KTH-SML/svea_parts/README.md

# svea_parts
https://github.com/KTH-SML/SVEA-PX4-Autopilot-MCU-Peripheral
