KTH-SML/svea_parts/SVEA_Main_Platform.pdf

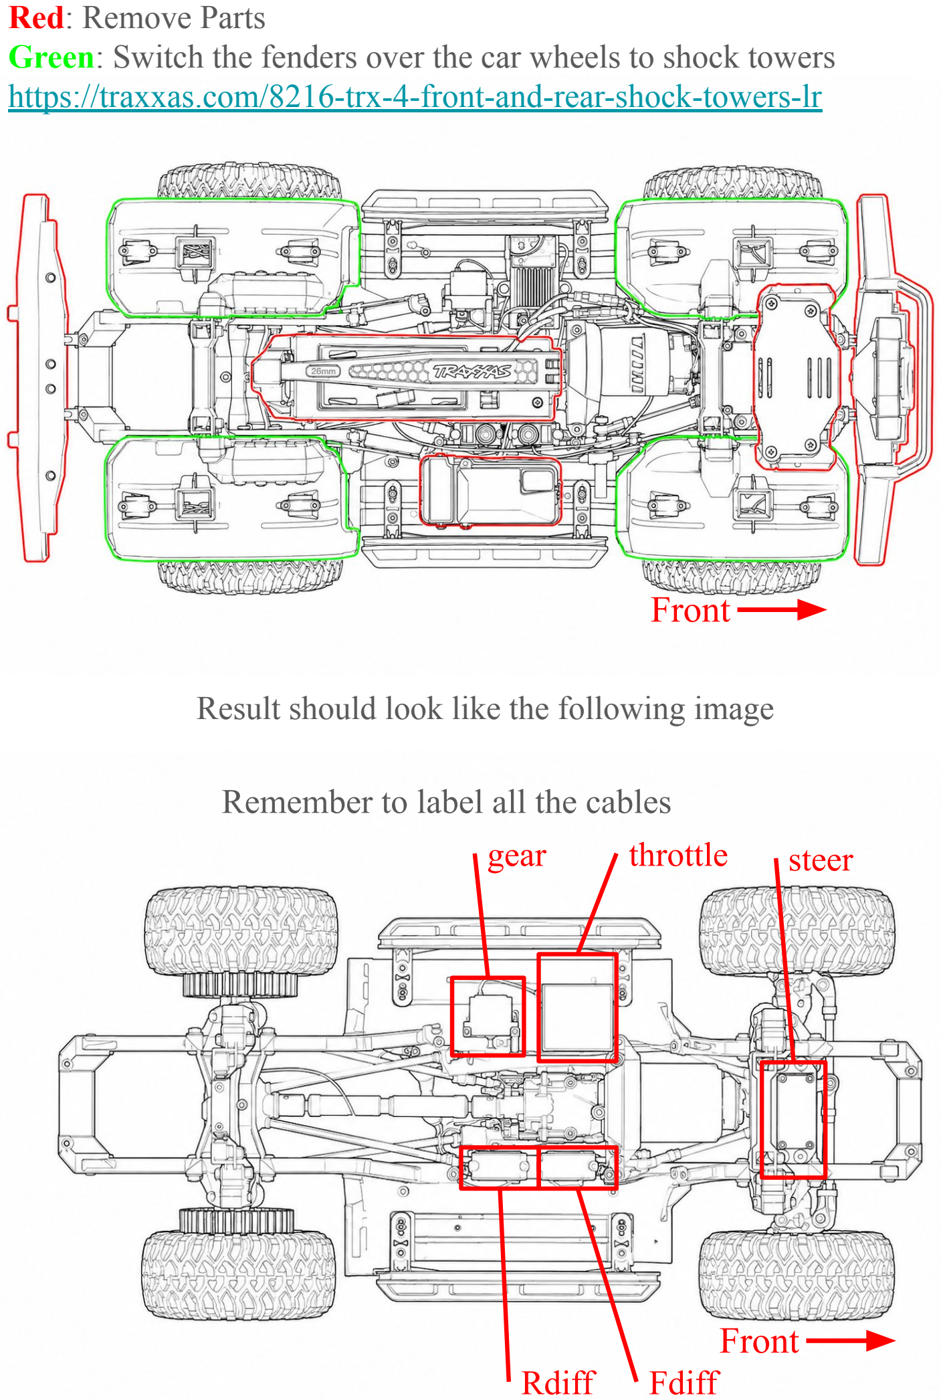
[picture p1: page 1]

Red: Remove Parts
Green: Switch the fenders over the car wheels to shock towers https://traxxas.com/8216-trx-4-front-and-rear-shock-towers-lr

Result should look like the following image

Rdiff | Fdiff
gear | throttle | steer

Remember to label all the cables

Front

Front

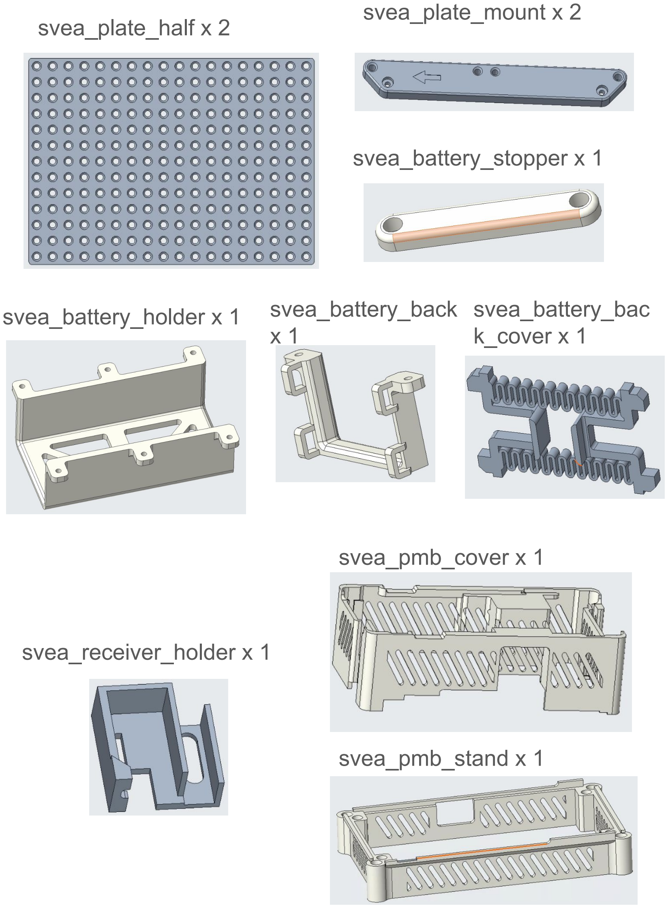
[picture p2: page 2]

svea_plate_half x 2

svea_battery_holder x 1 svea_battery_back x 1 svea_battery_bac
k_cover x 1

svea_receiver_holder x 1

svea_pmb_stand x 1

svea_pmb_cover x 1

svea_plate_mount x 2

svea_battery_stopper x 1

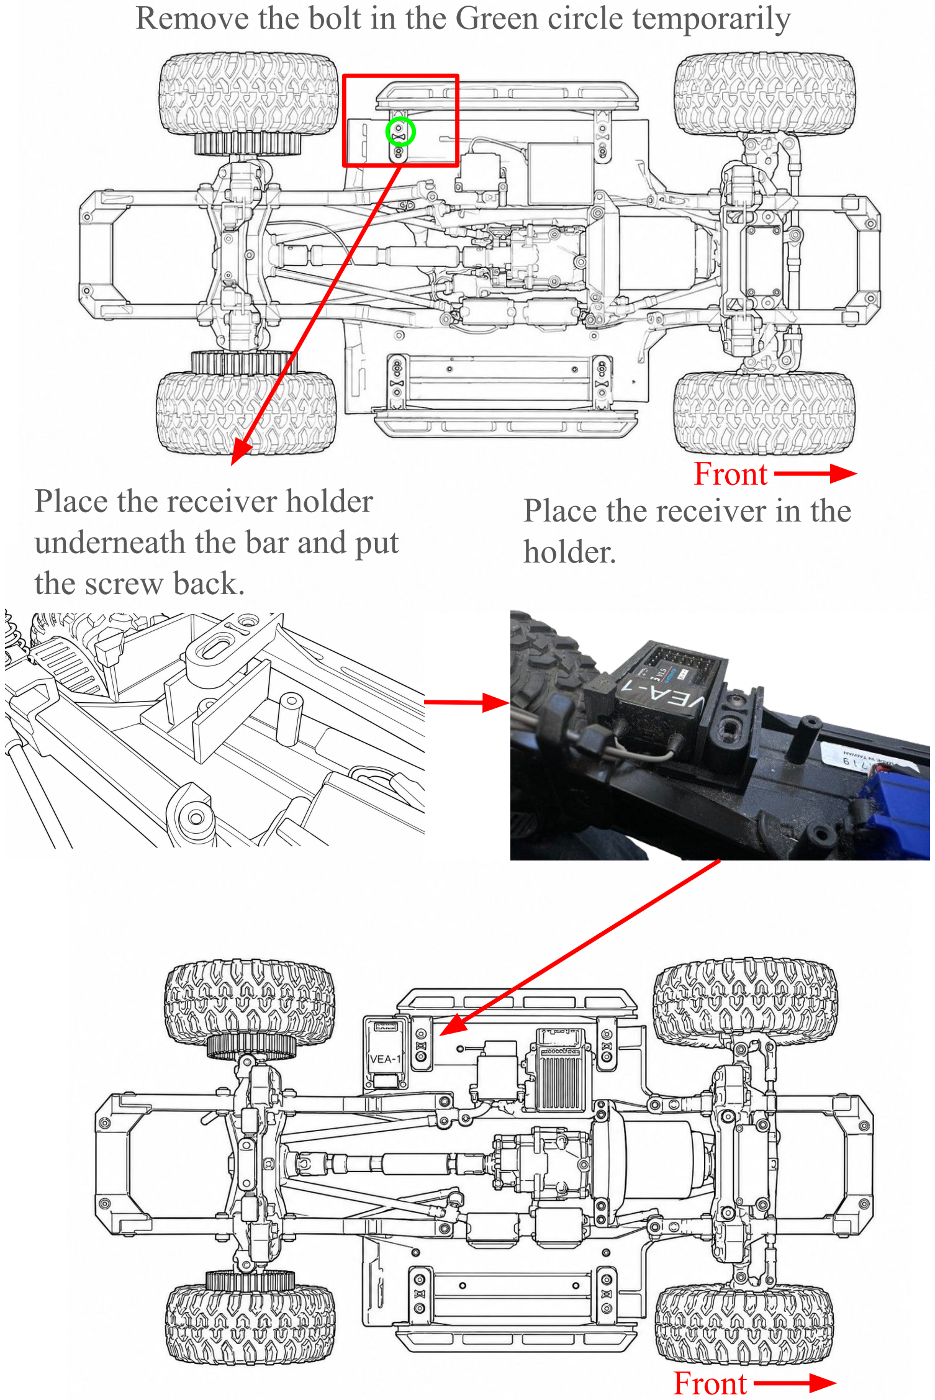
[picture p3: page 3]

Remove the bolt in the Green circle temporarily

Place the receiver holder
underneath the bar and put the screw back.

Place the receiver in the
holder.

Front

Front

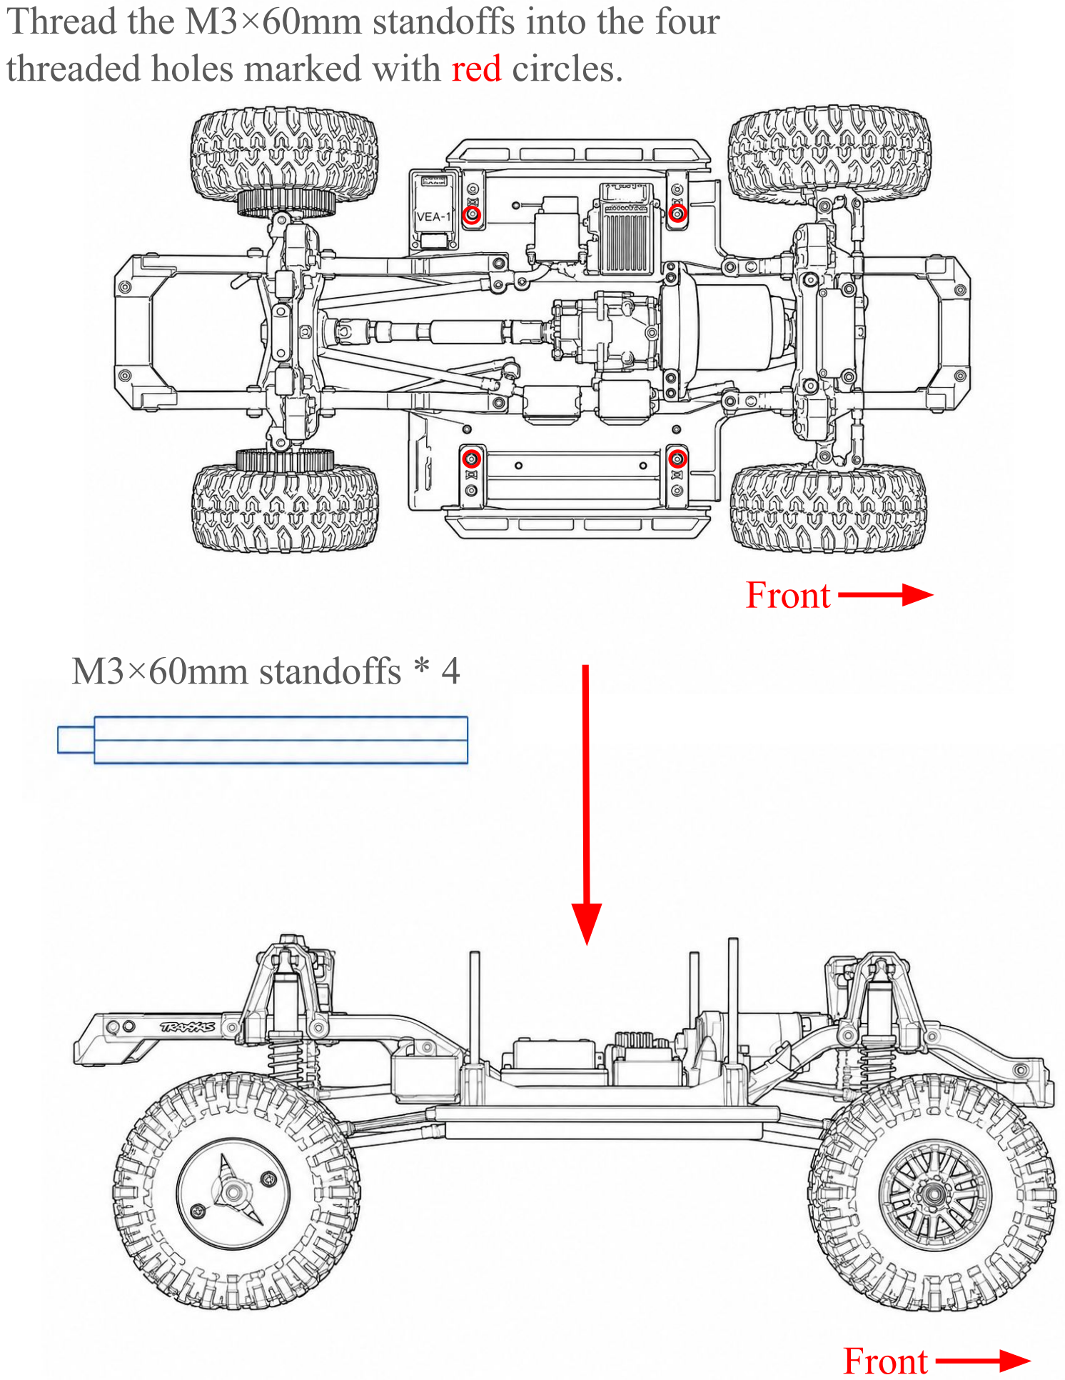
[picture p4: page 4]

Thread the M3×60mm standoffs into the four threaded holes marked with red circles.

M3×60mm standoffs * 4

Front

Front

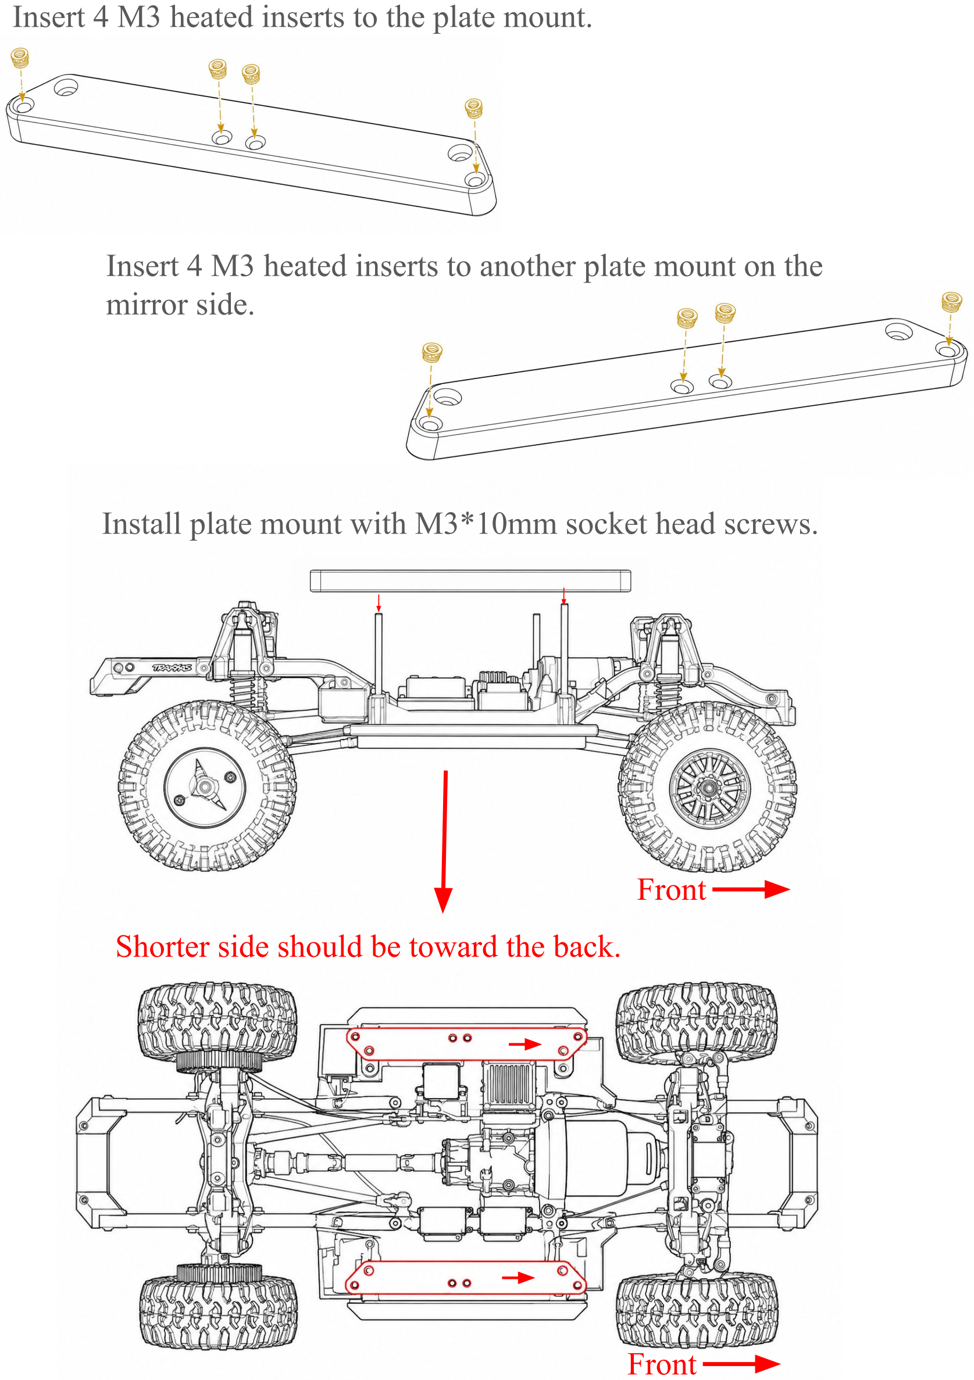
[picture p5: page 5]

Insert 4 M3 heated inserts to the plate mount.

Insert 4 M3 heated inserts to another plate mount on the mirror side.

Install plate mount with M3*10mm socket head screws.

| Front

Shorter side should be toward the back.

Front

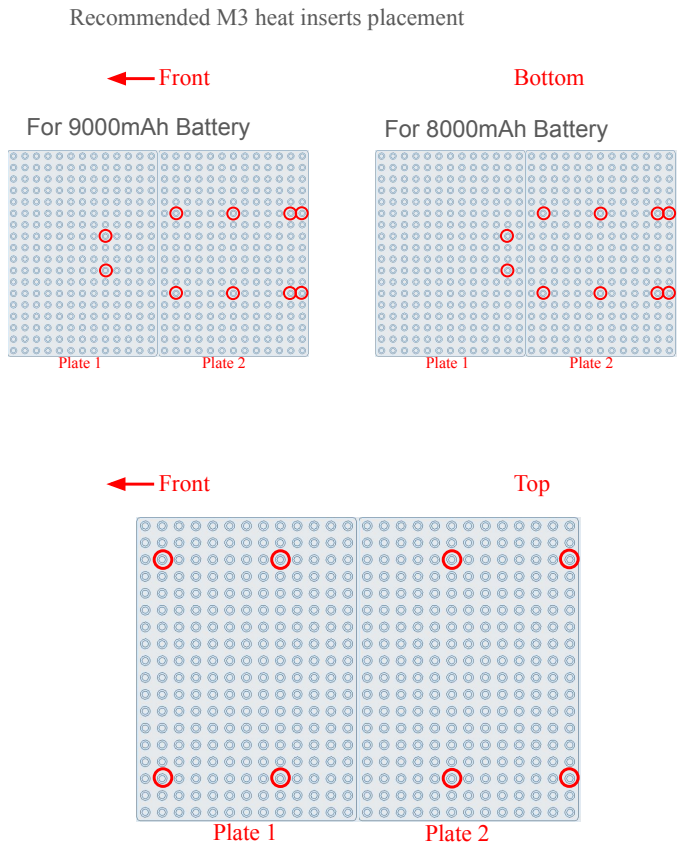
[picture p6: page 6]
Front; Bottom; Top; Plate 1; Plate 2; For 9000mAh Battery; For 8000mAh Battery

Recommended M3 heat inserts placement

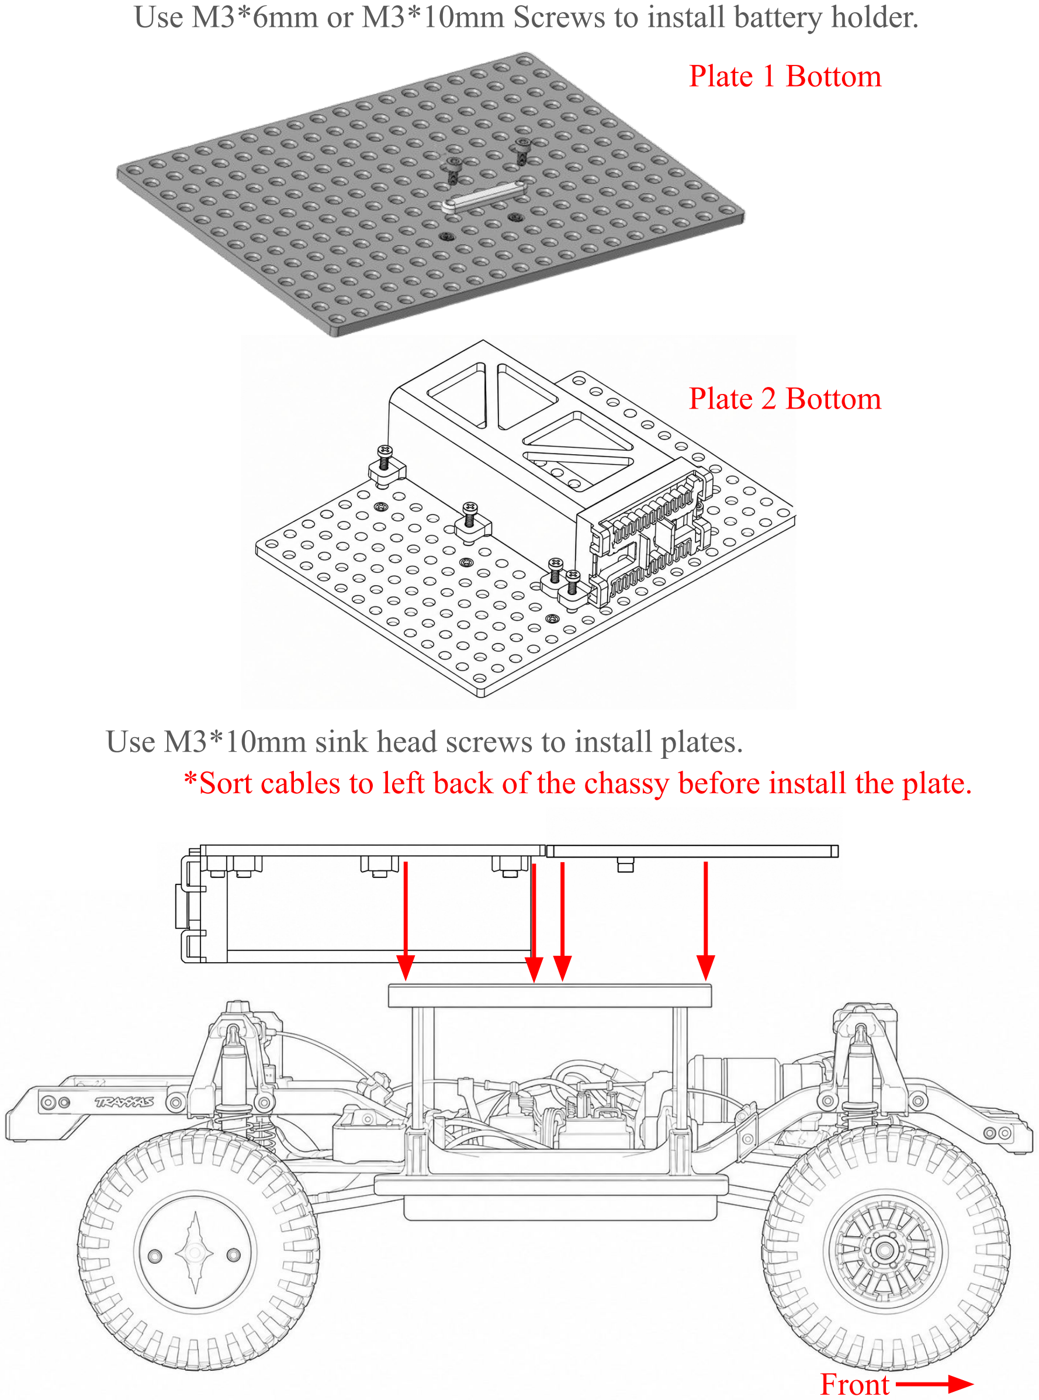
[picture p7: page 7]

Use M3*6mm or M3*10mm Screws to install battery holder.

Plate 2 Bottom

Plate 1 Bottom

Use M3*10mm sink head screws to install plates. *Sort cables to left back of the chassy before install the plate.

Front

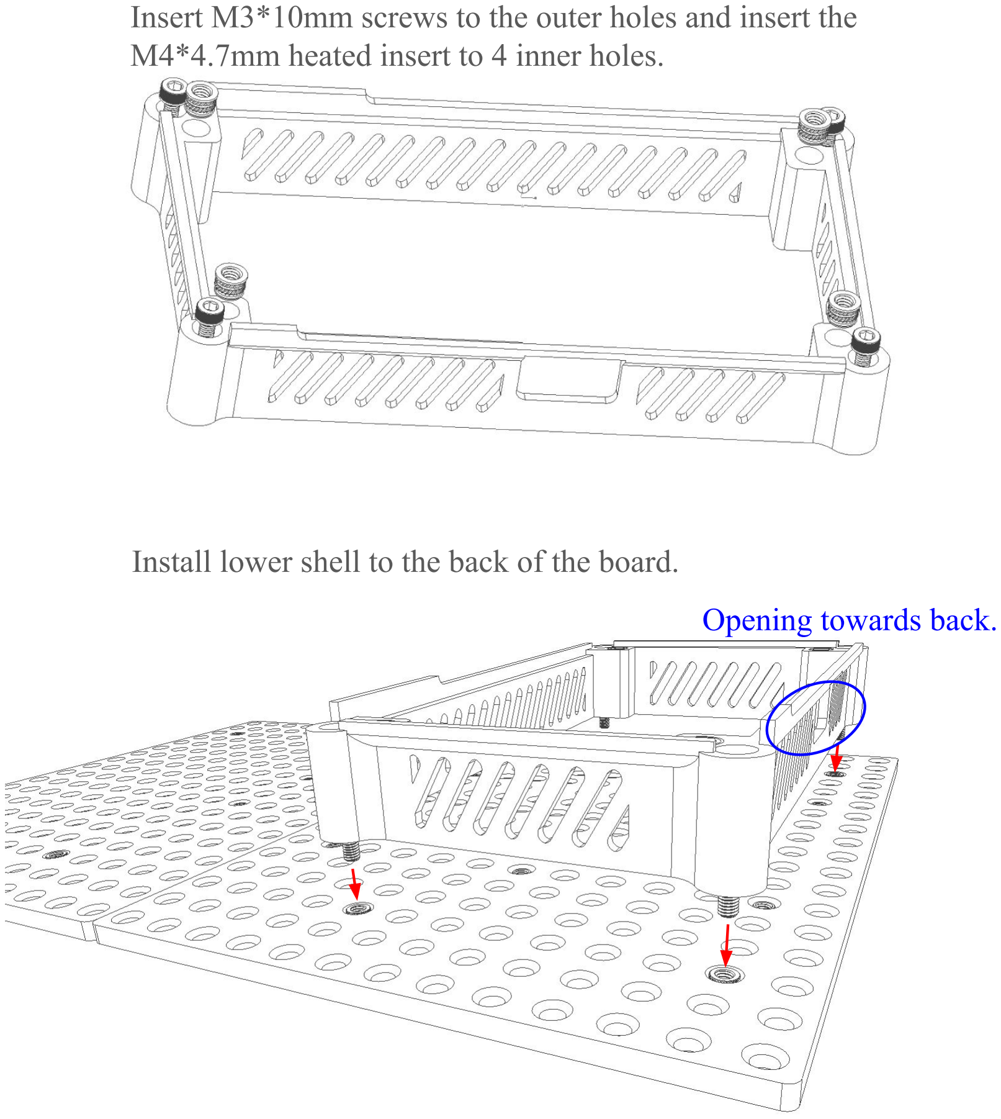
[picture p8: page 8]

Insert M3*10mm screws to the outer holes and insert the M4*4.7mm heated insert to 4 inner holes.

Install lower shell to the back of the board.

Opening towards back.

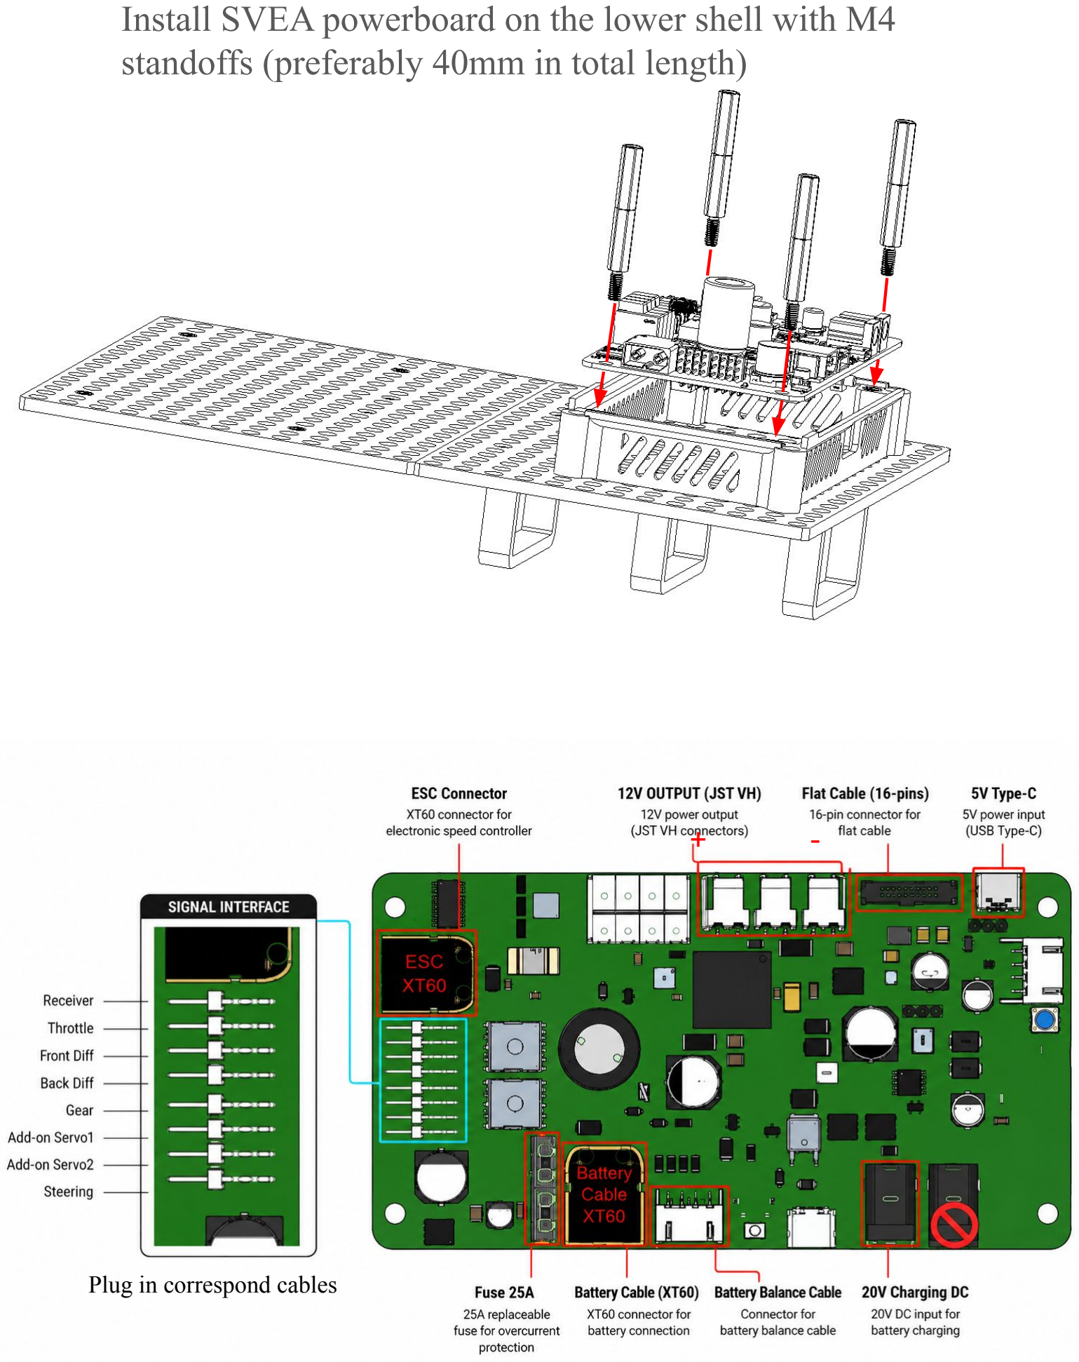
[picture p9: page 9]

Install SVEA powerboard on the lower shell with M4 standoffs (preferably 40mm in total length)

Plug in correspond cables

+ | -

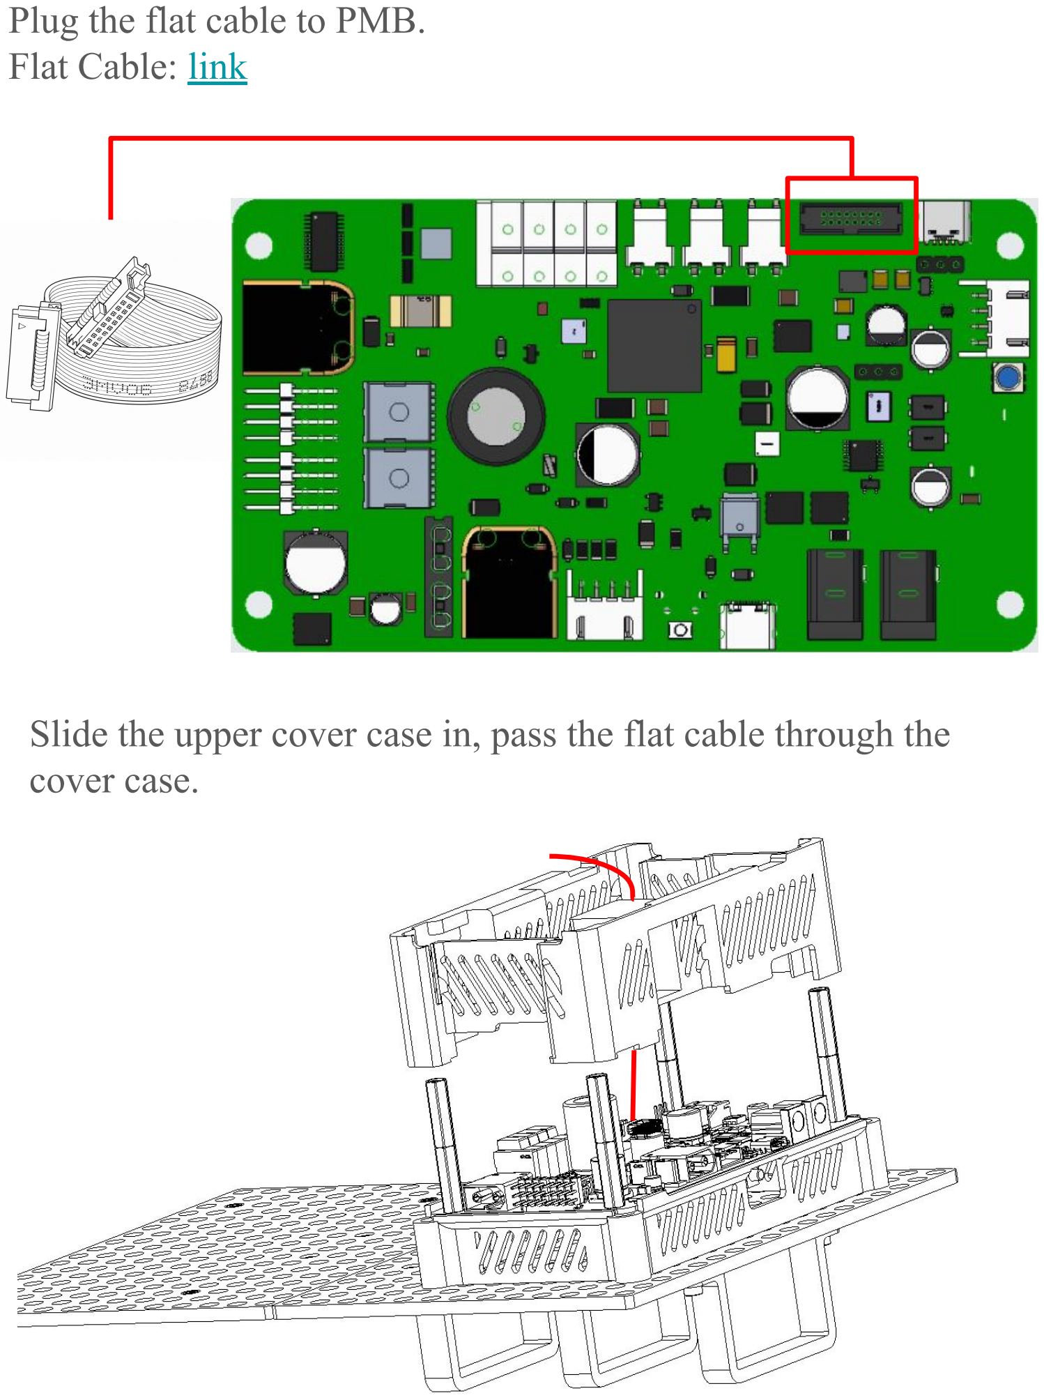
[picture p10: page 10]

Slide the upper cover case in, pass the flat cable through the cover case.

Plug the flat cable to PMB. Flat Cable: link (https://www.mikroe.com/flat-cable-with-16-pin-female-connectors-20-cm)

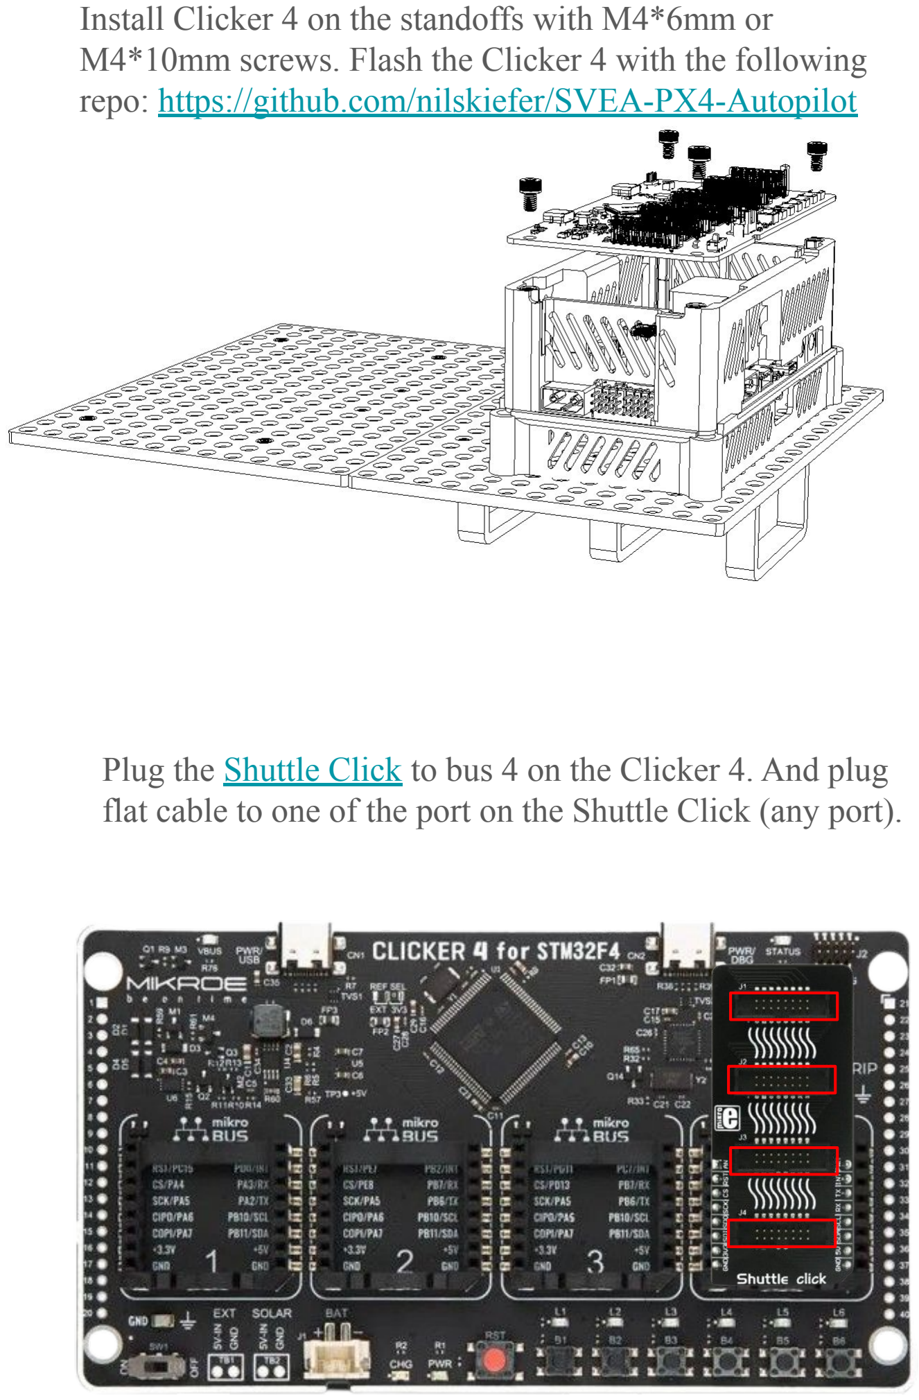
[picture p11: page 11]

Install Clicker 4 on the standoffs with M4*6mm or M4*10mm screws. Flash the Clicker 4 with the following repo: https://github.com/nilskiefer/SVEA-PX4-Autopilot

Plug the Shuttle Click (https://www.mikroe.com/shuttle-click) to bus 4 on the Clicker 4. And plug flat cable to one of the port on the Shuttle Click (any port).

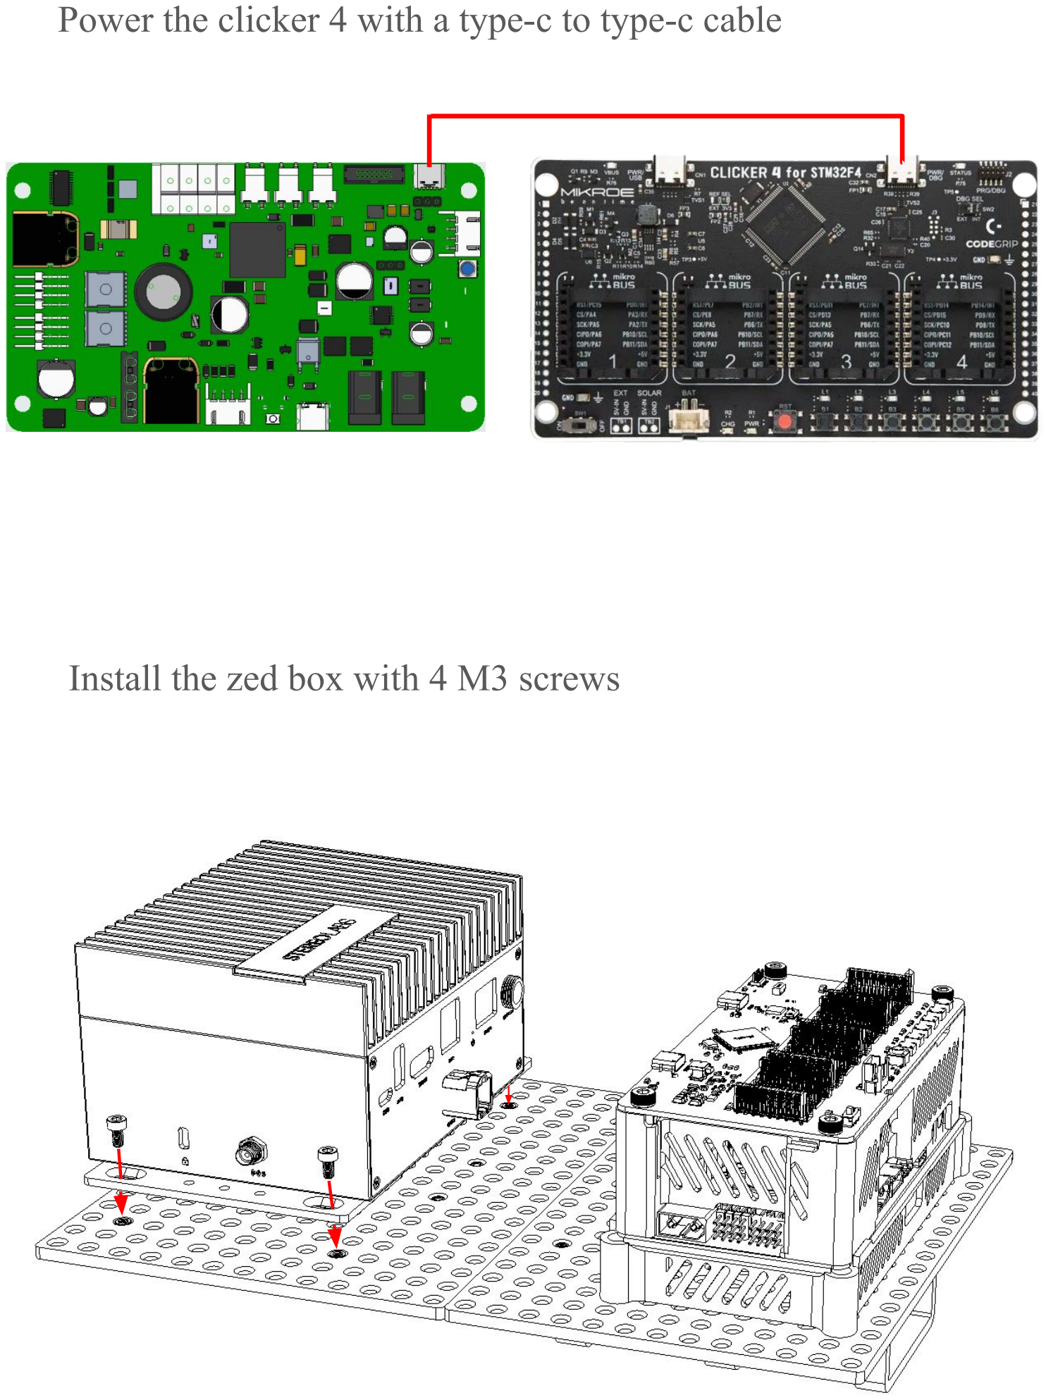
[picture p12: page 12]

Install the zed box with 4 M3 screws

Power the clicker 4 with a type-c to type-c cable

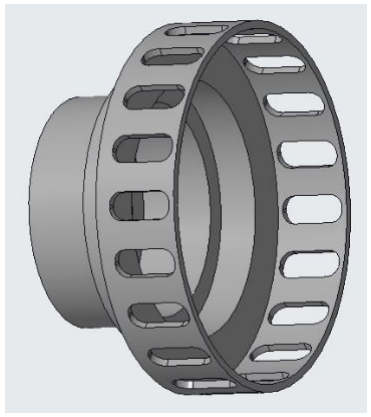
[picture p13: figure]
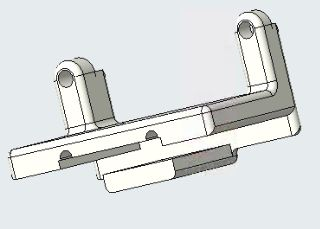
[picture p14: figure]

svea_esp32_mount x 1

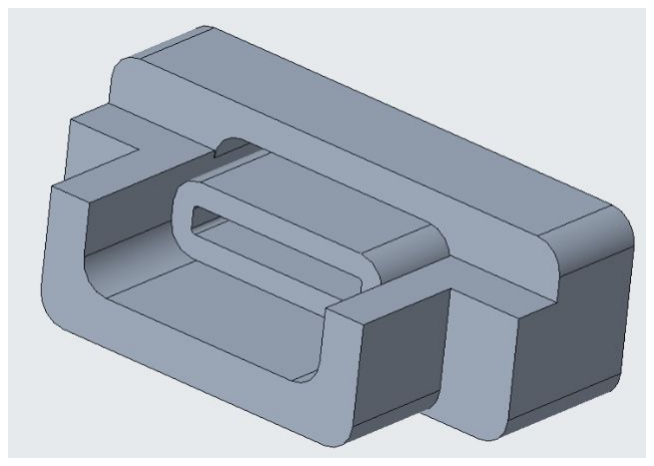
[picture p15: figure]

svea_esp32_type_c_plug x 1

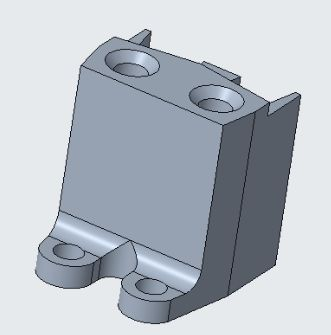
[picture p16: figure]

svea_duel_encoders_mount
x 2

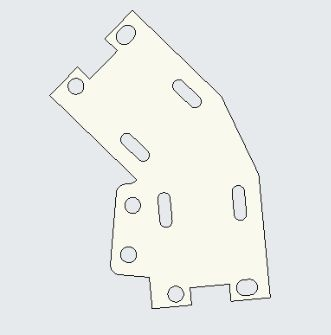
[picture p17: figure]

svea_duel_encoders_plate
x 2

svea_wheel_encoder x 2

## Encoder

Install h2010 IR sensor to the Insert the m3 heat insert to

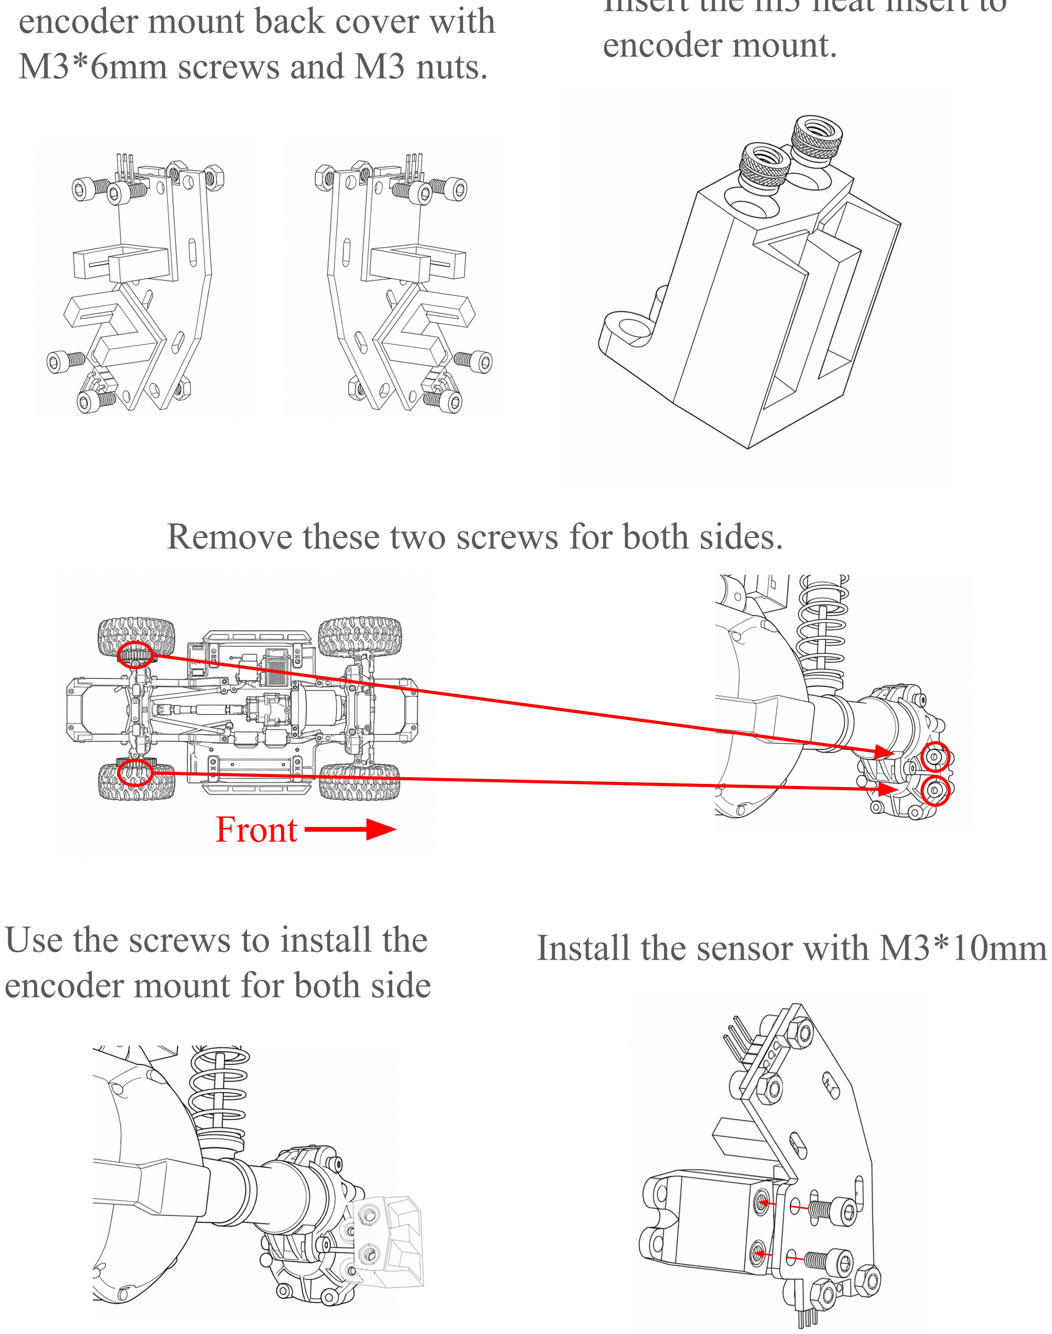
[picture p18: figure]
encoder mount back cover with M3*6mm screws and M3 nuts.; encoder mount.; Remove these two screws for both sides.; Use the screws to install the encoder mount for both side; Install the sensor with M3*10mm; Front

## Encoder Disk

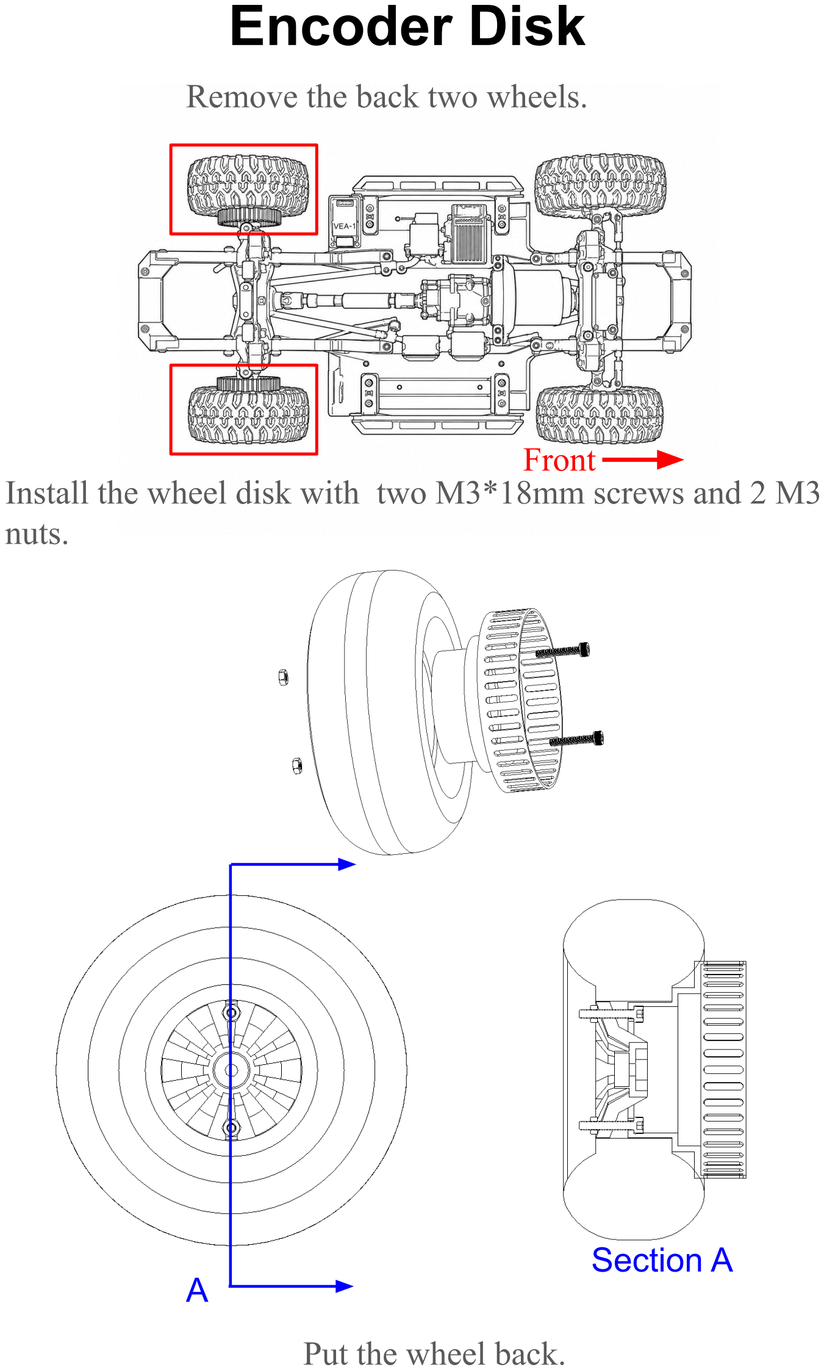
[picture p19: page 15]

Remove the back two wheels.

Install the wheel disk with two M3*18mm screws and 2 M3 nuts.

Put the wheel back.

A

Section A

Front

## Encoder Chip ESP32

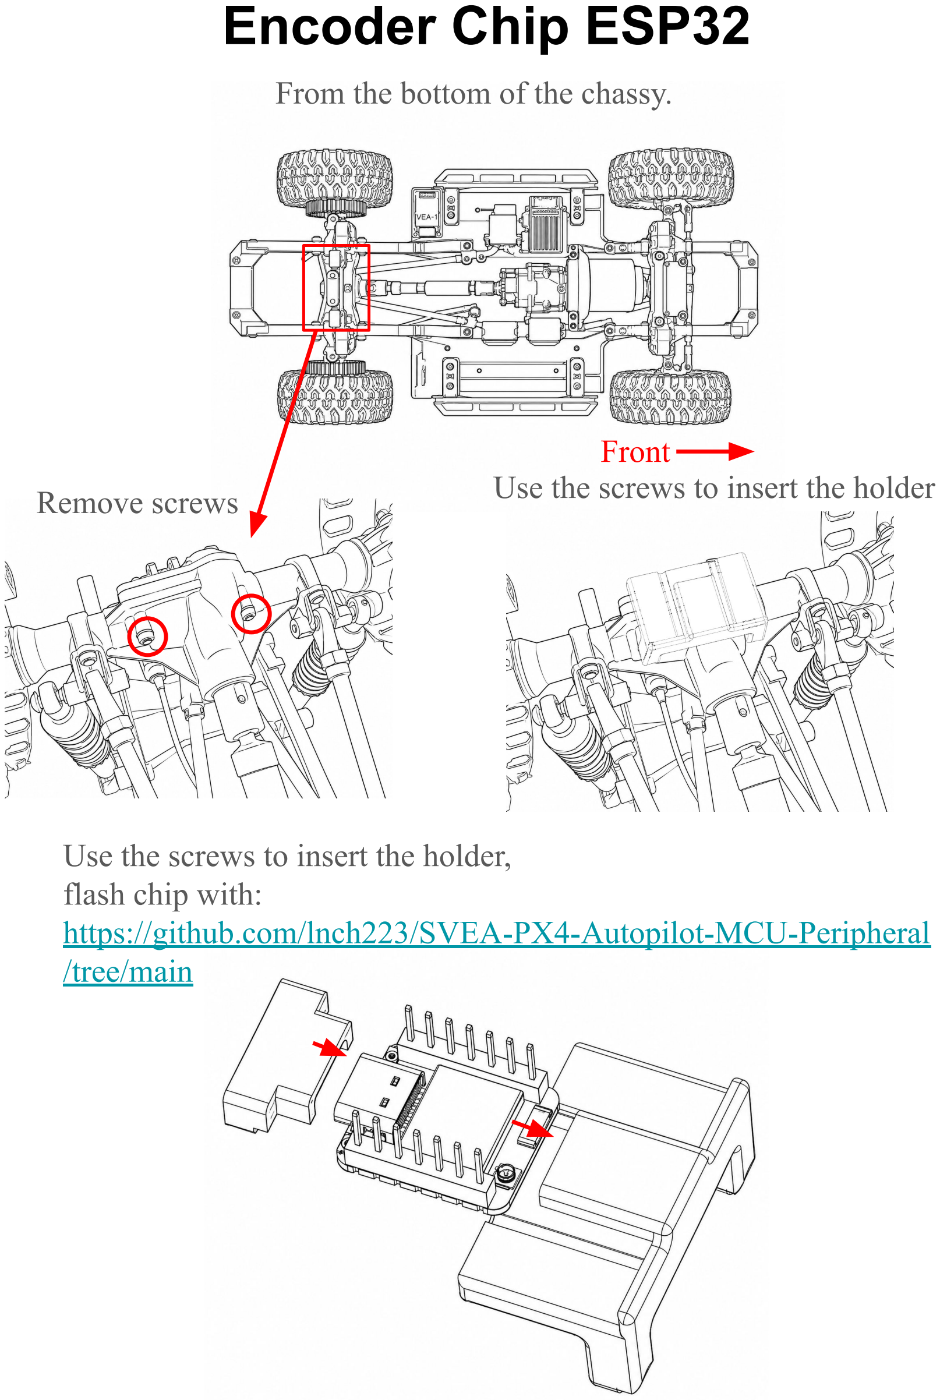
[picture p20: page 16]

From the bottom of the chassy.

Remove screws | Use the screws to insert the holder

Use the screws to insert the holder,
flash chip with:
https://github.com/lnch223/SVEA-PX4-Autopilot-MCU-Peripheral/tree/main (https://github.com/lnch223/SVEA-PX4-Autopilot-MCU-Peripheral/tree/main)

Front

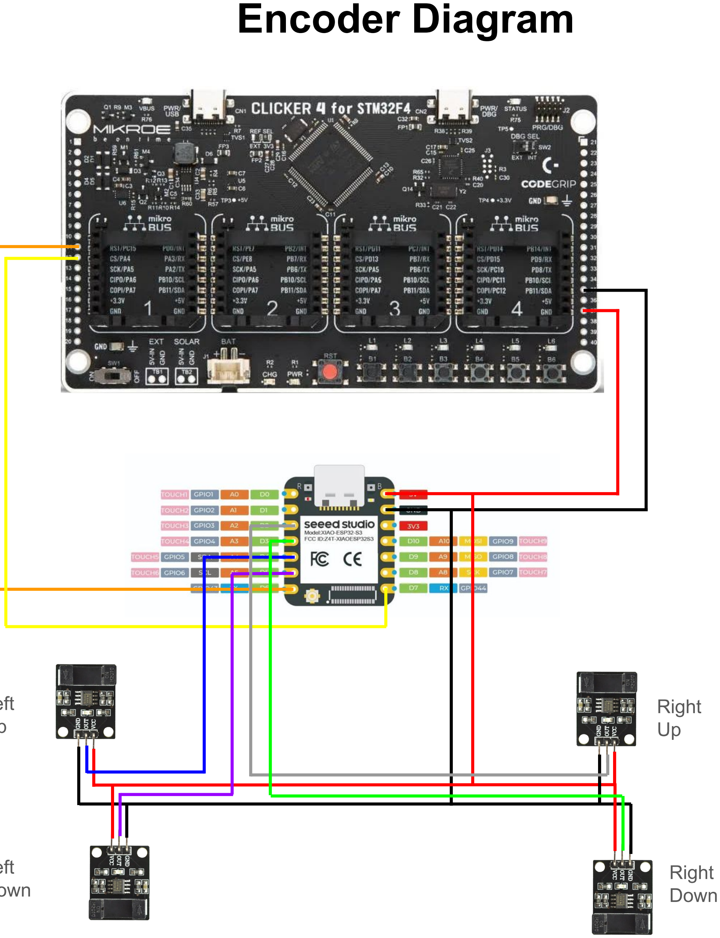
[picture p21: figure]
Down; Right Up; Right Down; Encoder Diagram

Left
Up

Left
