KTH-SML/svea_parts/SVEA_Accessories.pdf

## Lidar

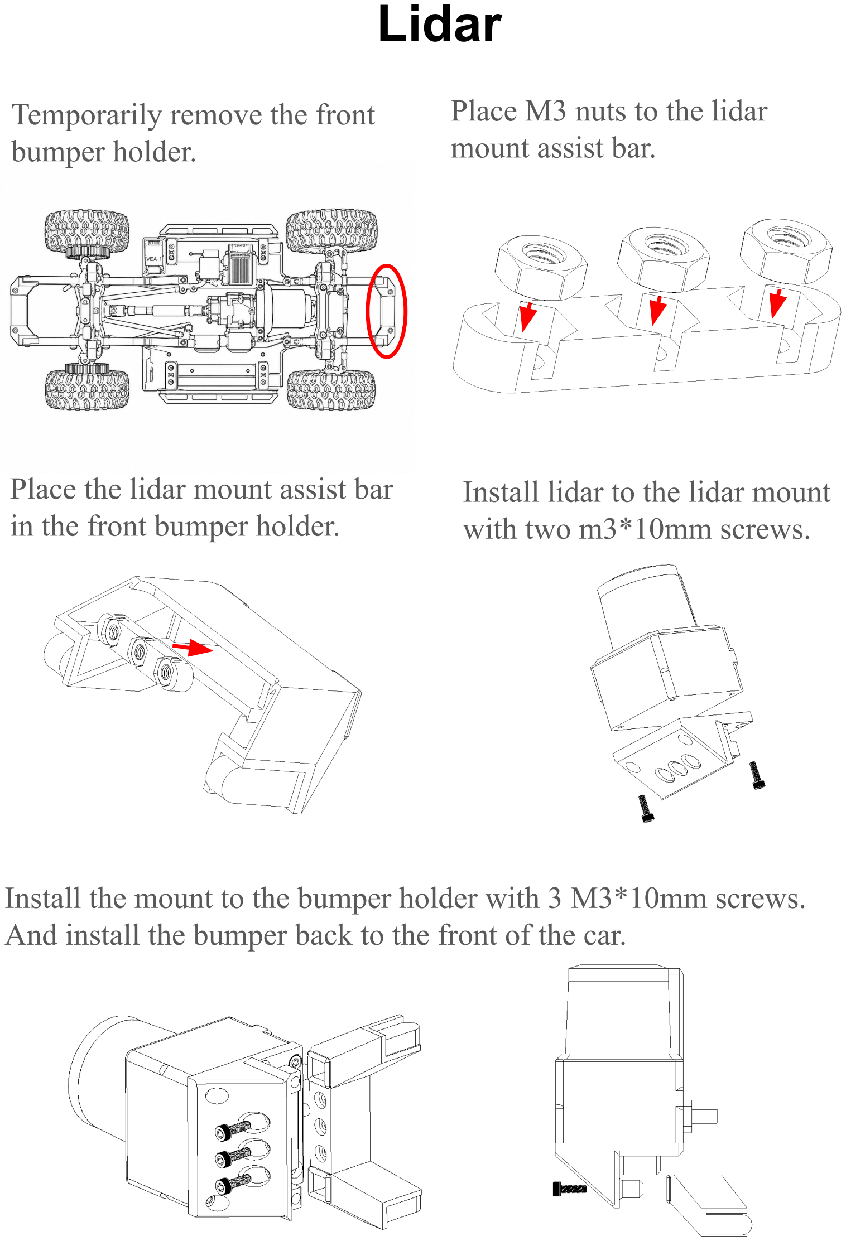
[picture p22: page 1]

Place M3 nuts to the lidar mount assist bar.

Temporarily remove the front bumper holder.

Place the lidar mount assist bar in the front bumper holder.

Install lidar to the lidar mount with two m3*10mm screws.

Install the mount to the bumper holder with 3 M3*10mm screws. And install the bumper back to the front of the car.

Install camera on a 5 by 5 small platform with M3x10mm screws.

## Camera Mount

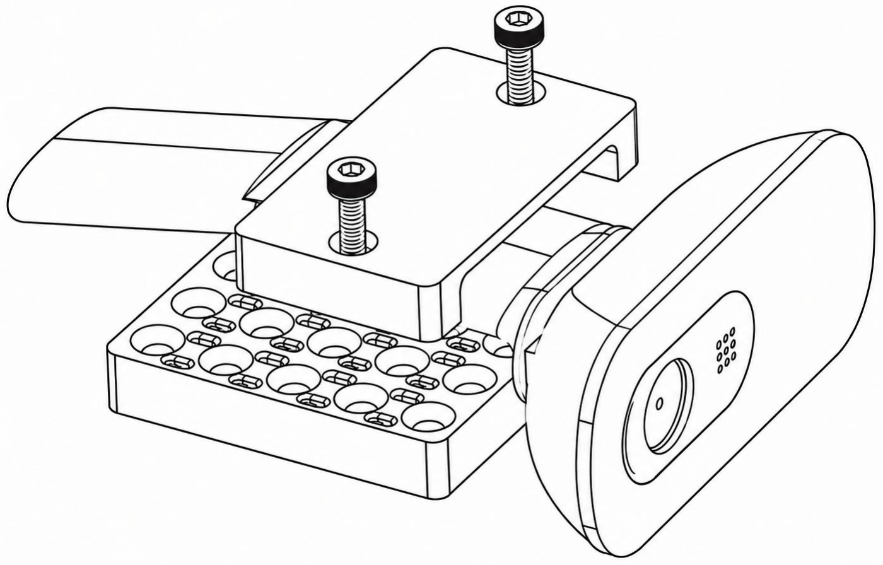
[picture p23: figure]

Budget version: Replace lidar

Normal version: On top of lidar hat

## Tail Mount

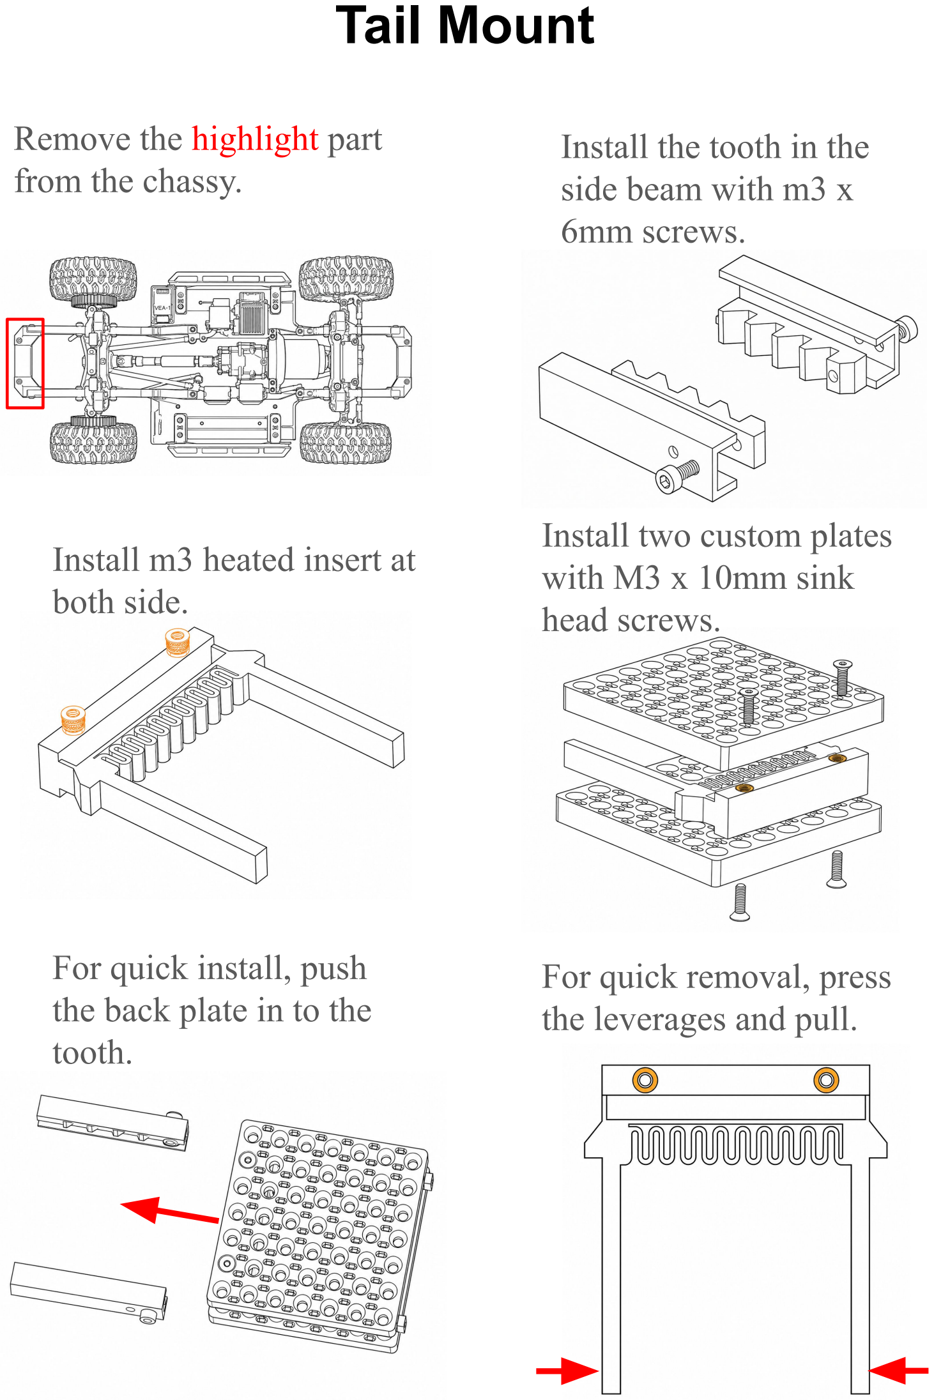
[picture p24: page 3]

Install the tooth in the
side beam with m3 x
6mm screws.

Remove the highlight part
from the chassy.

Install m3 heated insert at both side.

Install two custom plates
with M3 x 10mm sink
head screws.

For quick install, push
the back plate in to the
tooth.

For quick removal, press
the leverages and pull.
