KTH-SML/svea_parts/SVEA_Charging.pdf

Install printed arm and servo arm together with M2.5 * 6mm screw and M2.5 nut

## Charging Arm

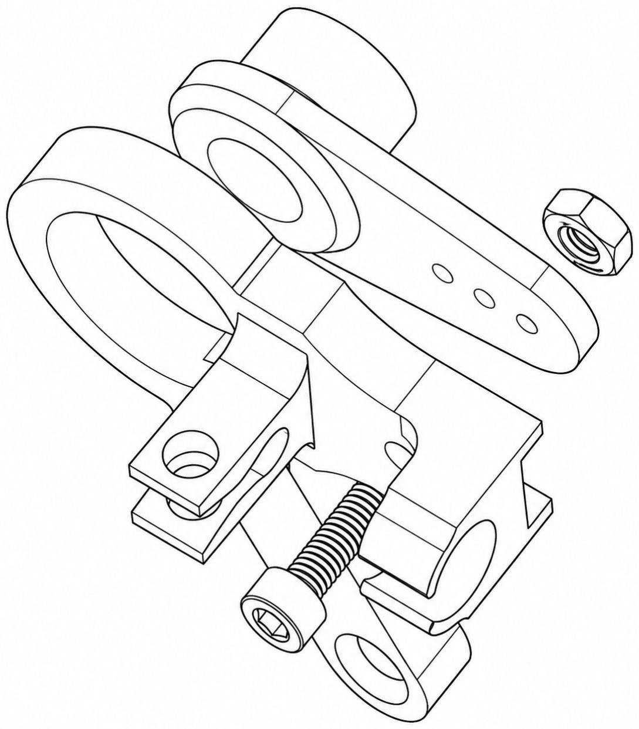
[picture p25: figure]

Hold the magnetic charging cable with M3 * 6mm screw and M3 nut

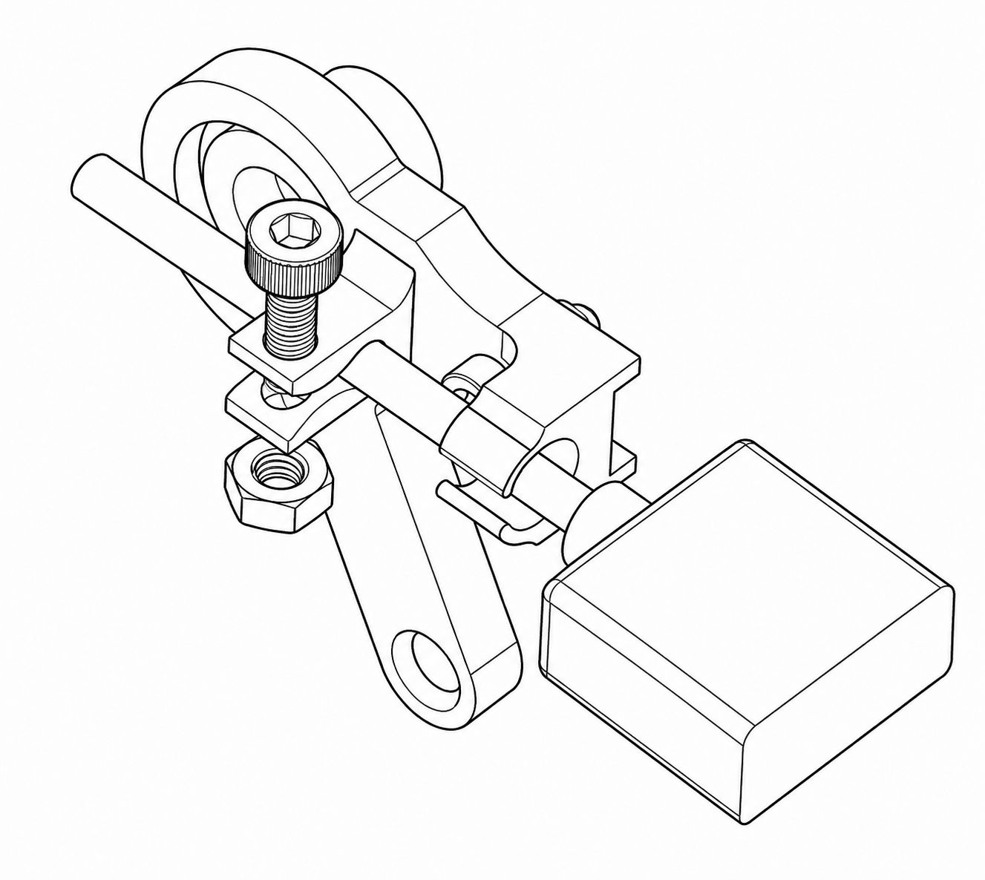
[picture p26: figure]

## Charging Box - heated inserts

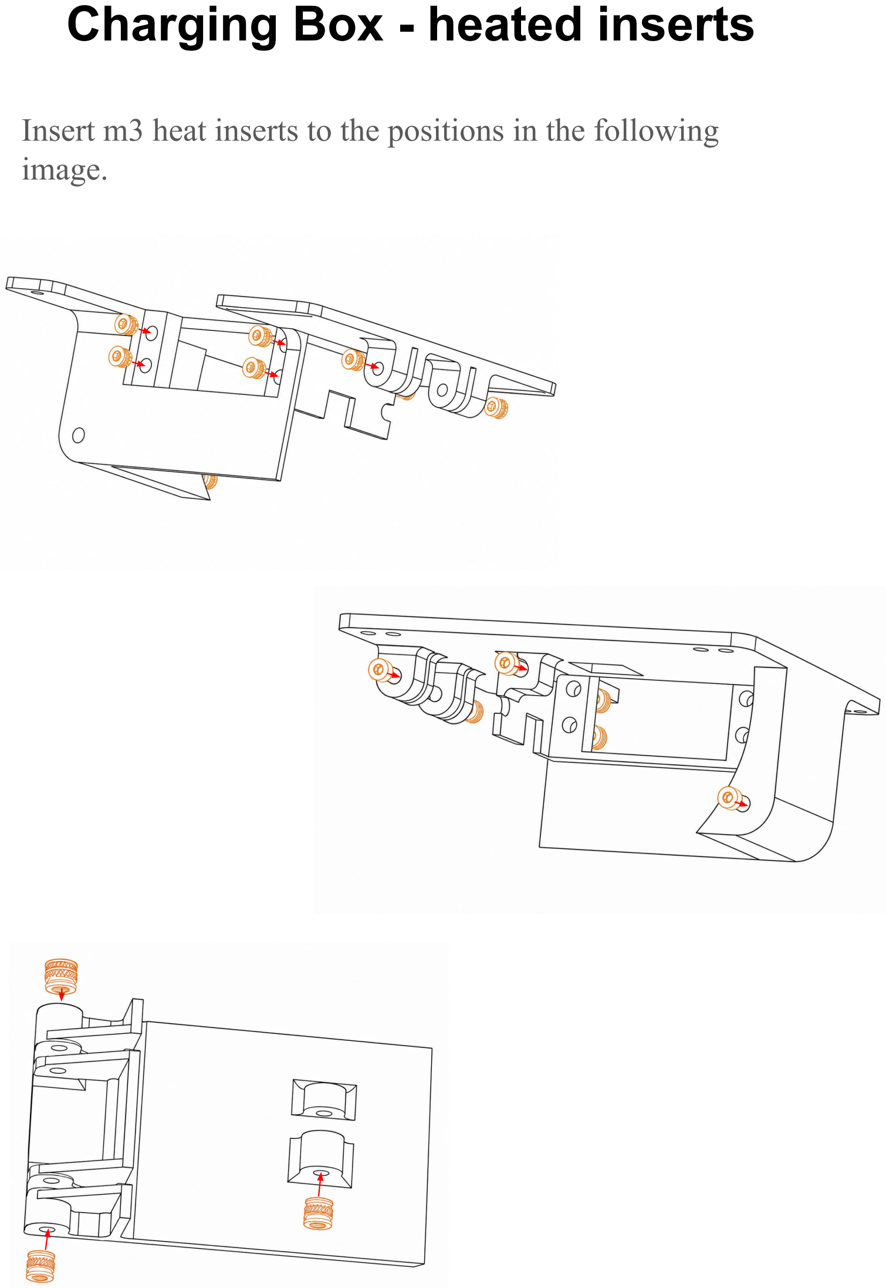
[picture p27: page 2]

Insert m3 heat inserts to the positions in the following image.

## Charging Box - Assembly

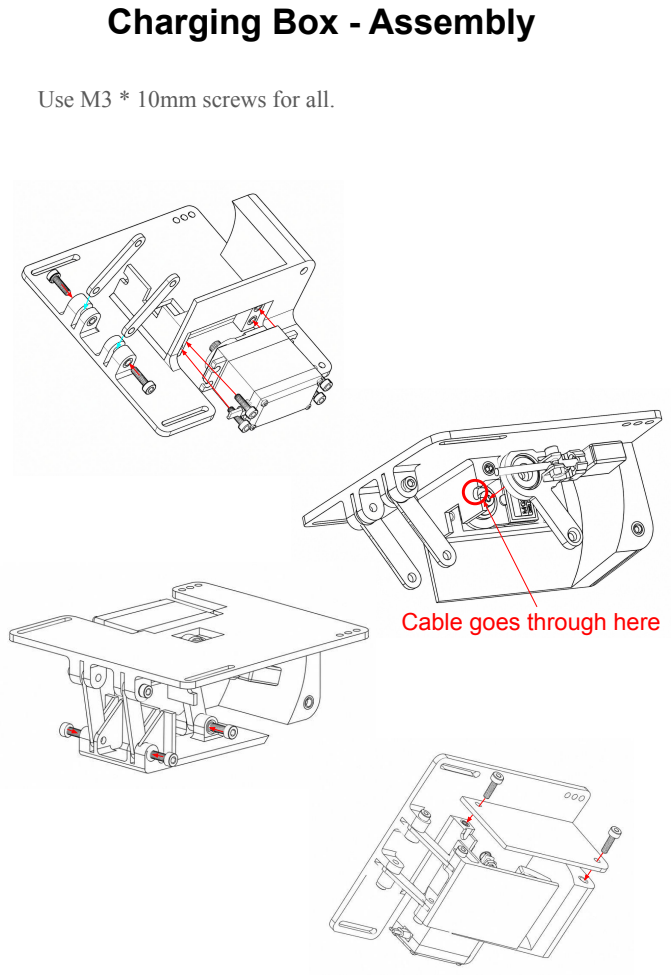
[picture p28: page 3]

Use M3 * 10mm screws for all.

Cable goes through here
