KTH-SML/svea_parts/stl/encoder/SVEA_single_encoder.pdf

## Encoder

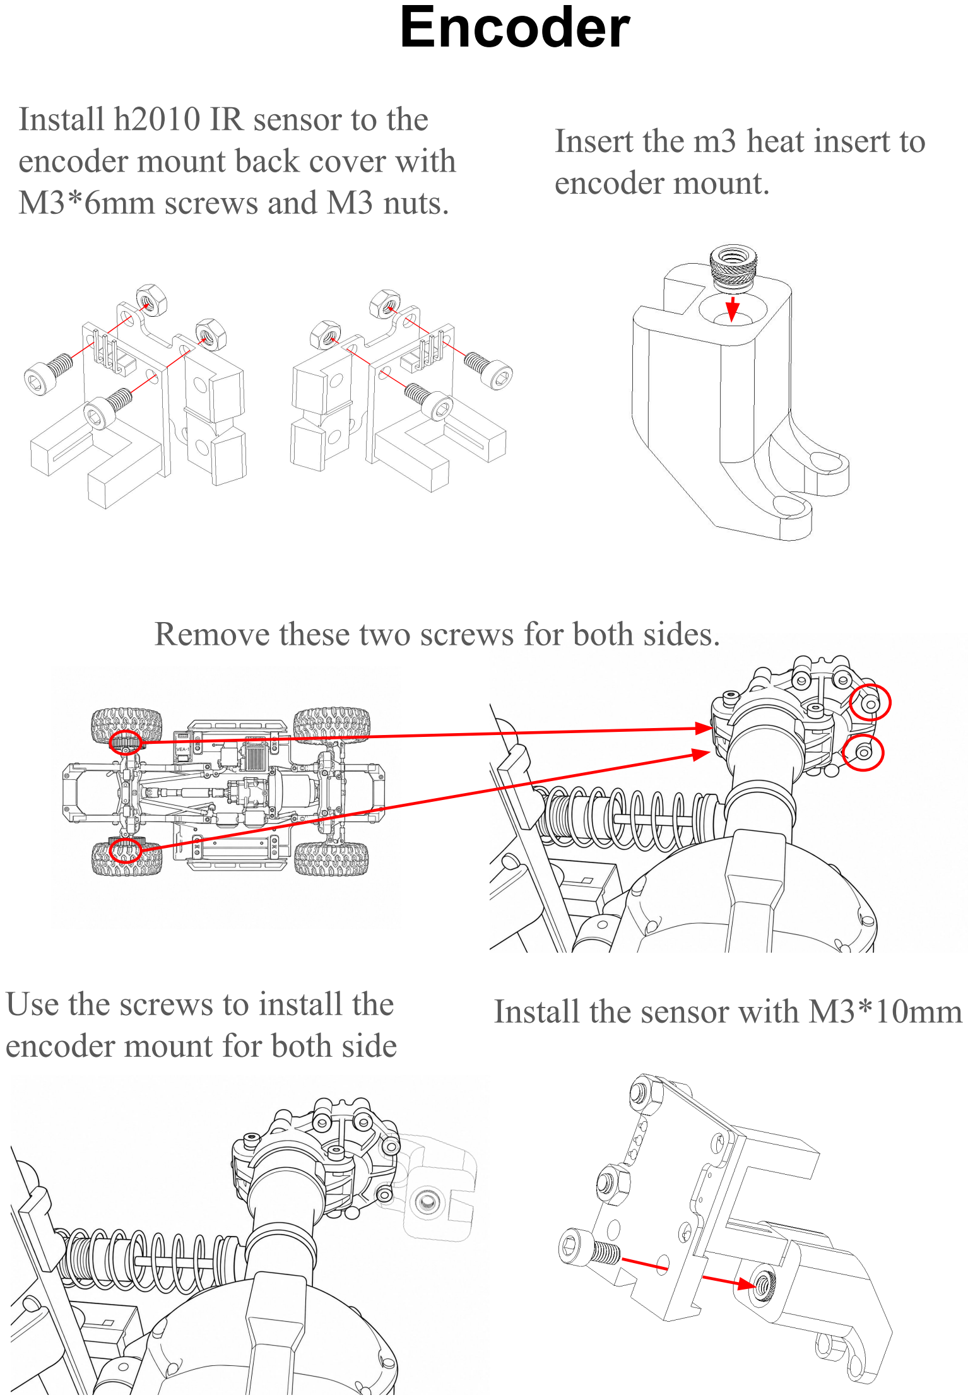
[picture p29: page 1]

Install h2010 IR sensor to the encoder mount back cover with M3*6mm screws and M3 nuts.

Insert the m3 heat insert to encoder mount.

Remove these two screws for both sides.

Use the screws to install the encoder mount for both side

Install the sensor with M3*10mm
