KTH-SML/svea_parts/stp/svea_tail_asm.stp

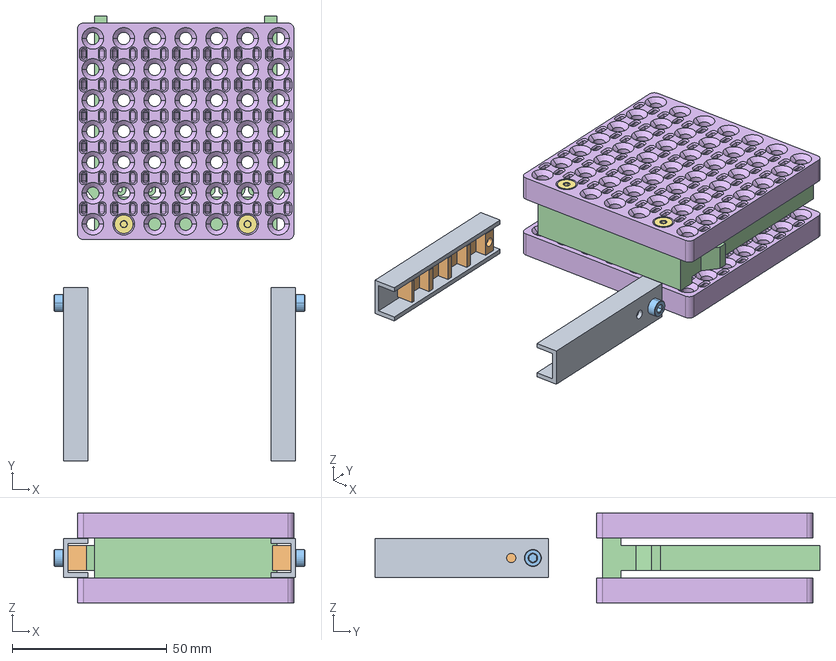
[picture p32: CAD file, 2026-08-24]
stp/svea_tail_asm.stp
81.0 x 143.8 x 29.0 mm
CHASSY_BACK
BACK_SIDE x 2
M3_6 x 2
BACK_MECH_THICK_SPRING
M3_INSERT x 2
7X7 x 2
M3X10_SINK x 4
