KTH-SML/svea_parts/stp/svea_single_encoder_asm.stp

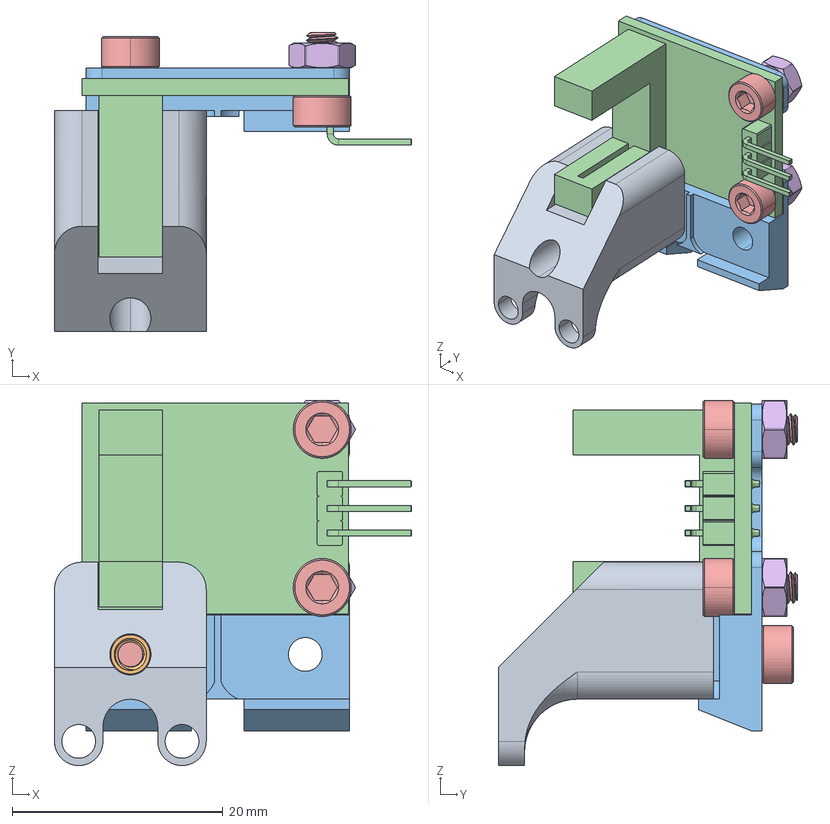
[picture p33: CAD file, 2026-05-22]
stp/svea_single_encoder_asm.stp
33.9 x 28.4 x 34.6 mm
ENCODER_MOUNT
M3_INSERT
ENCODER_MOUNT_BACK_COVER
ENCODER_SENSOR
M3_6 x 3
M3_NUT x 2
