KTH-SML/svea_parts/stl/accessories/camera_holder/svea_camera_holder.stl

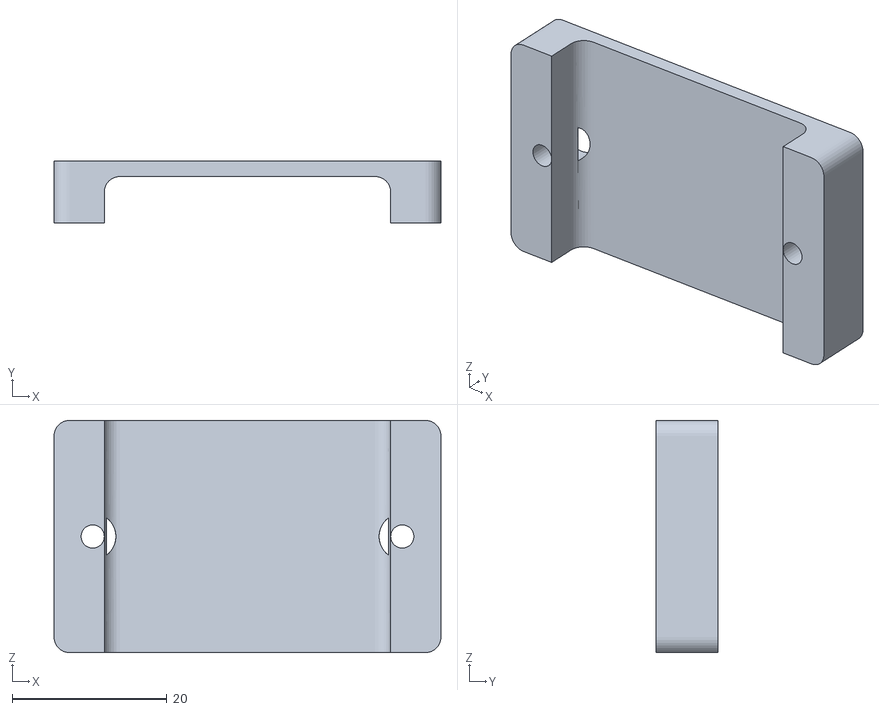
[picture p34: CAD file, 2026-08-24]
stl/accessories/camera_holder/svea_camera_holder.stl
50.0 x 8.00 x 30.0
