KTH-SML/svea_parts/stl/accessories/tail/svea_back_side.stl

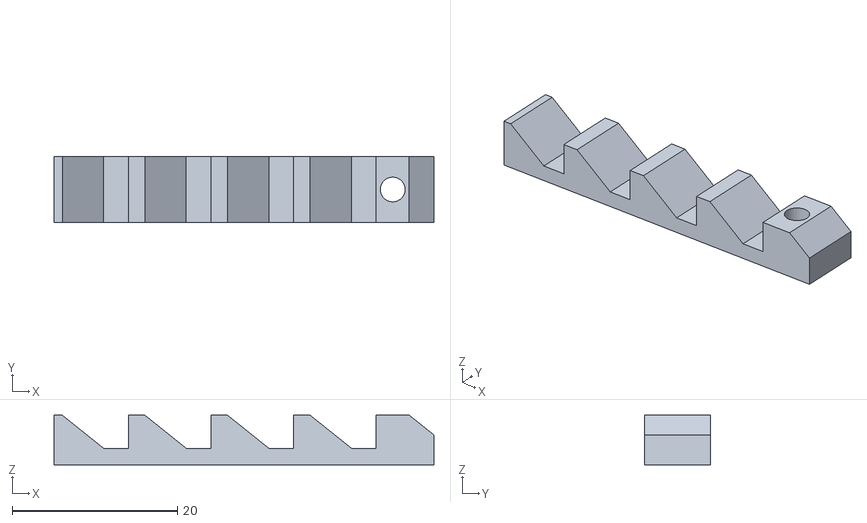
[picture p36: CAD file, 2026-08-24]
stl/accessories/tail/svea_back_side.stl
46.0 x 8.00 x 6.00
