KTH-SML/svea_parts/stl/battery_holder/8000/svea_battery_back_cover_8000.stl

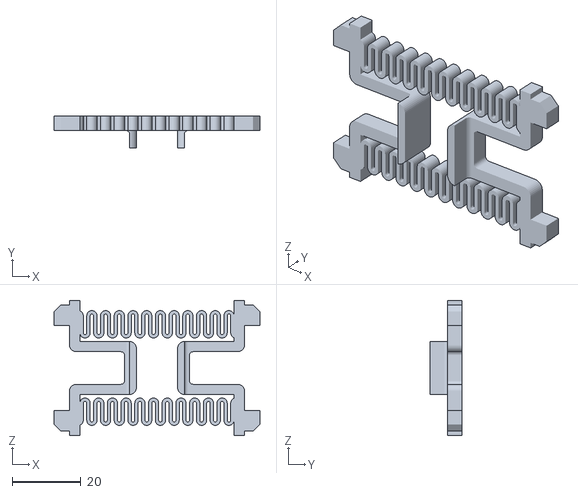
[picture p37: CAD file, 2026-08-24]
stl/battery_holder/8000/svea_battery_back_cover_8000.stl
60.1 x 9.20 x 39.5
