KTH-SML/svea_parts/stl/battery_holder/9000/svea_battery_back_cover_9000.stl

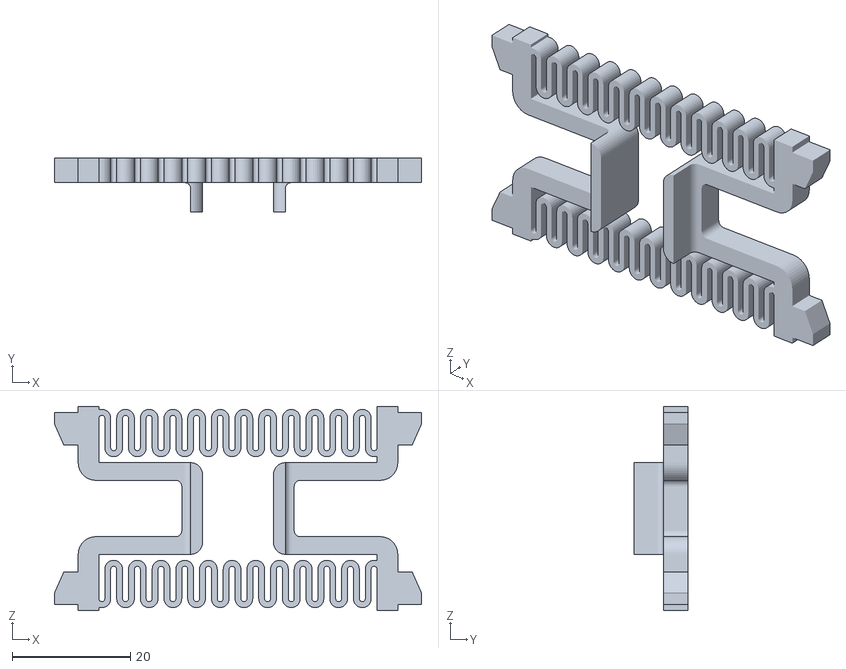
[picture p38: CAD file, 2026-08-24]
stl/battery_holder/9000/svea_battery_back_cover_9000.stl
62.0 x 9.20 x 34.5
