KTH-SML/svea_parts/stl/encoder/duel_encoders/svea_wheel_encoder_20_for_duel.stl

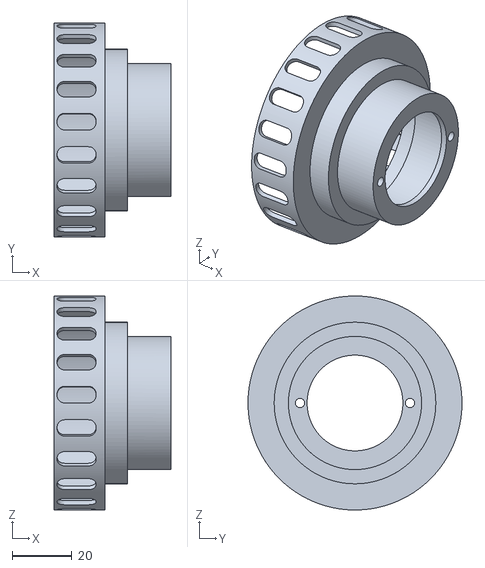
[picture p39: CAD file, 2026-08-24]
stl/encoder/duel_encoders/svea_wheel_encoder_20_for_duel.stl
39.0 x 71.5 x 71.5
