KTH-SML/svea_parts/stl/encoder/single_encoder/svea_single_encoder_plate.stl

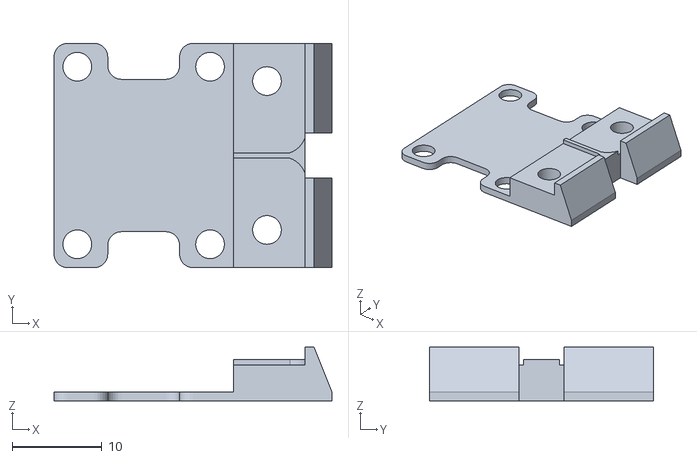
[picture p40: CAD file, 2026-05-22]
stl/encoder/single_encoder/svea_single_encoder_plate.stl
31.0 x 25.0 x 6.00
