KTH-SML/svea_parts/stl/encoder/svea_esp32_type_c_plug_use_tpu.stl

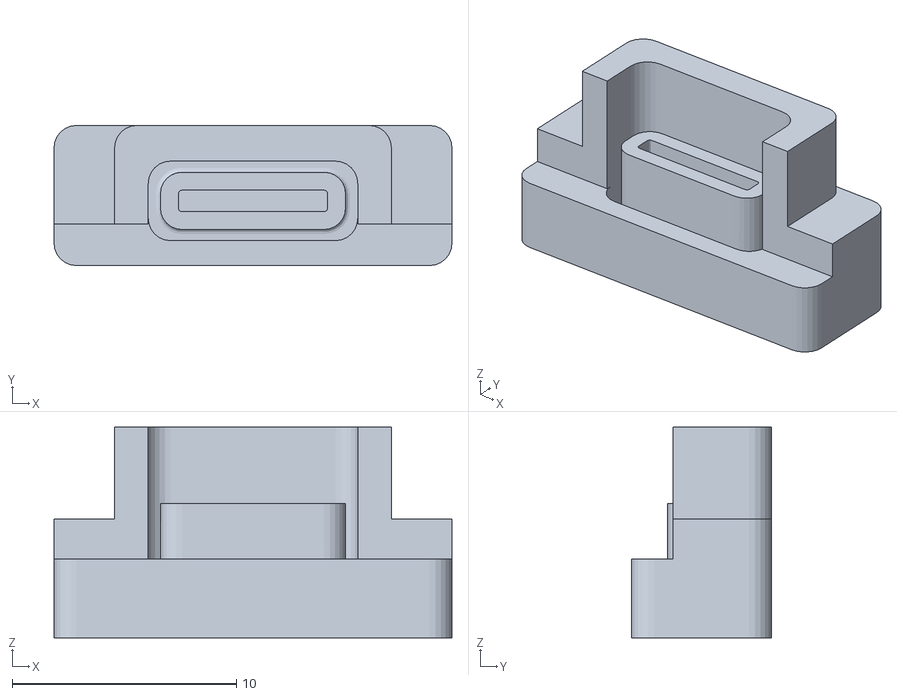
[picture p41: CAD file, 2026-08-24]
stl/encoder/svea_esp32_type_c_plug_use_tpu.stl
17.7 x 6.25 x 9.40
