KTH-SML/svea_parts/stl/svea_pmb_stand.stl

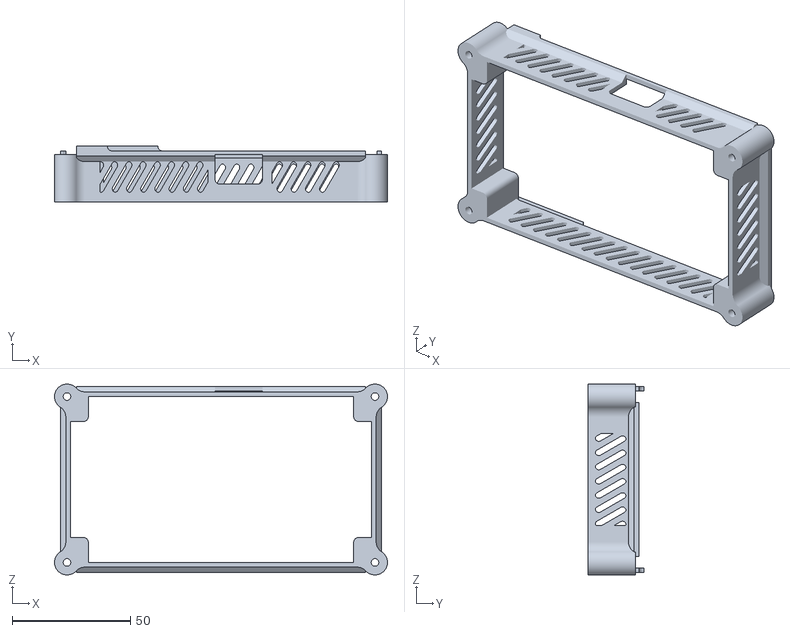
[picture p42: CAD file, 2026-08-24]
stl/svea_pmb_stand.stl
140.6 x 23.5 x 80.6
