KTH-SML/svea_parts/svea2.0/Sulthan Cam Pole Lidarr Adapter v6.iges

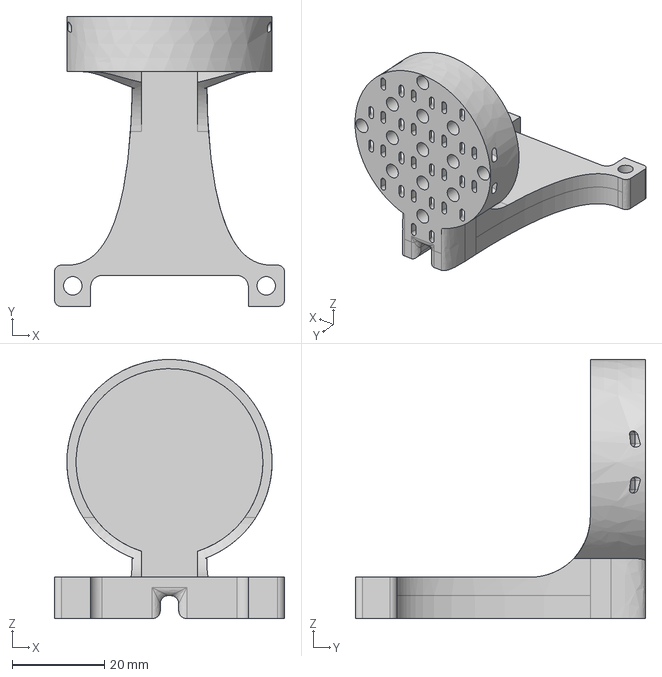
[picture p43: CAD file, 2026-05-13]
svea2.0/Sulthan Cam Pole Lidarr Adapter v6.iges
50.0 x 63.0 x 56.3 mm
