KTH-SML/svea_parts/svea_charging_parts/2d_LaserCutter/LaserCutterdxf/platformRampLong.dxf

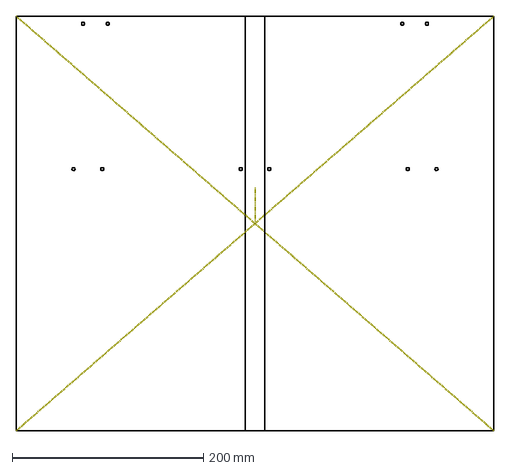
[picture p44: CAD file, 2026-08-13]
svea_charging_parts/2d_LaserCutter/LaserCutterdxf/platformRampLong.dxf
500.0 x 434.0 mm
