KTH-SML/svea_parts/svea_charging_parts/aruco_marker_holder/arucoMarker.stl

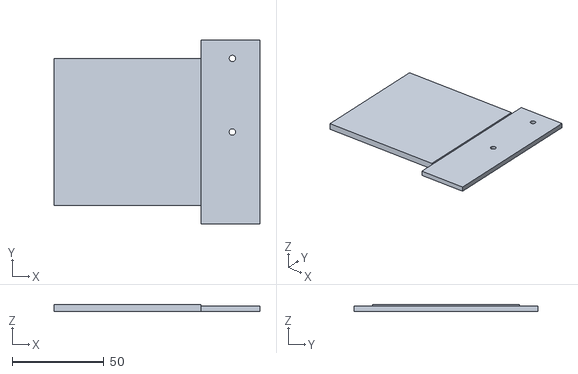
[picture p45: CAD file, 2026-08-13]
svea_charging_parts/aruco_marker_holder/arucoMarker.stl
112.0 x 100.0 x 4.00
