KTH-SML/svea_parts/svea_charging_parts/camera_holder/cameraStand.stl

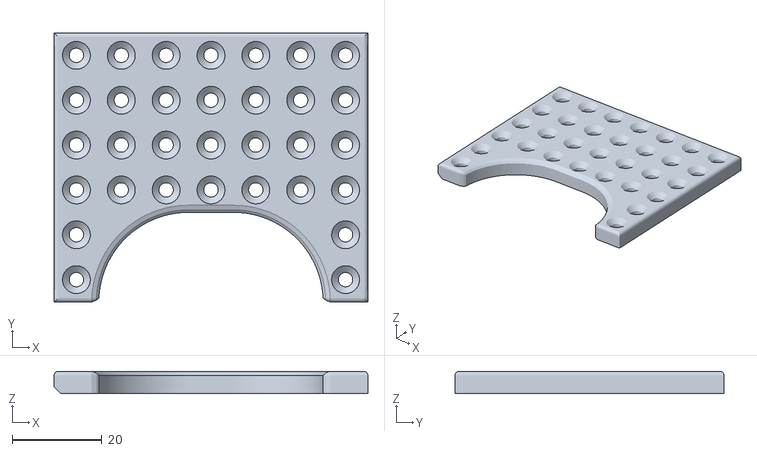
[picture p46: CAD file, 2026-08-13]
svea_charging_parts/camera_holder/cameraStand.stl
70.0 x 60.0 x 5.00
