KTH-SML/svea_parts/svea_charging_parts/charging_arm/cover_real.stl

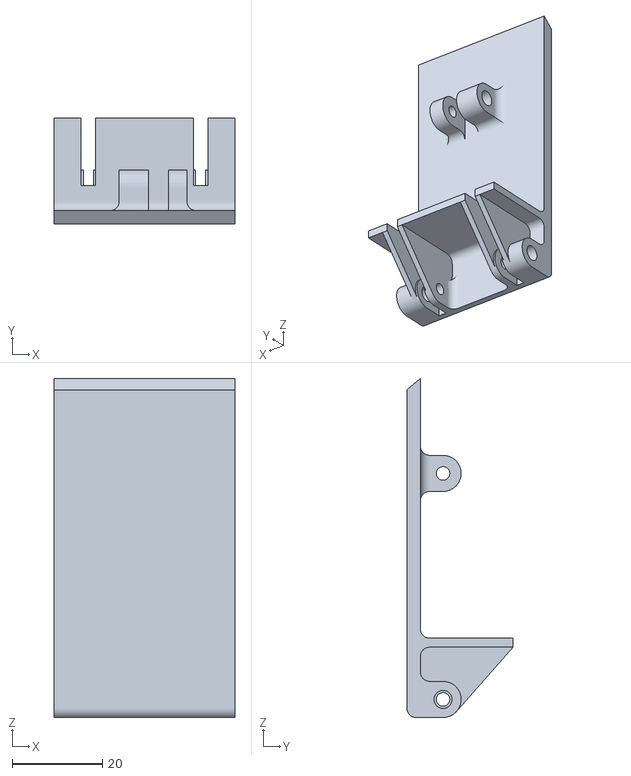
[picture p47: CAD file, 2026-08-16]
svea_charging_parts/charging_arm/cover_real.stl
40.0 x 23.5 x 75.0
