KTH-SML/svea_parts/svea_charging_parts/charging_box/cableholder.stl

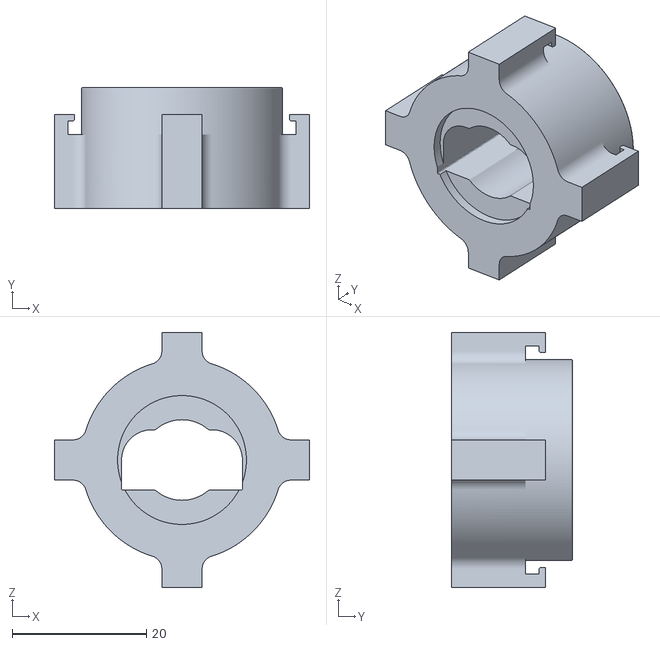
[picture p48: CAD file, 2026-08-13]
svea_charging_parts/charging_box/cableholder.stl
38.0 x 18.0 x 38.0
