KTH-SML/svea_parts/svea_charging_parts/supports_platform/ramp_stand_triangle_Long.stl

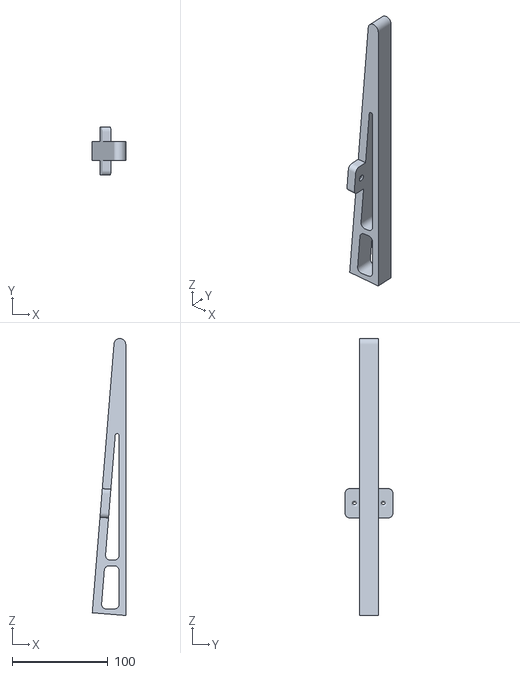
[picture p49: CAD file, 2026-08-13]
svea_charging_parts/supports_platform/ramp_stand_triangle_Long.stl
35.0 x 50.0 x 289.0
