KTH-SML/svea_parts/stl/accessories/camera_holder/svea_plate_5x5.stl

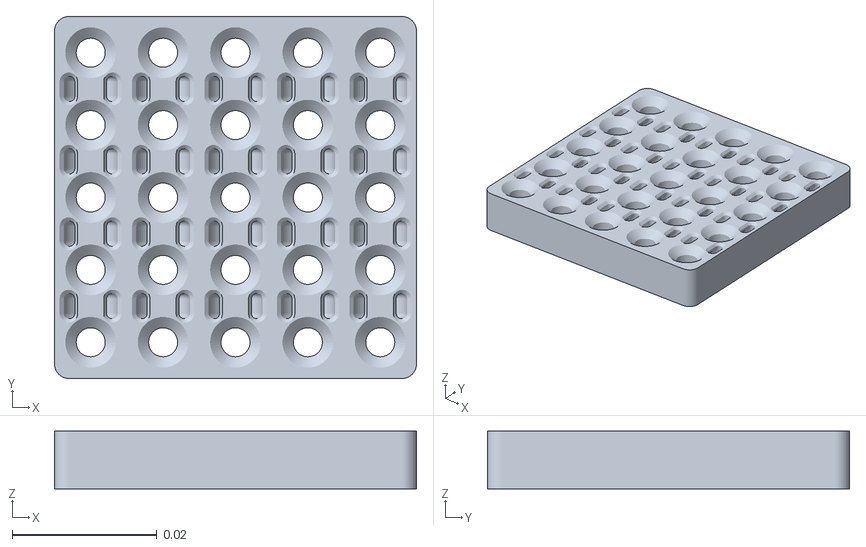
[picture p50: CAD file, 2026-08-24]
stl/accessories/camera_holder/svea_plate_5x5.stl
0.05 x 0.05 x 0.008
