KTH-SML/svea_parts/stl/accessories/tail/svea_back_mech.stl

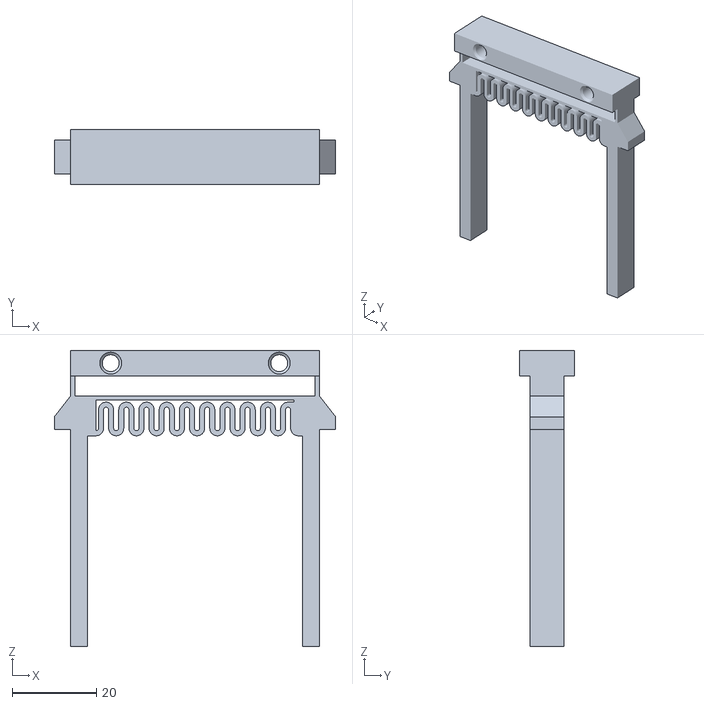
[picture p51: CAD file, 2026-08-24]
stl/accessories/tail/svea_back_mech.stl
66.8 x 13.0 x 70.2
