KTH-SML/svea_parts/stl/battery_holder/8000/svea_battery_back_8000.stl

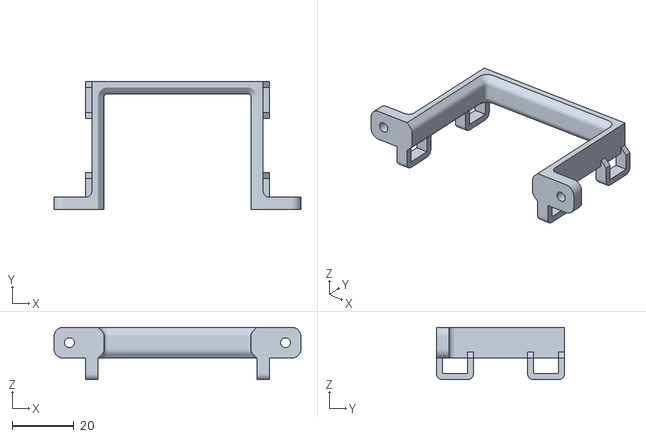
[picture p52: CAD file, 2026-08-24]
stl/battery_holder/8000/svea_battery_back_8000.stl
80.0 x 41.5 x 17.0
