KTH-SML/svea_parts/stl/battery_holder/9000/svea_battery_back_9000.stl

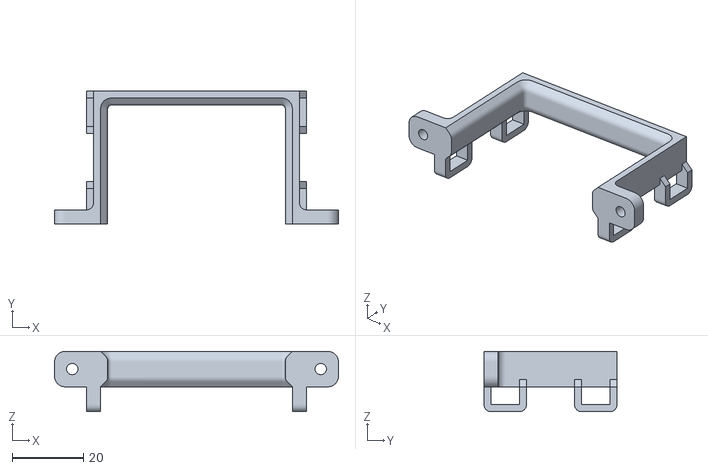
[picture p53: CAD file, 2026-08-24]
stl/battery_holder/9000/svea_battery_back_9000.stl
80.0 x 37.5 x 17.0
