KTH-SML/svea_parts/stl/encoder/duel_encoders/svea_duel_encoders_mount.stl

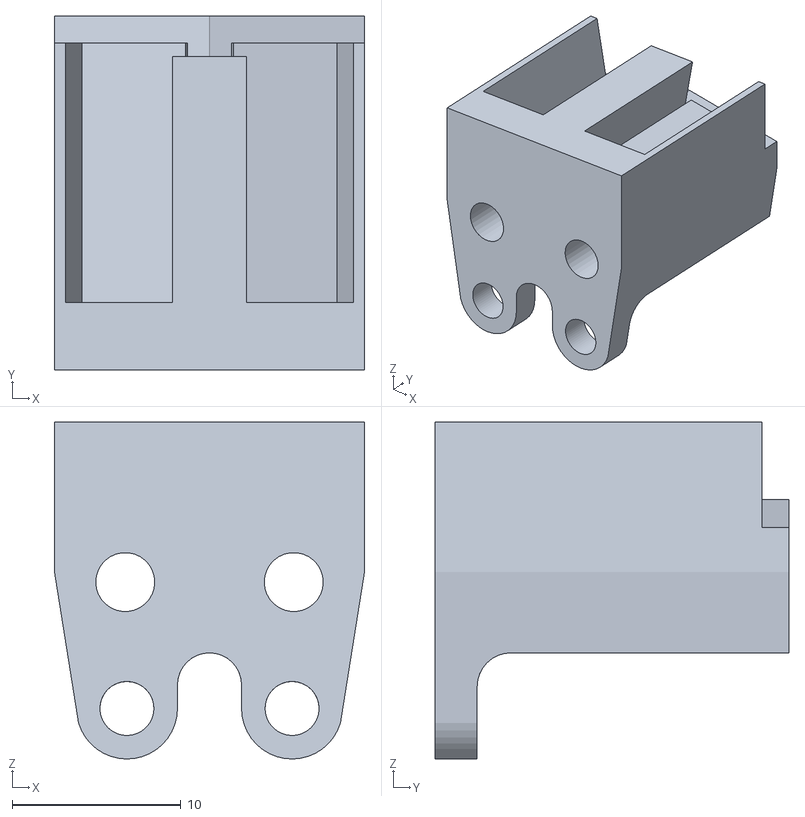
[picture p54: CAD file, 2026-08-24]
stl/encoder/duel_encoders/svea_duel_encoders_mount.stl
18.4 x 21.0 x 20.0
