KTH-SML/svea_parts/stl/encoder/single_encoder/svea_wheel_encoder_40_for_single_encoder.stl

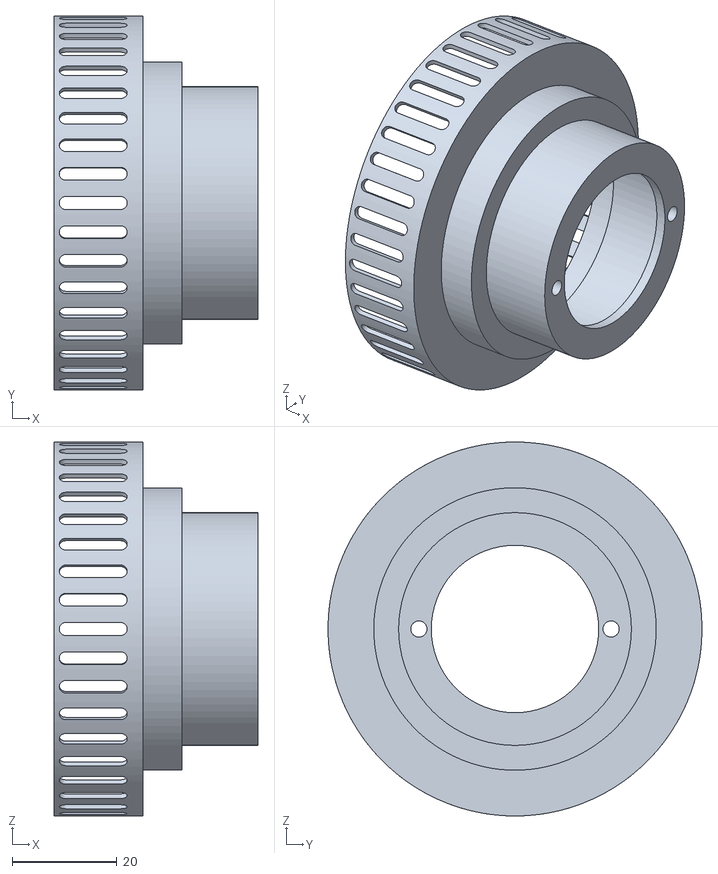
[picture p55: CAD file, 2026-05-22]
stl/encoder/single_encoder/svea_wheel_encoder_40_for_single_encoder.stl
39.0 x 71.5 x 71.5
