KTH-SML/svea_parts/stl/encoder/svea_esp32_mount.stl

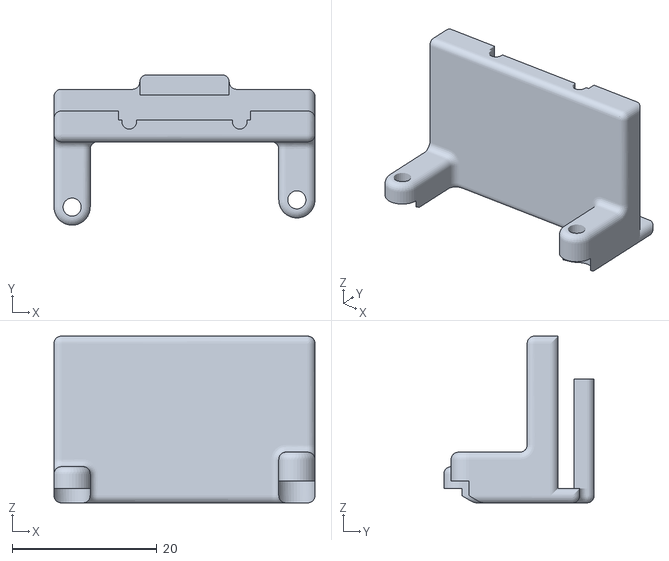
[picture p56: CAD file, 2026-08-24]
stl/encoder/svea_esp32_mount.stl
36.0 x 20.8 x 23.0
