KTH-SML/svea_parts/stl/svea_dc_plug_use_TPU.stl

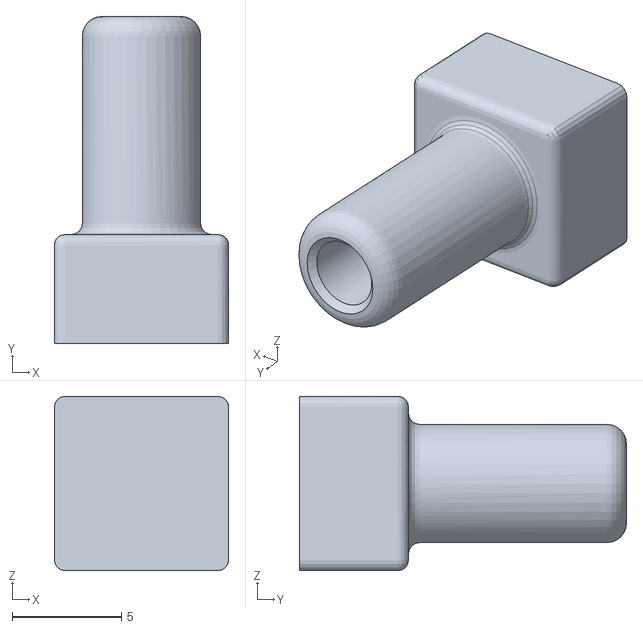
[picture p57: CAD file, 2026-08-24]
stl/svea_dc_plug_use_TPU.stl
8.00 x 15.0 x 8.00
