KTH-SML/svea_parts/svea_charging_parts/2d_LaserCutter/LaserCutterdxf/platform.dxf

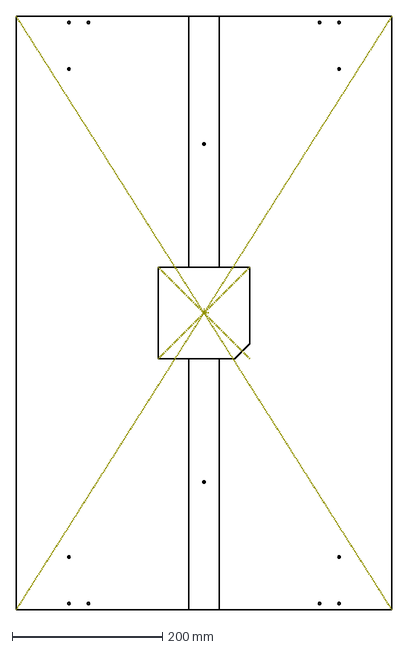
[picture p58: CAD file, 2026-08-13]
svea_charging_parts/2d_LaserCutter/LaserCutterdxf/platform.dxf
500.0 x 790.0 mm
