KTH-SML/svea_parts/svea_charging_parts/aruco_marker_holder/arucoHolder.stl

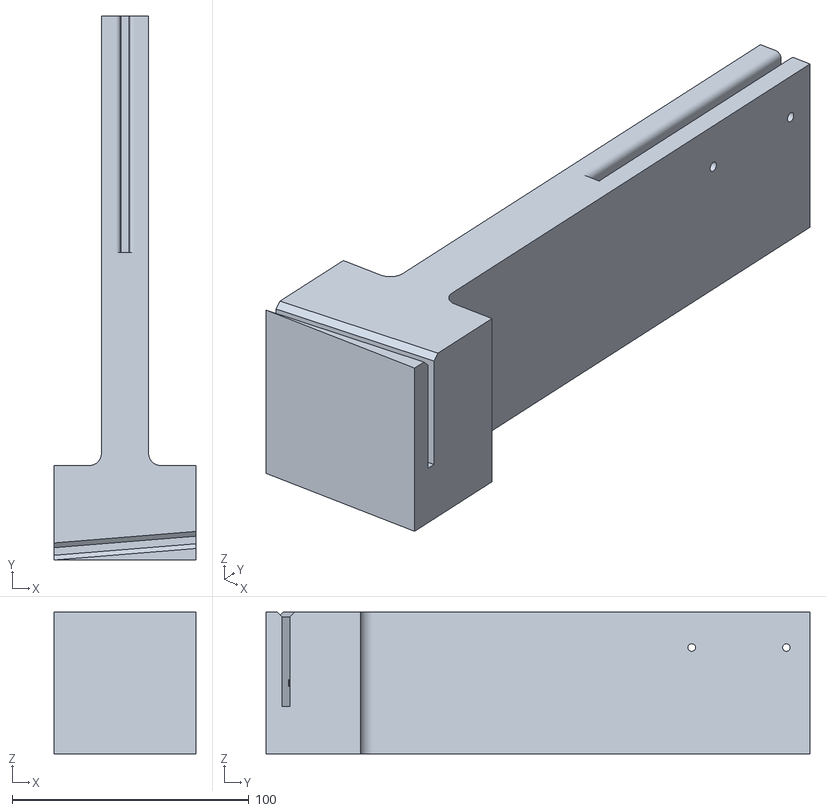
[picture p59: CAD file, 2026-08-13]
svea_charging_parts/aruco_marker_holder/arucoHolder.stl
60.0 x 230.0 x 60.0
