KTH-SML/svea_parts/svea_charging_parts/camera_holder/cameraMount_tilt.stl

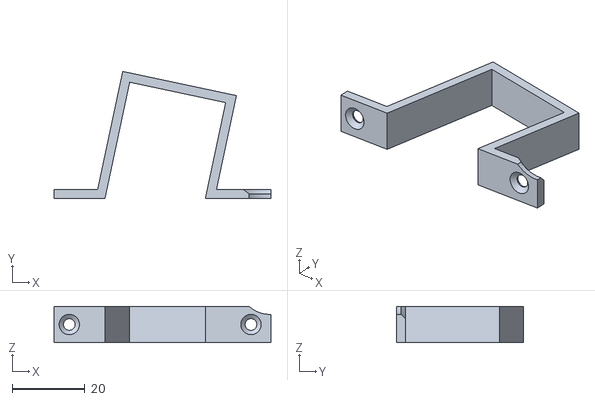
[picture p60: CAD file, 2026-08-13]
svea_charging_parts/camera_holder/cameraMount_tilt.stl
59.7 x 35.0 x 10.0
