KTH-SML/svea_parts/svea_charging_parts/charging_arm/cable_arm.stl

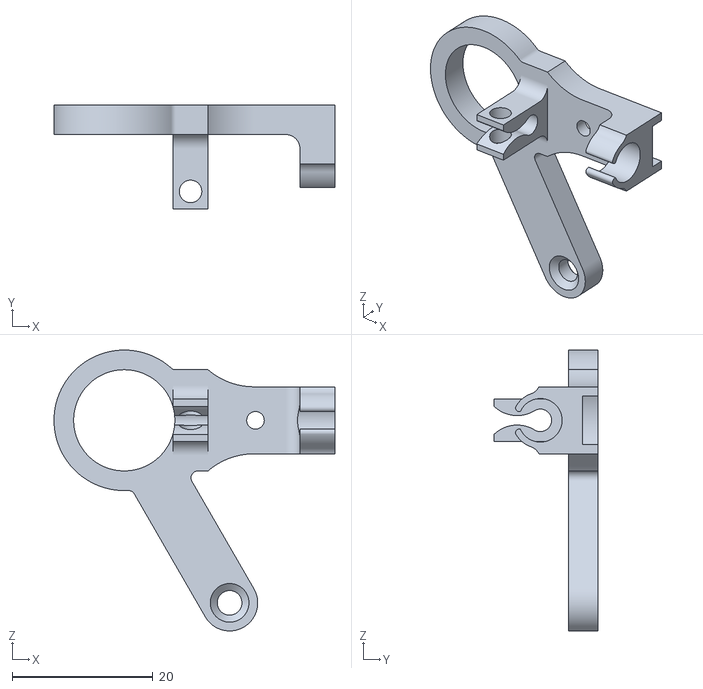
[picture p61: CAD file, 2026-08-16]
svea_charging_parts/charging_arm/cable_arm.stl
40.0 x 14.8 x 40.0
