KTH-SML/svea_parts/svea_charging_parts/charging_box/top.stl

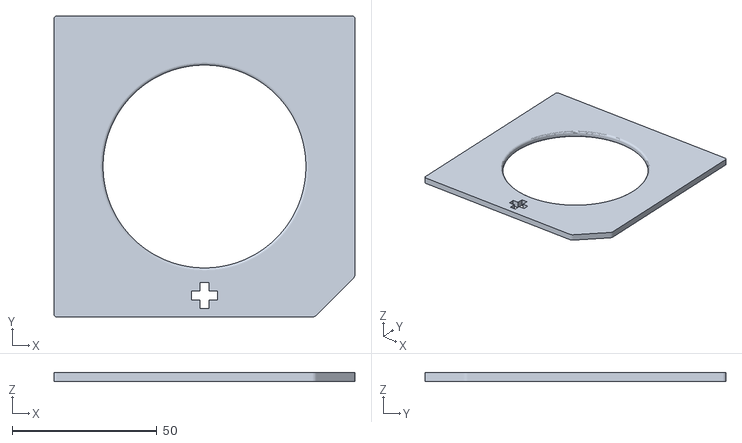
[picture p62: CAD file, 2026-08-13]
svea_charging_parts/charging_box/top.stl
103.9 x 103.9 x 3.00
