KTH-SML/svea_parts/svea_charging_parts/supports_platform/staticHinge.stl

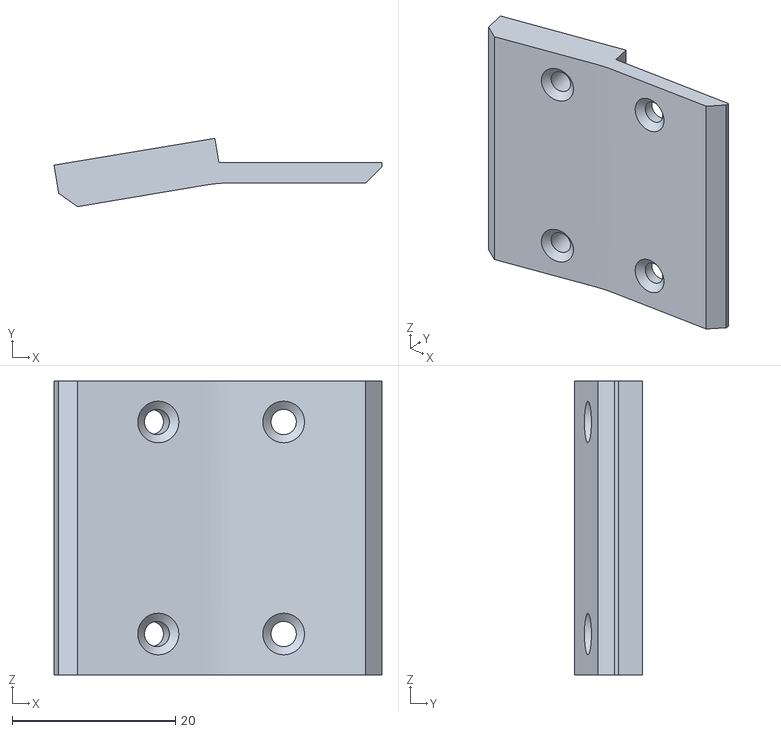
[picture p63: CAD file, 2026-08-13]
svea_charging_parts/supports_platform/staticHinge.stl
40.2 x 8.38 x 36.0
