KTH-SML/svea_parts/stl/battery_holder/8000/svea_battery_holder_8000.stl

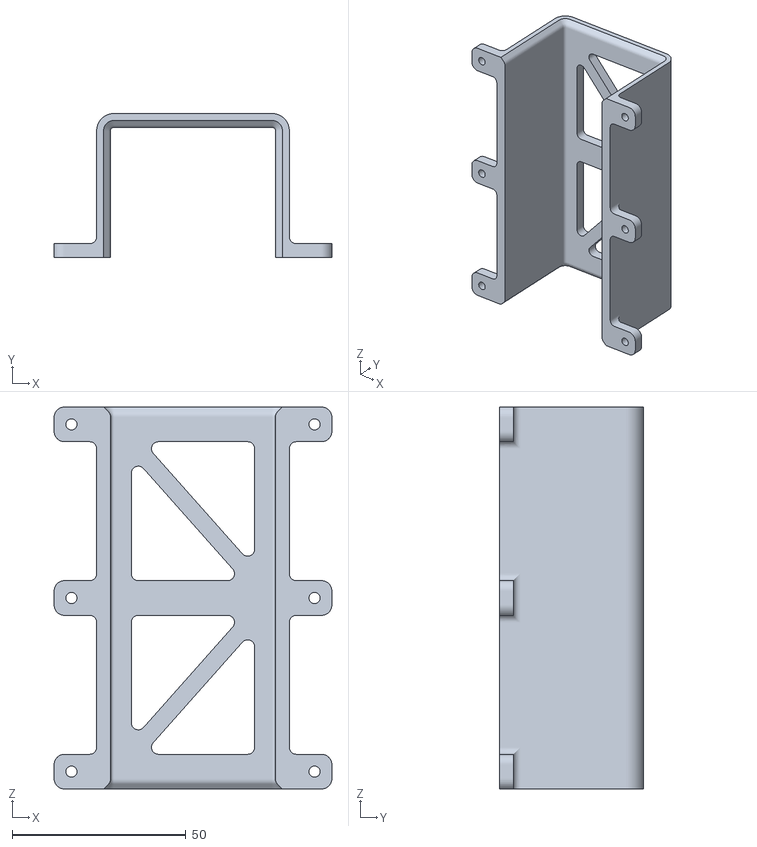
[picture p64: CAD file, 2026-08-24]
stl/battery_holder/8000/svea_battery_holder_8000.stl
80.0 x 41.5 x 110.0
