KTH-SML/svea_parts/stl/battery_holder/9000/svea_battery_holder_9000.stl

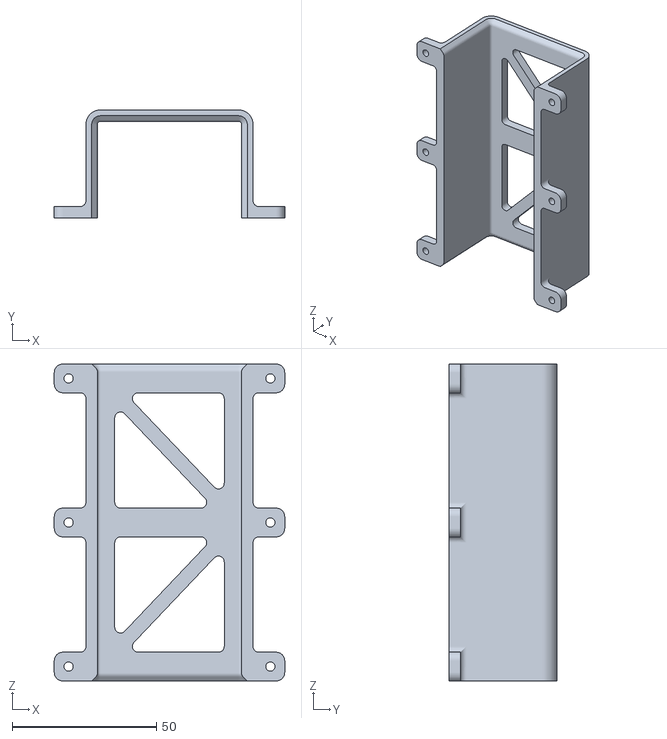
[picture p65: CAD file, 2026-08-24]
stl/battery_holder/9000/svea_battery_holder_9000.stl
80.0 x 37.5 x 110.0
