KTH-SML/svea_parts/stl/encoder/duel_encoders/svea_duel_encoders_plate.stl

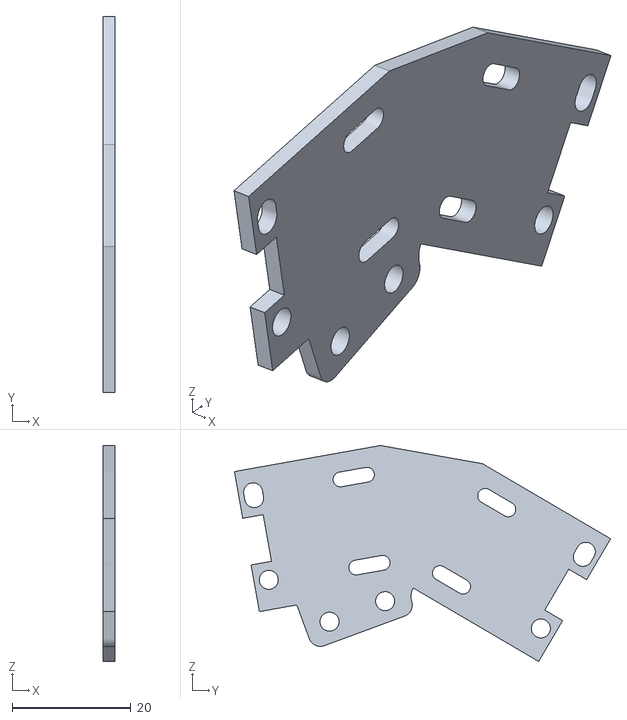
[picture p66: CAD file, 2026-08-24]
stl/encoder/duel_encoders/svea_duel_encoders_plate.stl
2.00 x 63.5 x 36.4
