KTH-SML/svea_parts/stl/svea_pmb_cover.stl

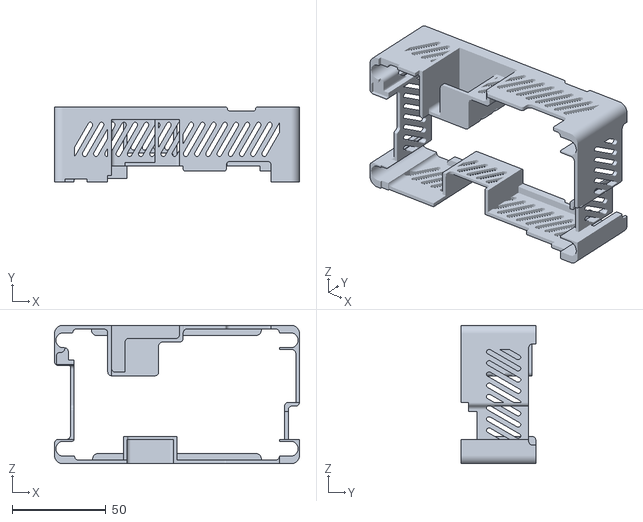
[picture p67: CAD file, 2026-05-22]
stl/svea_pmb_cover.stl
131.0 x 40.0 x 74.0
