KTH-SML/svea_parts/svea_charging_parts/2d_LaserCutter/LaserCutterdxf/platformRamp.dxf

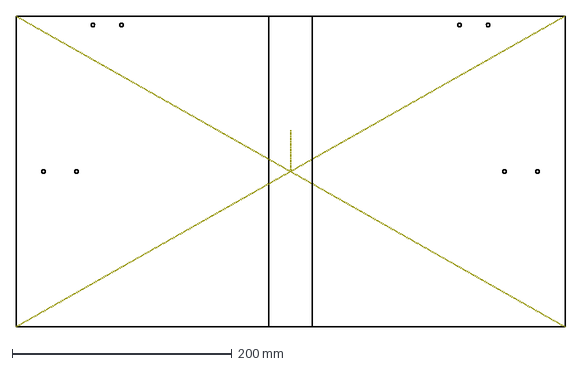
[picture p68: CAD file, 2026-08-13]
svea_charging_parts/2d_LaserCutter/LaserCutterdxf/platformRamp.dxf
500.0 x 283.0 mm
