KTH-SML/svea_parts/svea_charging_parts/camera_holder/cameraSupportRamp.stl

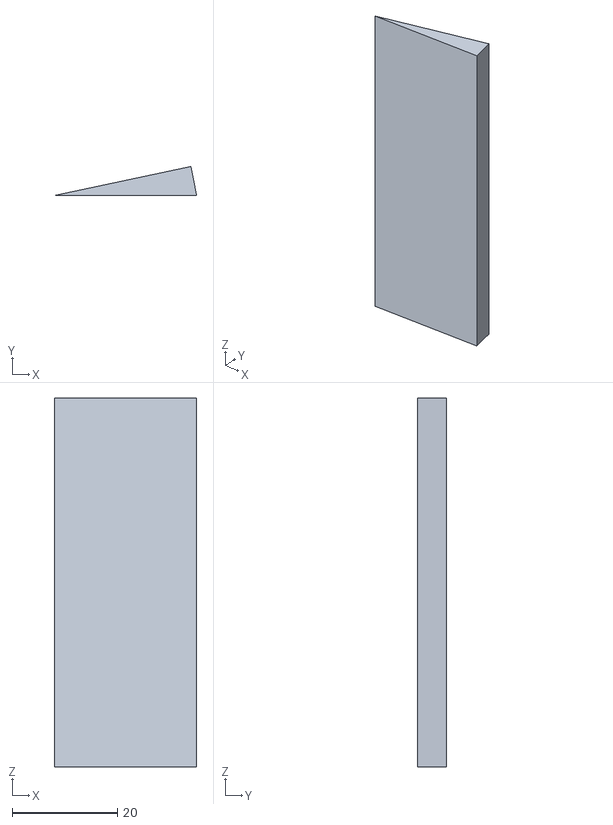
[picture p69: CAD file, 2026-08-13]
svea_charging_parts/camera_holder/cameraSupportRamp.stl
27.0 x 5.51 x 70.0
