KTH-SML/svea_parts/svea_charging_parts/charging_arm/cable_arm_4mm_short.stl

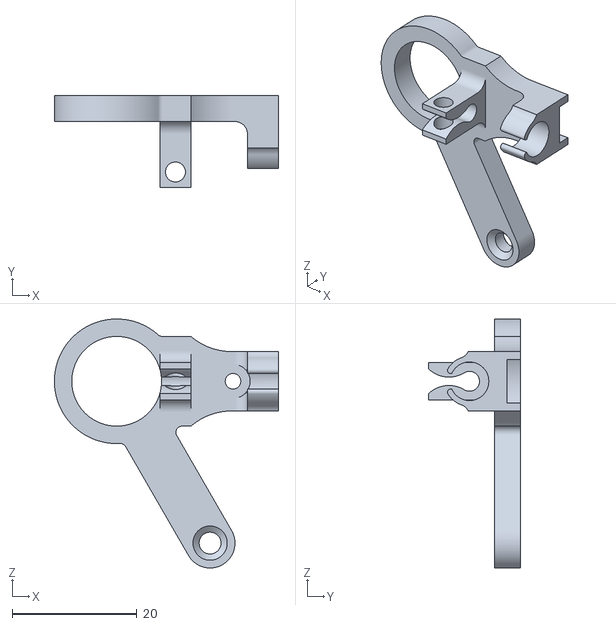
[picture p70: CAD file, 2026-08-16]
svea_charging_parts/charging_arm/cable_arm_4mm_short.stl
36.0 x 14.8 x 40.0
