KTH-SML/svea_parts/svea_charging_parts/charging_box/cylinderStick.stl

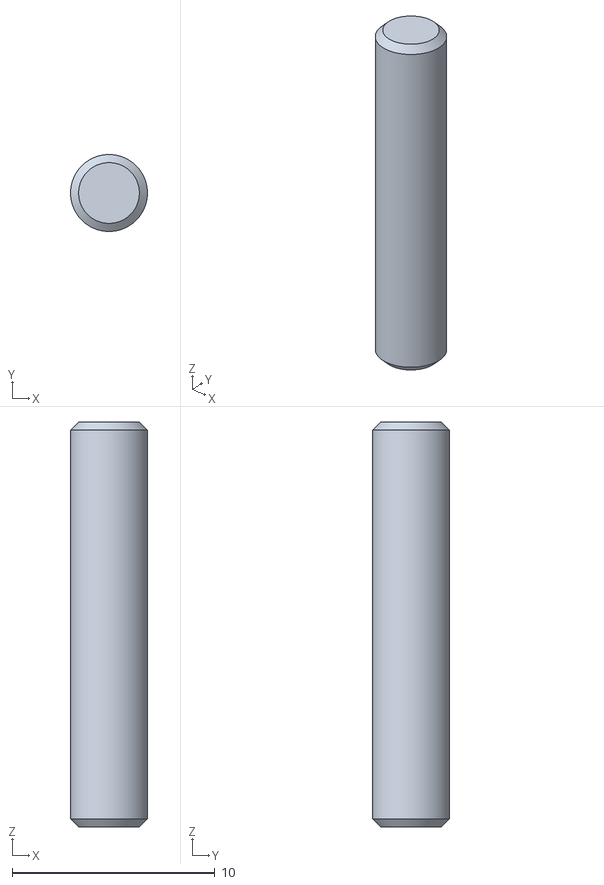
[picture p71: CAD file, 2026-08-13]
svea_charging_parts/charging_box/cylinderStick.stl
3.80 x 3.80 x 20.0
