KTH-SML/svea_parts/svea_charging_parts/supports_platform/ramp_stand_triangle.stl

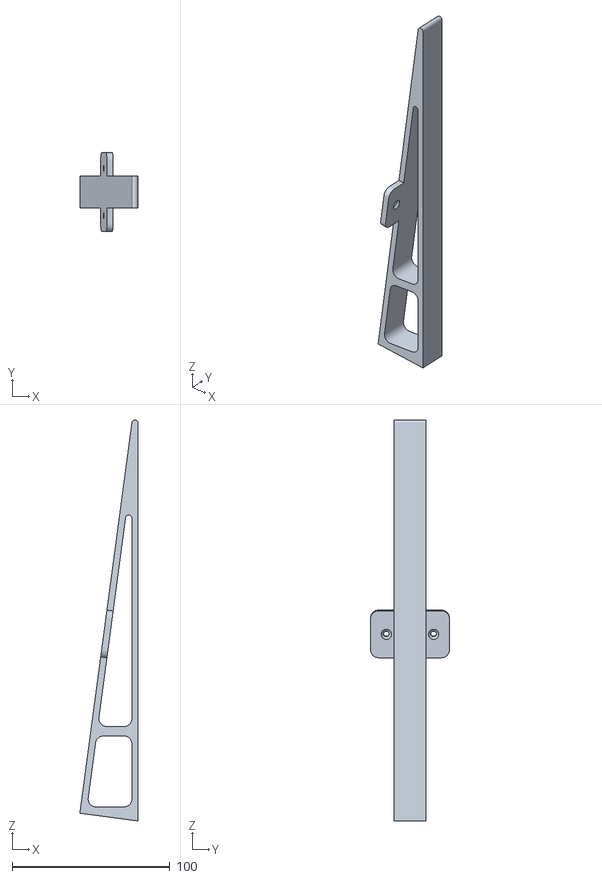
[picture p72: CAD file, 2026-08-13]
svea_charging_parts/supports_platform/ramp_stand_triangle.stl
37.0 x 50.0 x 254.3
