KTH-SML/svea_parts/stp/svea_camera_mount.stp

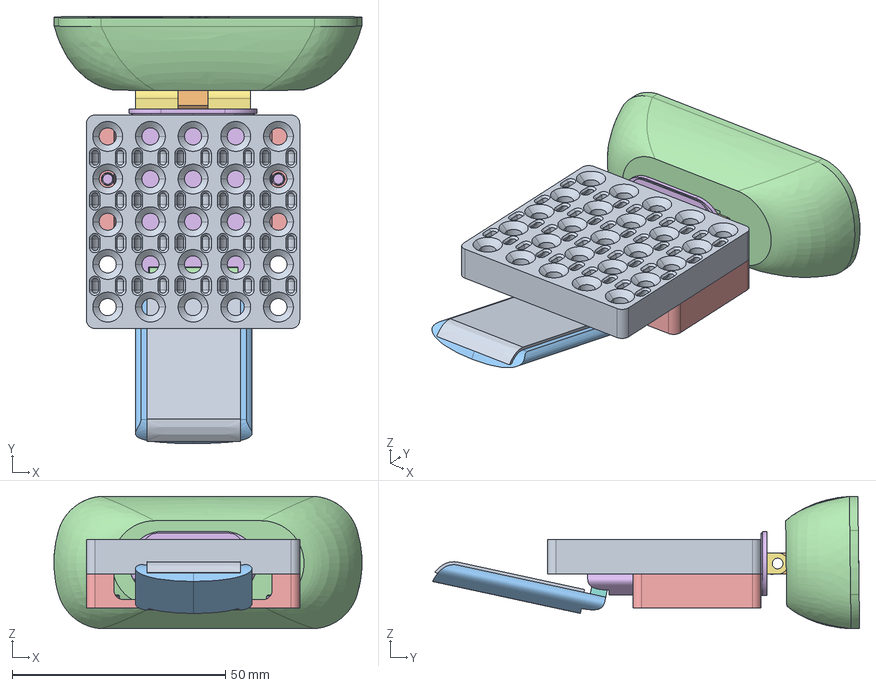
[picture p73: CAD file, 2026-08-24]
stp/svea_camera_mount.stp
72.2 x 100.1 x 31.0 mm
PLATE_5X5
CUT-EXTRUDE3_2_
BOSS-EXTRUDE10-2769
CUT-EXTRUDE3_1_
BOSS-EXTRUDE5-3625
MIRROR2
BOSS-EXTRUDE8
BOSS-EXTRUDE5-4065
CUT-EXTRUDE9_2_
CUT-EXTRUDE8
BOSS-EXTRUDE12
BOSS-EXTRUDE10-4839
CUT-EXTRUDE9_1_
CAMERA_HOLDER
M3_10MM x 2
