KTH-SML/svea_parts/svea_charging_parts/charging_arm/box_cover.stl

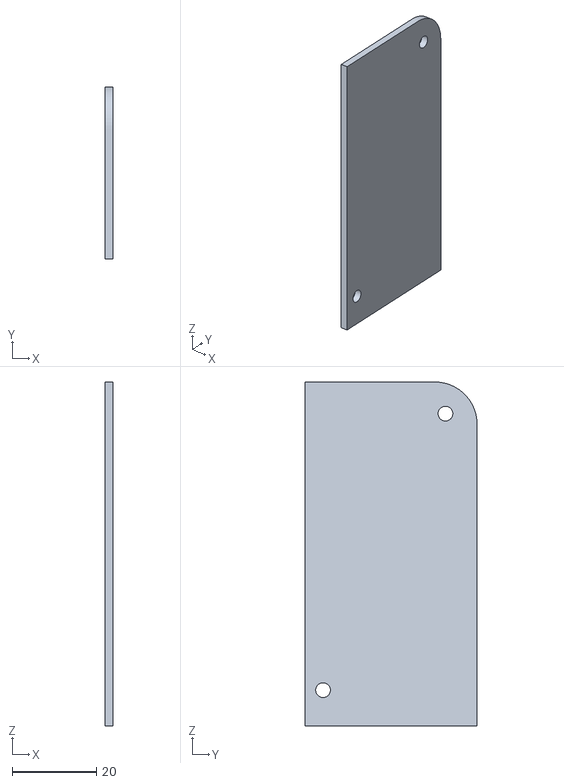
[picture p74: CAD file, 2026-08-16]
svea_charging_parts/charging_arm/box_cover.stl
2.00 x 40.8 x 81.5
