KTH-SML/svea_parts/svea_charging_parts/charging_box/chargerBox.stl

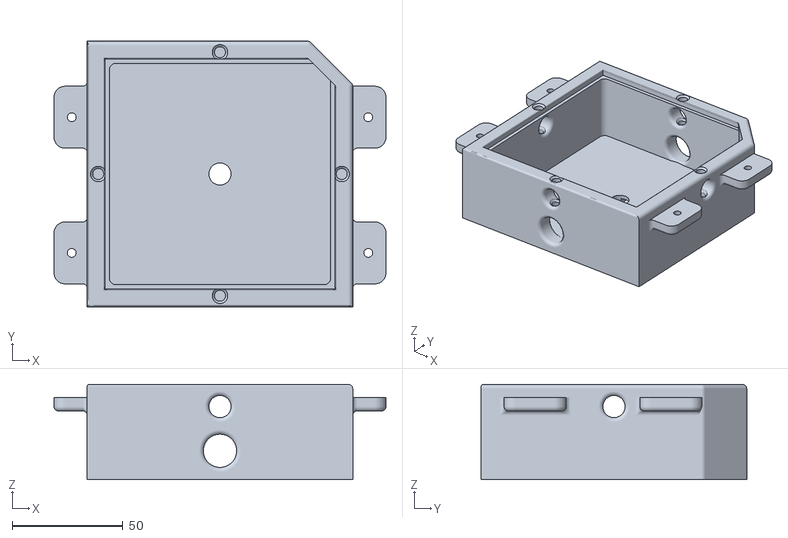
[picture p75: CAD file, 2026-08-13]
svea_charging_parts/charging_box/chargerBox.stl
150.0 x 120.0 x 43.0
