KTH-SML/svea_parts/svea_charging_parts/supports_platform/supportChargerPlatform.stl

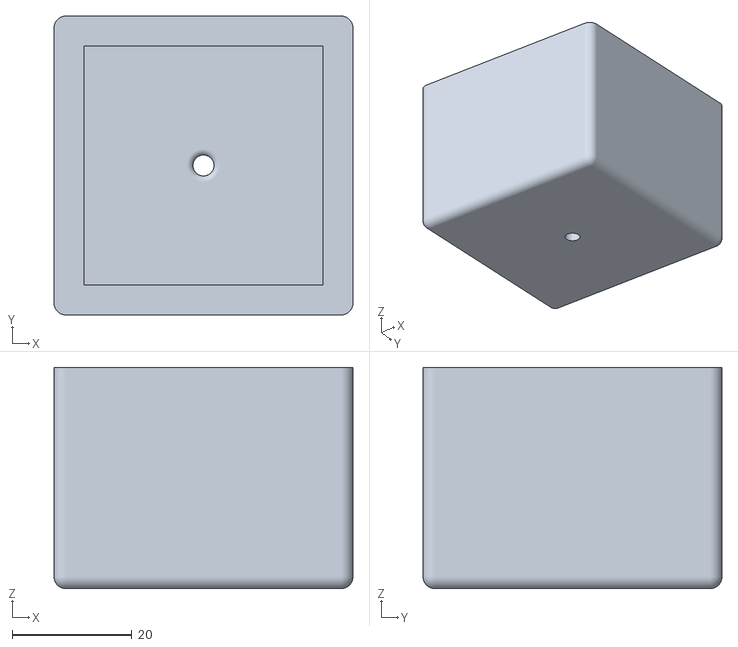
[picture p76: CAD file, 2026-08-13]
svea_charging_parts/supports_platform/supportChargerPlatform.stl
50.0 x 50.0 x 37.0
