KTH-SML/svea_parts/stl/svea_receiver_holder.stl

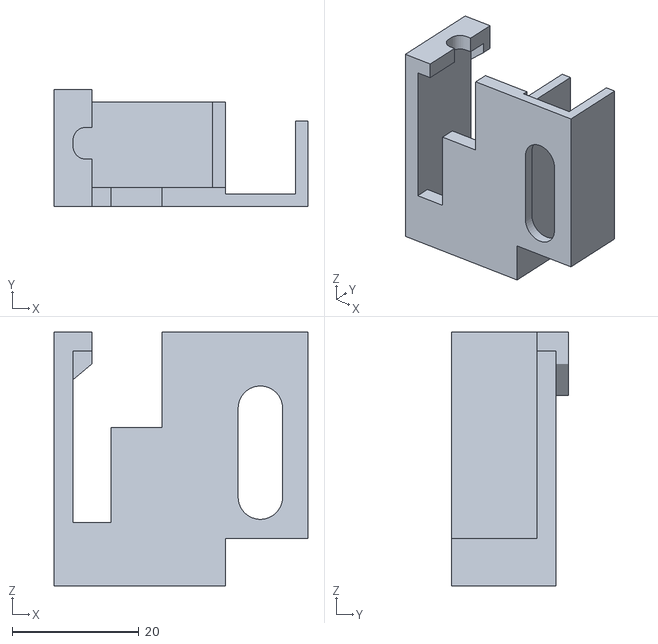
[picture p77: CAD file, 2026-05-22]
stl/svea_receiver_holder.stl
40.0 x 18.5 x 40.0
