KTH-SML/svea_parts/svea_charging_parts/charging_arm/box.stl

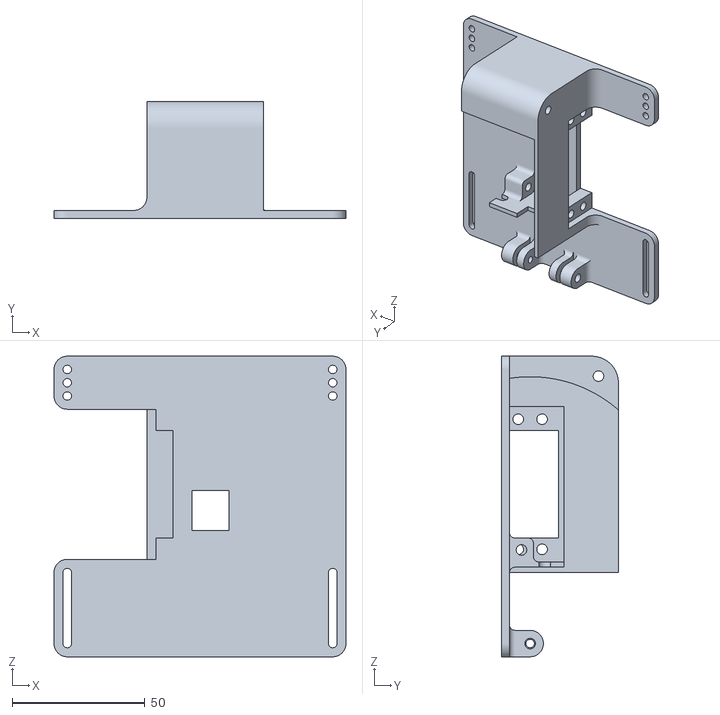
[picture p78: CAD file, 2026-08-16]
svea_charging_parts/charging_arm/box.stl
110.0 x 44.0 x 113.2
