KTH-SML/svea_parts/stl/svea_battery_holder_8000.stl

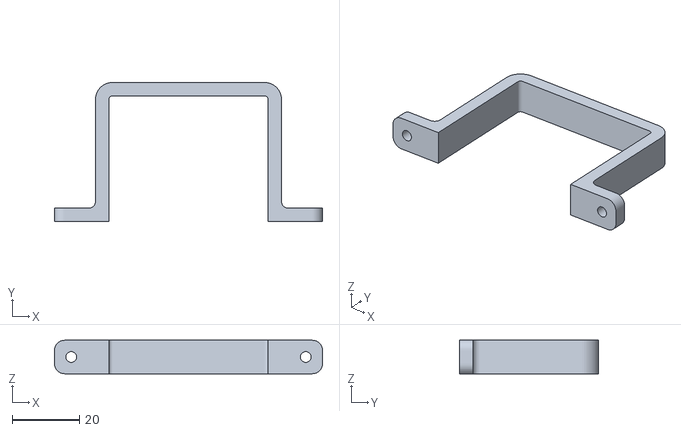
[picture p79: CAD file, 2026-05-22]
stl/svea_battery_holder_8000.stl
80.0 x 41.5 x 10.0
