KTH-SML/svea_parts/svea_charging_parts/charging_arm/arm_support.stl

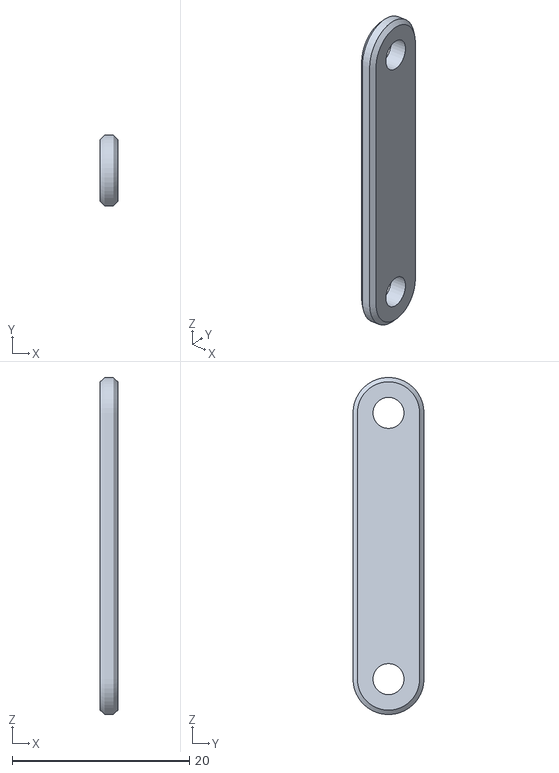
[picture p81: CAD file, 2026-08-16]
svea_charging_parts/charging_arm/arm_support.stl
2.00 x 8.00 x 38.0
