KTH-SML/svea_parts/stp/svea_battery_stopper.stp

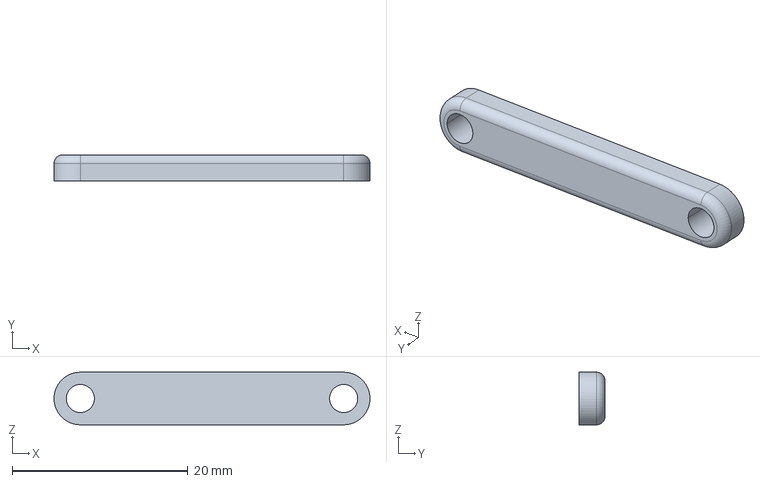
[picture p83: CAD file, 2026-05-22]
stp/svea_battery_stopper.stp
36.0 x 3.00 x 6.00 mm
