KTH-SML/svea_parts/stl/svea_lidar_mount_assist.stl

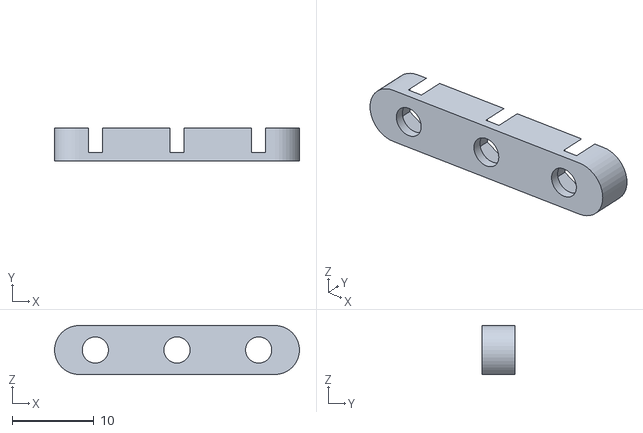
[picture p84: CAD file, 2026-05-22]
stl/svea_lidar_mount_assist.stl
30.0 x 4.00 x 6.00
