KTH-SML/svea_parts/stp/svea_battery_holder_9000.stp

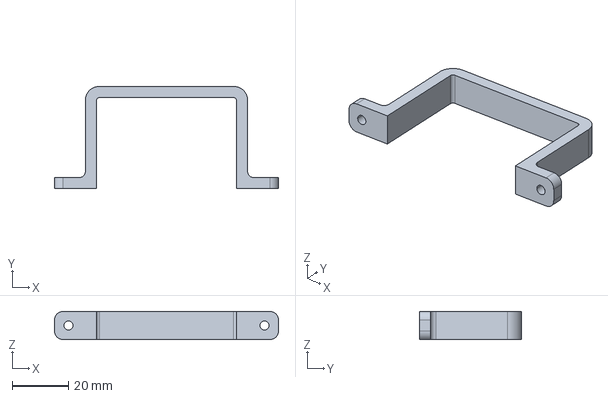
[picture p85: CAD file, 2026-05-22]
stp/svea_battery_holder_9000.stp
80.0 x 36.5 x 10.0 mm
