KTH-SML/svea_parts/stl/svea_encoder_mount.stl

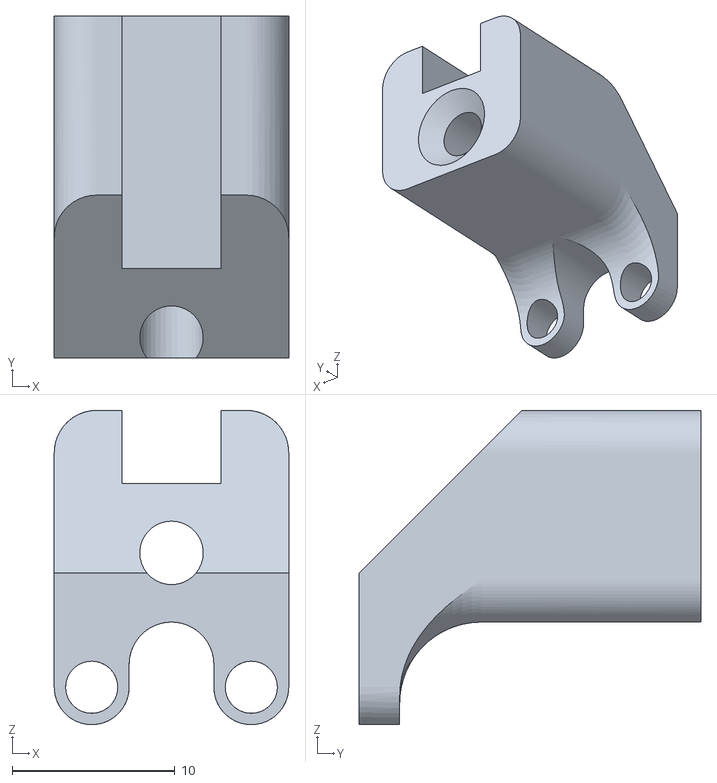
[picture p86: CAD file, 2026-05-22]
stl/svea_encoder_mount.stl
14.4 x 21.0 x 19.3
