KTH-SML/svea_parts/stp/svea_half_plate.stp

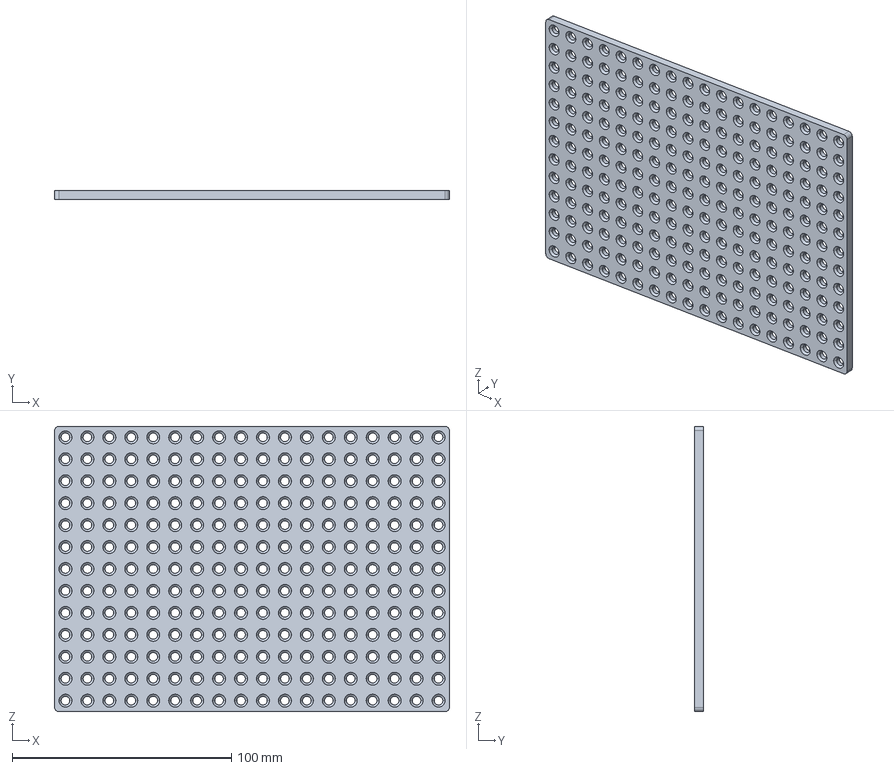
[picture p87: CAD file, 2026-05-22]
stp/svea_half_plate.stp
180.0 x 4.00 x 130.0 mm
