KTH-SML/svea_parts/stp/svea_plate_mount.stp

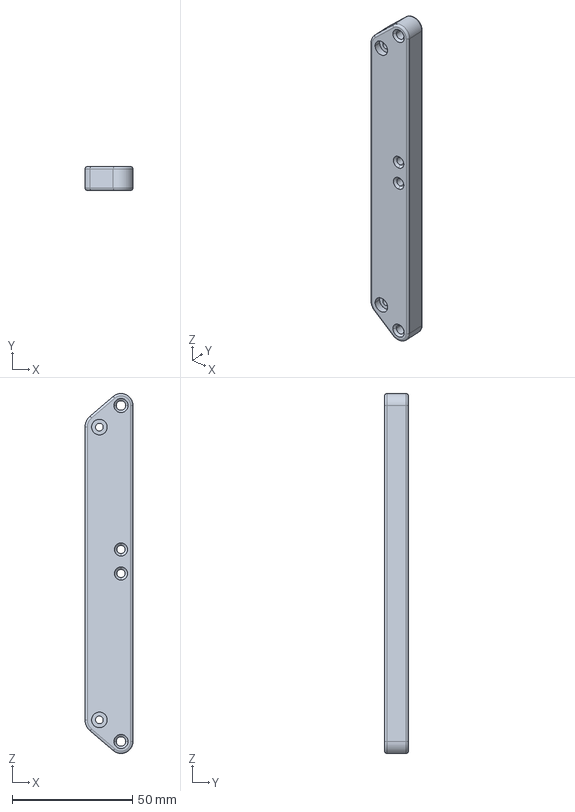
[picture p88: CAD file, 2026-05-22]
stp/svea_plate_mount.stp
20.0 x 10.0 x 150.0 mm
