KTH-SML/svea_parts/(list of files, cad)

Other CAD files:
stp/svea_powerboard_asm.stp
stl/svea_lidar_hat.stl
stl/svea_plate_half.stl
stl/svea_battery_holder_9000.stl
stl/svea_battery_stopper.stl
stl/svea_plate_mount.stl
svea2.0/MPU Mount (BNO55) v2.f3d
svea2.0/MPU Mount (SEEED ICM) v7.f3d
svea2.0/Shell Mount v28.f3d
svea2.0/_Annikas IMU (probably not interference but whatev.c6cc2b10-ba41-4698-b681-40151d34f9de.f3d
svea2.0/_Bottom Attatchment.85361469-475e-472e-92d3-0b1b0a94a3bd.f3d
svea2.0/_GPS holder.9b4c6a14-adf5-428e-8618-3bced4a97906.f3d
svea2.0/_Lidar v4.199e480f-8d48-4335-8f53-5563380a8b35.f3d
svea2.0/_Lipo holder.3821010a-fb68-4cc0-a960-7c9f3cf3485e.f3d
svea2.0/_NimH Holder.aa154edd-a2b0-4f88-9452-3d36a1c07c29.f3d
svea2.0/_Platform Link Arm.c20c3072-6dc2-4d8d-a4cd-072d7f1dbc6d.f3d
svea2.0/_Shell Mount.6282c432-1834-4d19-9b96-cbeaaebe9f8f.f3d
svea2.0/_TheFlag.7fe9db87-e2a5-4b7a-a887-d6b63744287c.f3d
svea2.0/_V2 RealSense Mount.c3c66d58-4b16-4023-b535-7b466959c17c.f3d
svea_charging_parts/2d_LaserCutter/OldVersions/platform - kopia.0011.ipt
svea_charging_parts/2d_LaserCutter/OldVersions/platformRamp - LONG - kopia.0009.ipt
svea_charging_parts/2d_LaserCutter/platform.ipt
svea_charging_parts/2d_LaserCutter/platformRamp.ipt
svea_charging_parts/2d_LaserCutter/platformRampLong.ipt
