KTH-SML/svea_parts/SVEA_manual.pdf

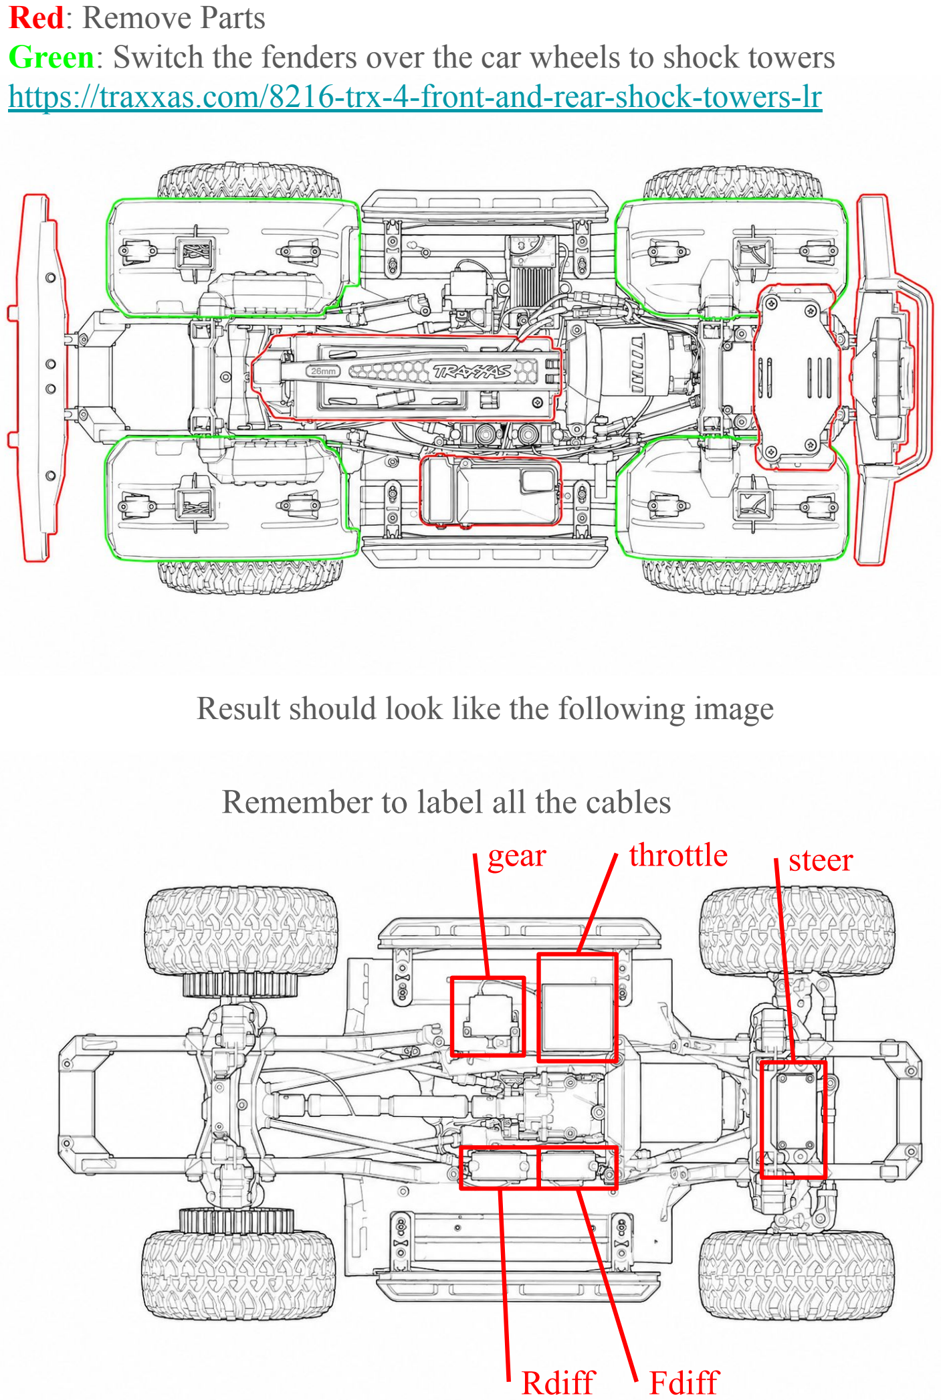
[picture p89: page 1]

Red: Remove Parts
Green: Switch the fenders over the car wheels to shock towers https://traxxas.com/8216-trx-4-front-and-rear-shock-towers-lr

Result should look like the following image

Rdiff | Fdiff
gear | throttle | steer

Remember to label all the cables

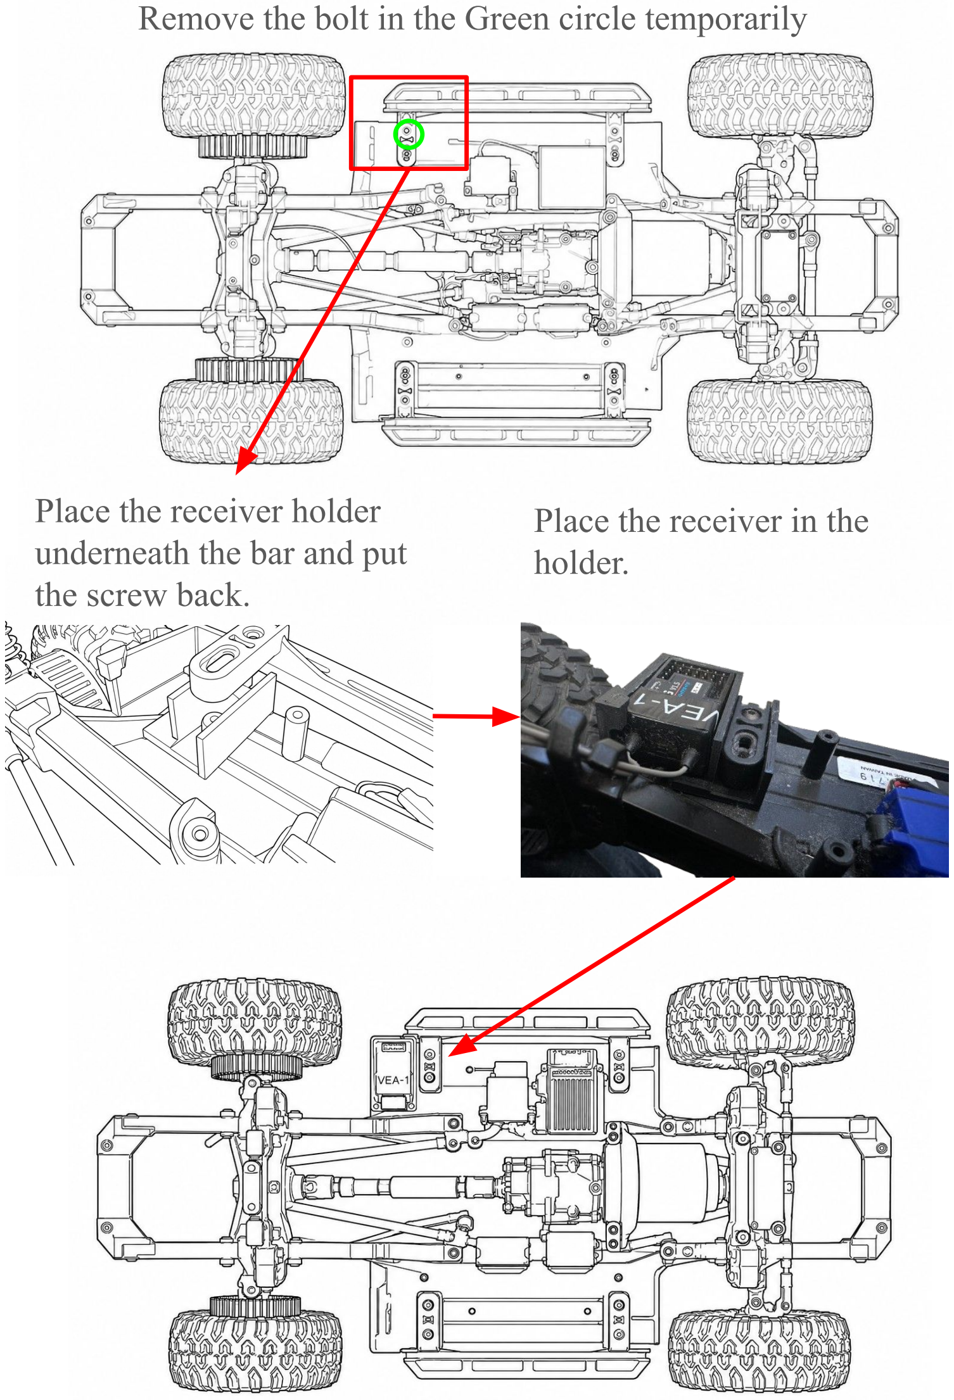
[picture p90: page 2]

Remove the bolt in the Green circle temporarily

Place the receiver holder
underneath the bar and put the screw back.

Place the receiver in the
holder.

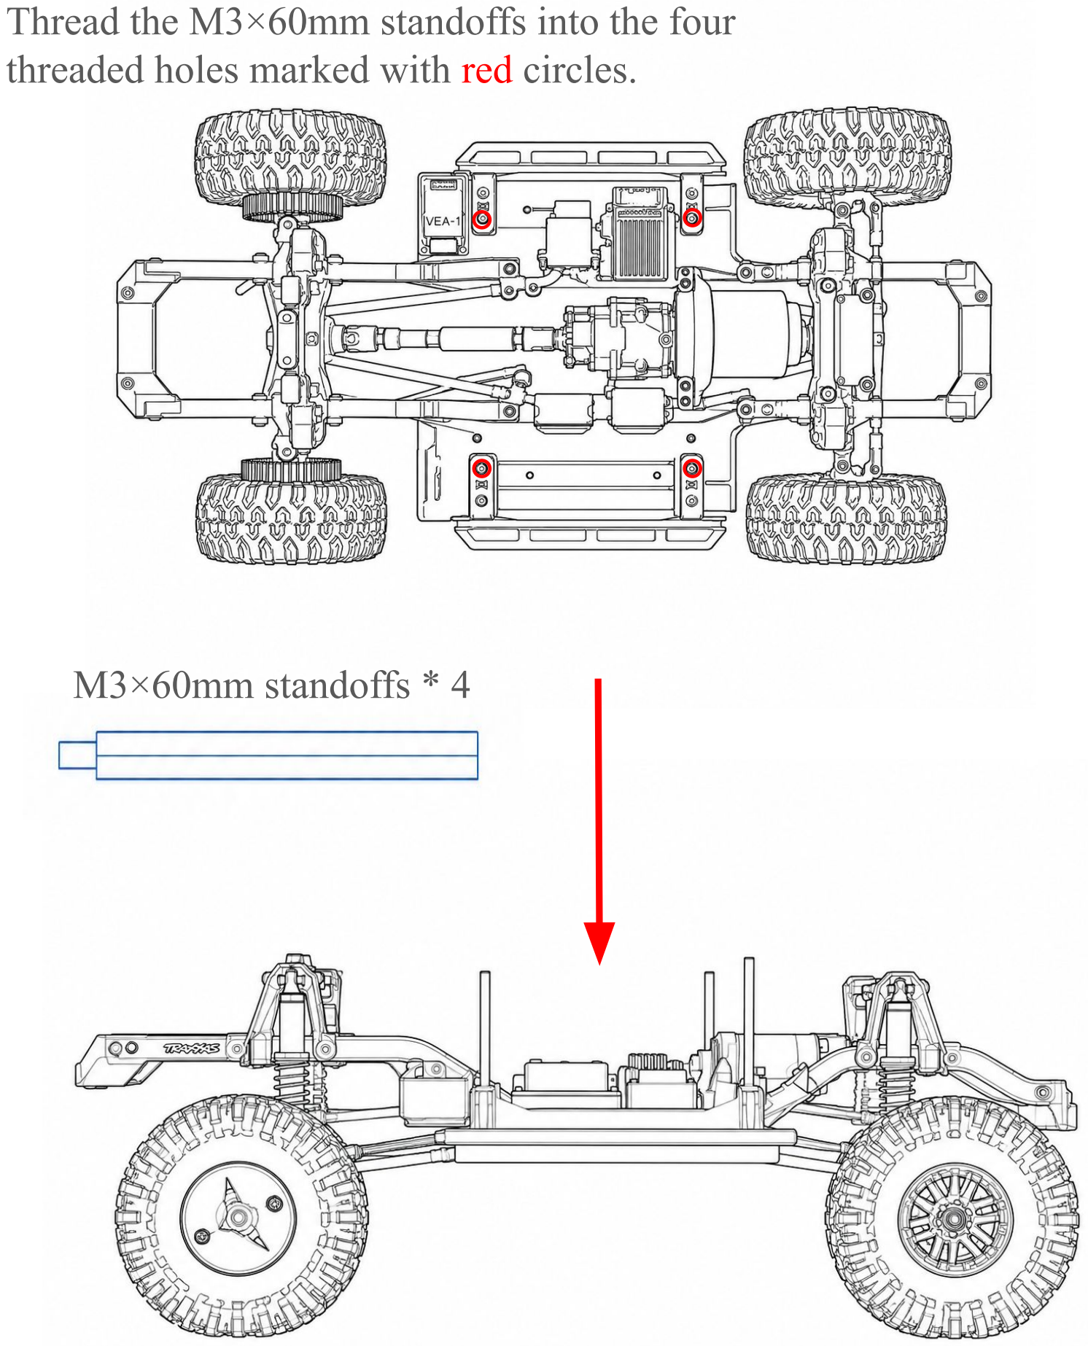
[picture p91: page 3]

Thread the M3×60mm standoffs into the four threaded holes marked with red circles.

M3×60mm standoffs * 4

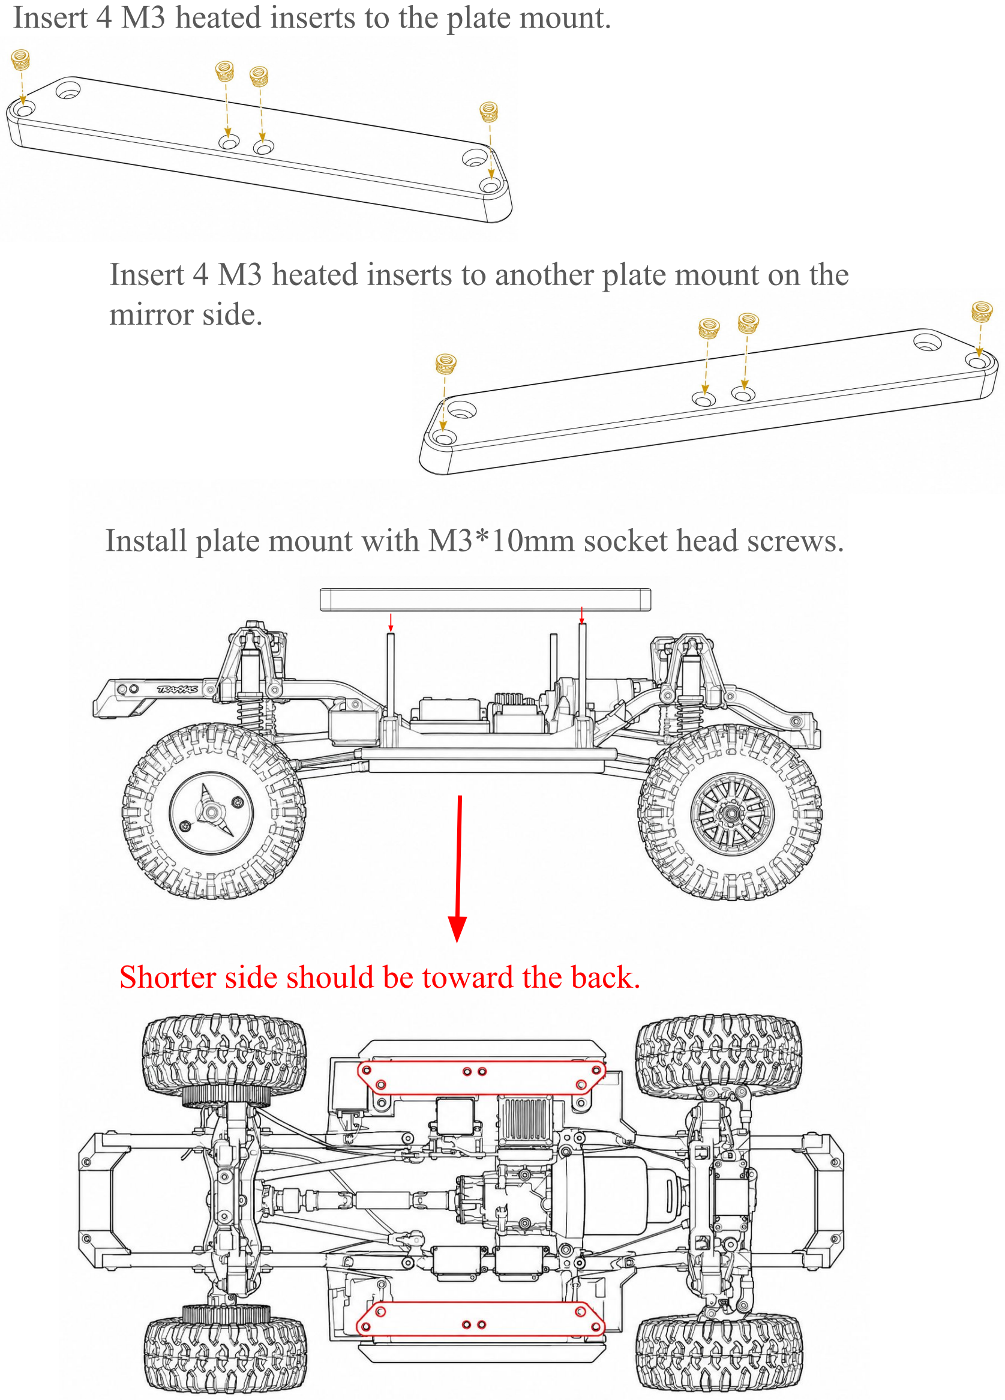
[picture p92: page 4]

Insert 4 M3 heated inserts to the plate mount.

Insert 4 M3 heated inserts to another plate mount on the mirror side.

Install plate mount with M3*10mm socket head screws.

Shorter side should be toward the back.

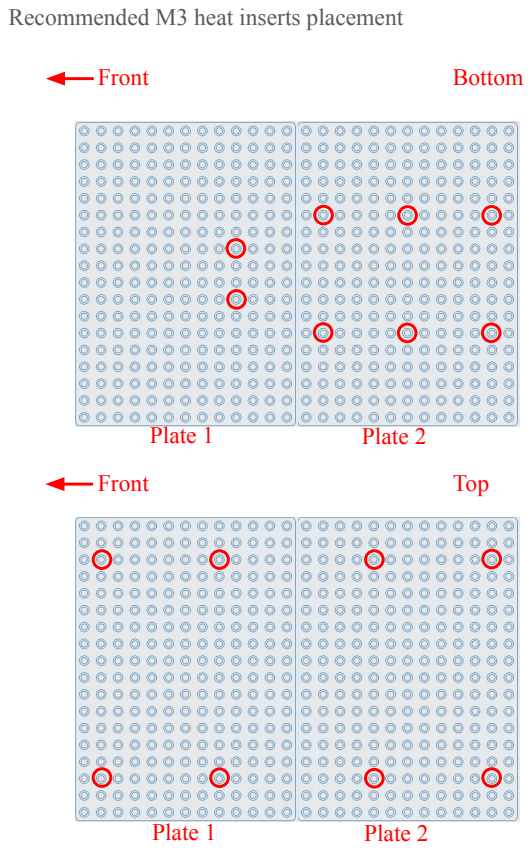
[picture p93: page 5]
Front; Bottom; Top; Plate 1; Plate 2

Recommended M3 heat inserts placement

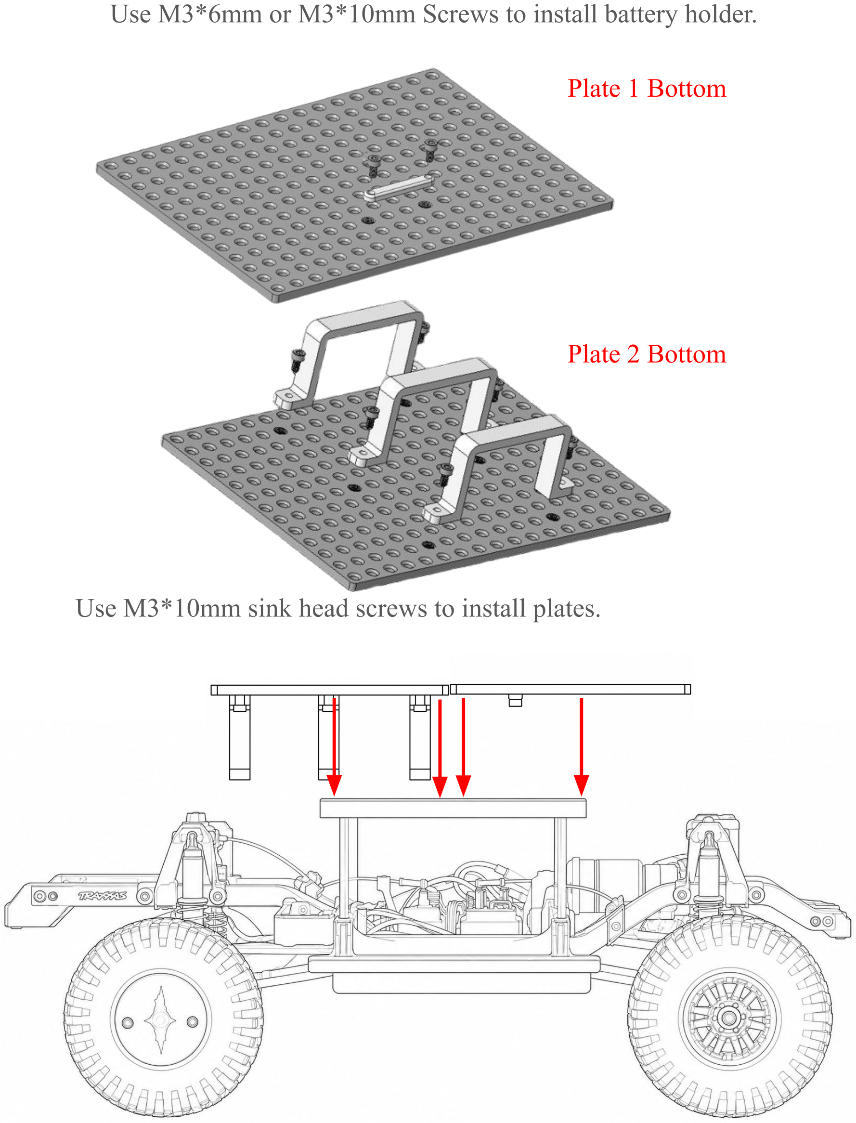
[picture p94: page 6]

Use M3*6mm or M3*10mm Screws to install battery holder.

Plate 2 Bottom

Plate 1 Bottom

Use M3*10mm sink head screws to install plates.


Insert M3*10mm screws to the outer holes and insert the M4*4.7mm heated insert to 4 inner holes.

Install lower shell to the back of the board.

Opening towards back.

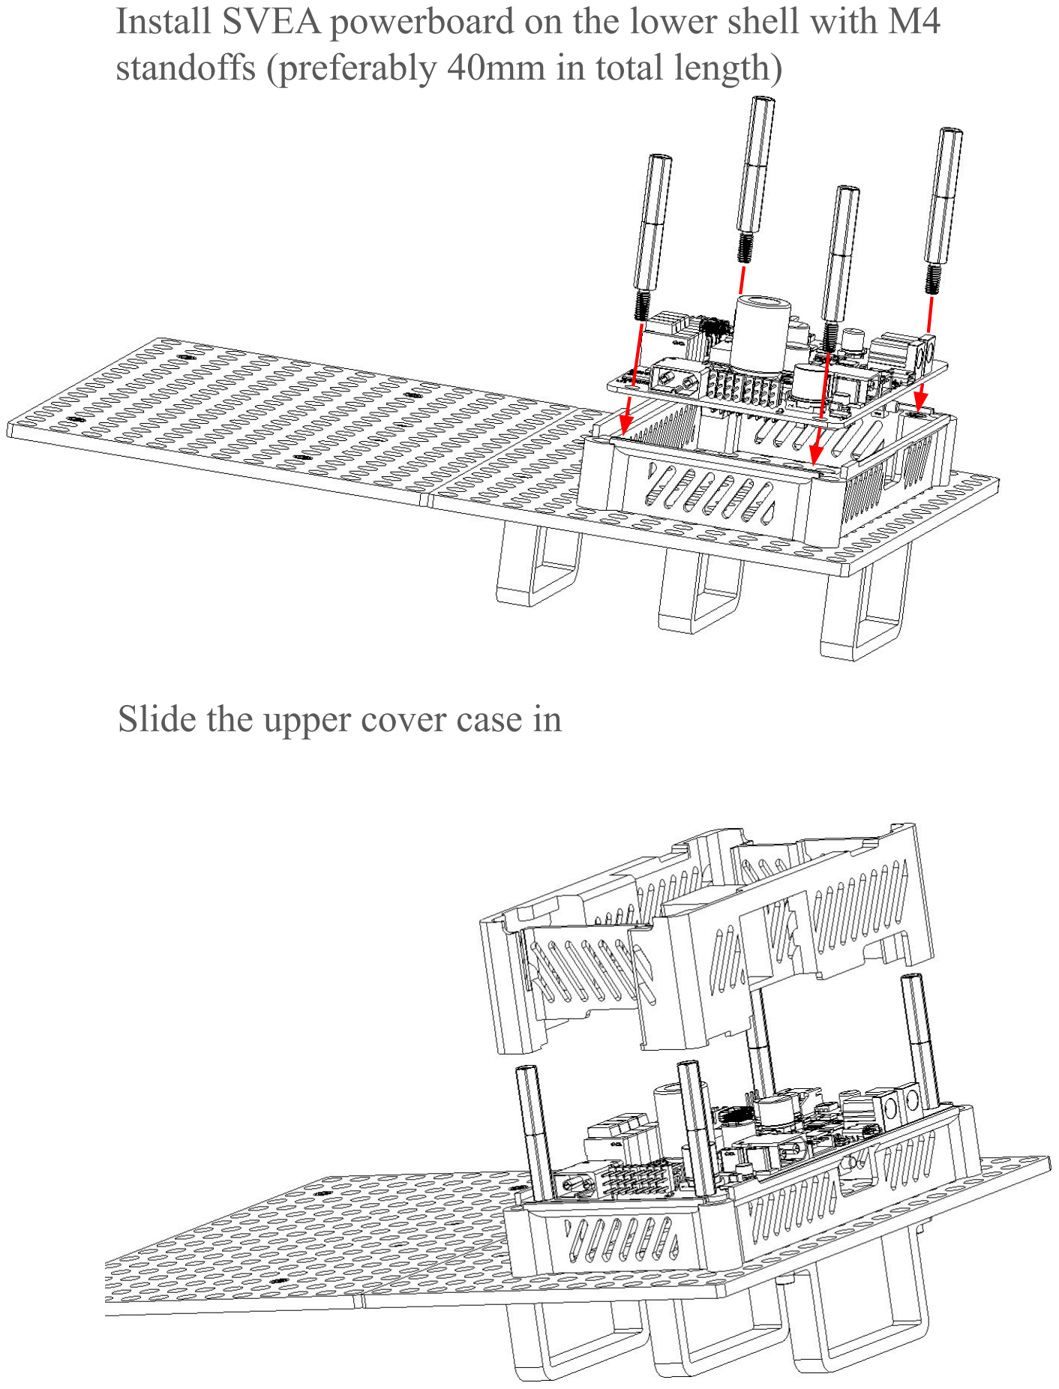
[picture p95: page 8]

Install SVEA powerboard on the lower shell with M4 standoffs (preferably 40mm in total length)

Slide the upper cover case in

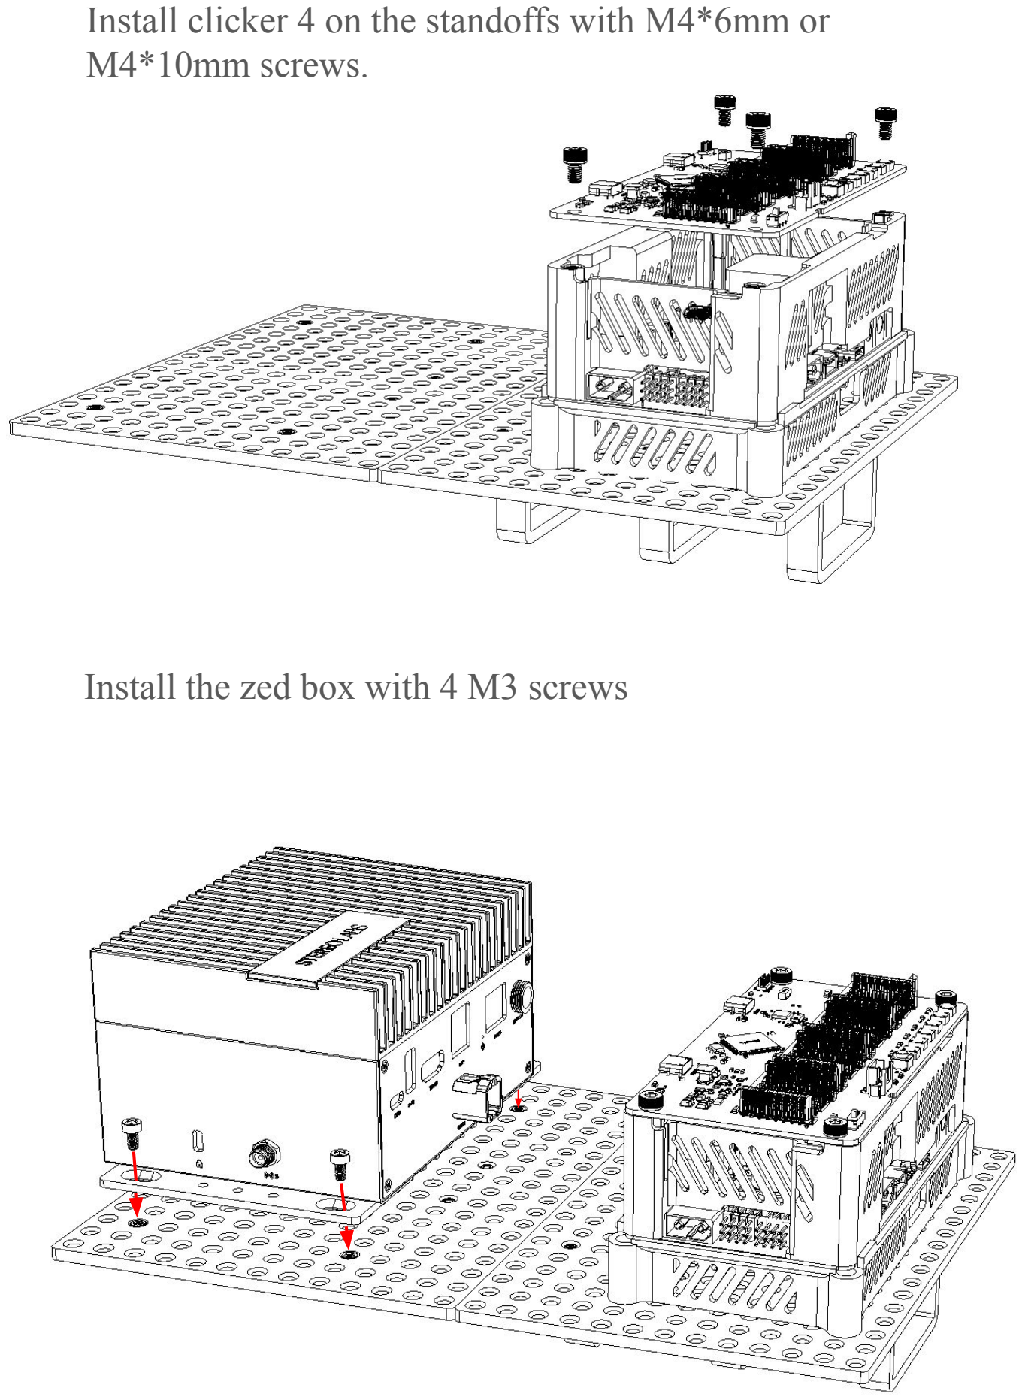
[picture p96: page 9]

Install clicker 4 on the standoffs with M4*6mm or M4*10mm screws.

Install the zed box with 4 M3 screws

## Encoder


Install h2010 IR sensor to the encoder mount back cover with M3*6mm screws and M3 nuts.

Insert the m3 heat insert to encoder mount.

Remove these two screws for both sides.

Use the screws to install the encoder mount for both side

Install the sensor with M3*10mm

## Encoder Disk

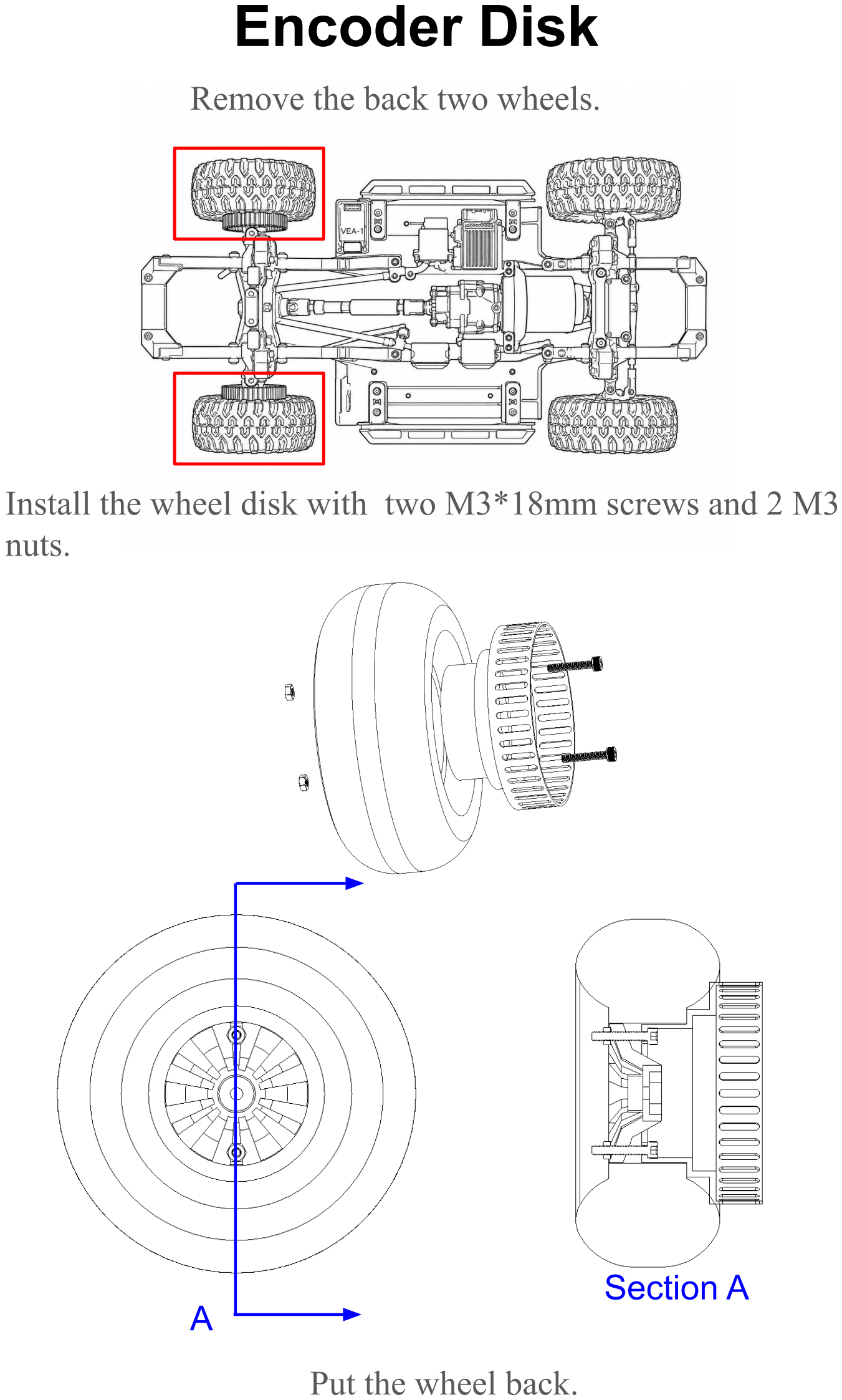
[picture p97: page 11]

Remove the back two wheels.

Install the wheel disk with two M3*18mm screws and 2 M3 nuts.

Put the wheel back.

A

Section A

## Lidar


Place M3 nuts to the lidar mount assist bar.

Temporarily remove the front bumper holder.

Place the lidar mount assist bar in the front bumper holder.

Install lidar to the lidar mount with two m3*10mm screws.

Install the mount to the bumper holder with 3 M3*10mm screws. And install the bumper back to the front of the car.
