KTH-SML/svea_parts/(commit log)

2026-05-13 Update: added various parts commonly used on svea 2.0
    Svea 2.0 made use of https://github.com/KTH-SML/Powerboard2
    [_Annikas IMU (probably not interference but whatev.c6cc2b10-ba41-4698-b681-40151d34f9de.f3d, _Assembling Shell.280da9dd-e7b0-4015-9ee3-a6b9d5b45548.f3d, _Bottom Attatchment.85361469-475e-472e-92d3-0b1b0a94a3bd.f3d, _Buttplate.dddcba6a-b637-411e-a0d3-630e7861f6d8.f3d, _GPS holder.9b4c6a14-adf5-428e-8618-3bced4a97906.f3d, _Lidar v4.199e480f-8d48-4335-8f53-5563380a8b35.f3d, _Lipo holder.3821010a-fb6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]
2026-05-13 Update: files which had broken references and moved out of subfolder
    [MPU Mount (BNO55) v2.f3d, MPU Mount (SEEED ICM) v7.f3d, Shell Mount v28.f3d, Sulthan Cam Pole Lidarr Adapter v6.iges, _Annikas IMU (probably not interference but whatev.c6cc2b10-ba41-4698-b681-40151d34f9de.f3d, _Assembling Shell.280da9dd-e7b0-4015-9ee3-a6b9d5b45548.f3d, _Bottom Attatchment.85361469-475e-472e-92d3-0b1b0a94a3bd.f3d, _Buttplate.dddcba6a-b637-411e-a0d3-630e7861f6d8.f3d]
2026-05-18 add stl and stp
    [svea_battery_holder_8000.stl, svea_battery_holder_9000.stl, svea_battery_holder_9000.stp, svea_battery_stopper.stl, svea_battery_stopper.stp, svea_encoder_asm.stp, svea_encoder_mount.stl, svea_encoder_mount_back_cover.stl]
2026-05-22 update stp files
    [svea_battery_holder_9000.stp, svea_battery_stopper.stp, svea_encoder_asm.stp, svea_half_plate.stp, svea_lidar.stp, svea_plate_mount.stp]
2026-05-22 update stl
    [svea_battery_holder_8000.stl, svea_battery_holder_9000.stl, svea_battery_stopper.stl, svea_encoder_mount.stl, svea_encoder_mount_back_cover.stl, svea_lidar_hat.stl, svea_lidar_mount.stl, svea_lidar_mount_assist.stl]
2026-08-13 all STL and dxf files related to the charging station added
2026-08-16 added charging arm files
2026-08-24 add esp32 files
